datacrystals/InverterGen5/Boards/ControlBoard/ControlBoard.step

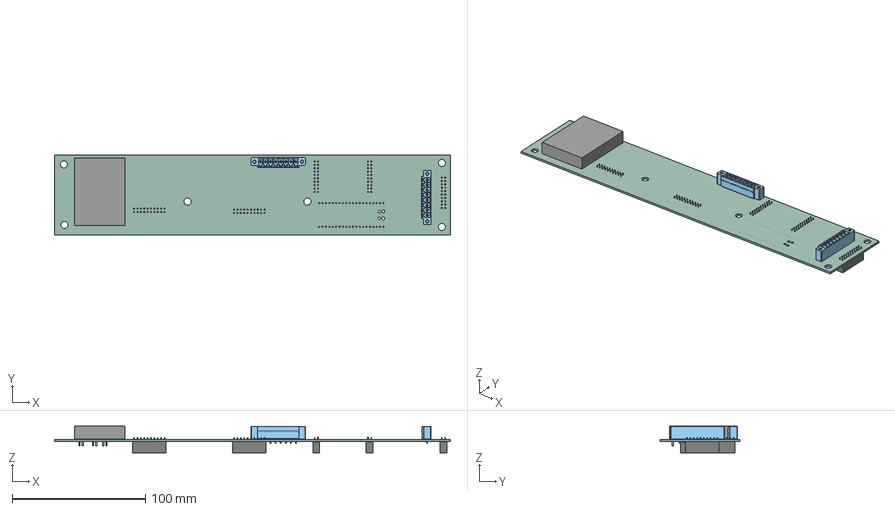
[picture p2: CAD file, 2026-01-23]
Boards/ControlBoard/ControlBoard.step
297.5 x 60.0 x 20.1 mm
TBP02R2W-381-08BE x 2
Pico
Leads
PinSocket_2x10_P2.54mm_Vertical x 5
ControlBoard_PCB
