datacrystals/InverterGen5/Boards/DCBusCapacitorBoard/DCBusCapacitorBoard.step

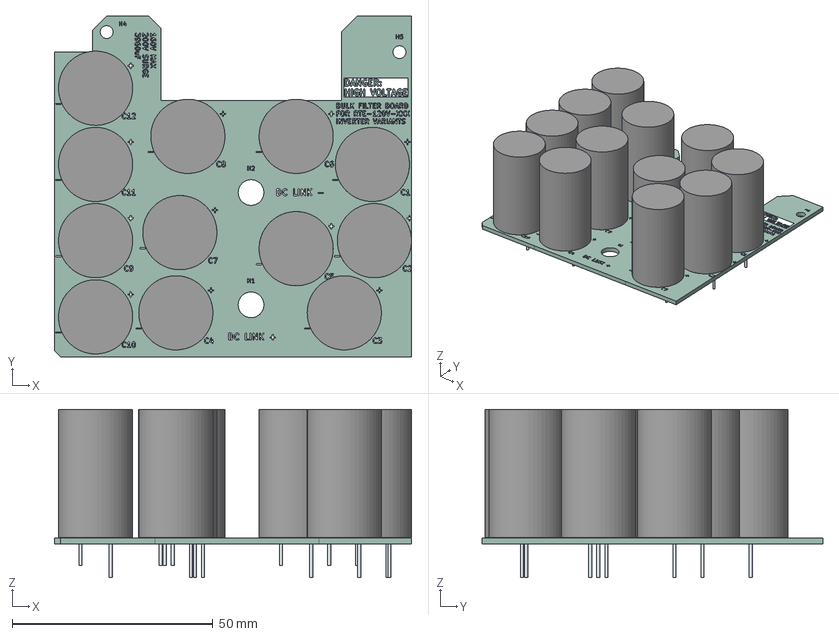
[picture p3: CAD file, 2026-02-06]
Boards/DCBusCapacitorBoard/DCBusCapacitorBoard.step
89.0 x 85.0 x 42.0 mm
SimpleBody x 12
Pin1 x 12
Pin2 x 12
DCBusCapacitorBoard_copper
DCBusCapacitorBoard_silkscreen
DCBusCapacitorBoard_PCB
