datacrystals/InverterGen5/Boards/DCBusFilter/DCBusFilter.step

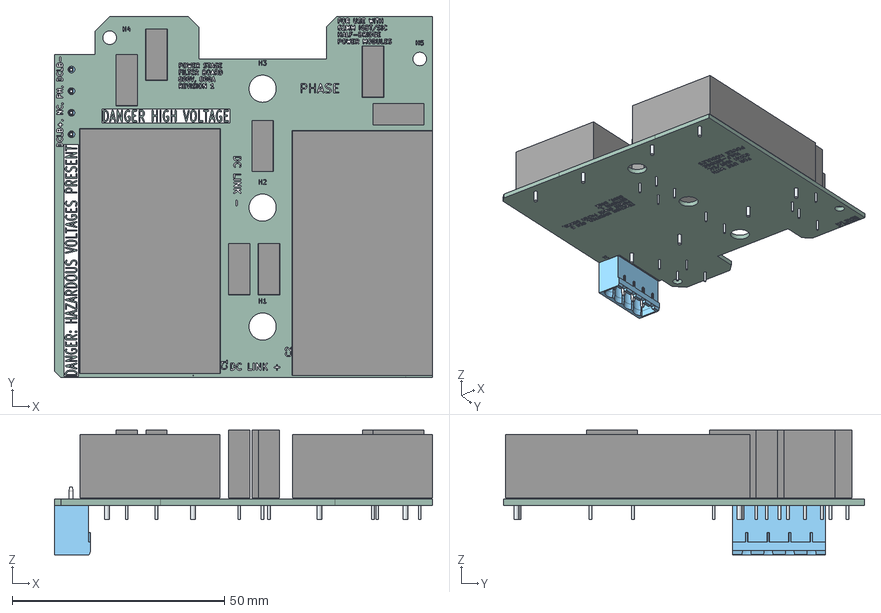
[picture p4: CAD file, 2026-02-06]
Boards/DCBusFilter/DCBusFilter.step
89.0 x 85.0 x 29.4 mm
Leads x 16
TBP01R2-508-04BE
DCBusFilter_copper
DCBusFilter_silkscreen
DCBusFilter_PCB
