datacrystals/InverterGen5/Mechanical/FF600R12KE4BOSA1/3D/FF600R12KE4BOSA1.stp

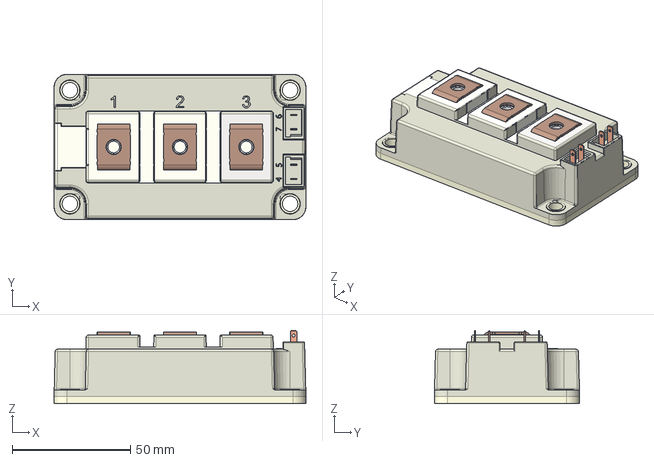
[picture p6: CAD file, 2026-01-23]
Mechanical/FF600R12KE4BOSA1/3D/FF600R12KE4BOSA1.stp
106.4 x 61.4 x 30.9 mm
