datacrystals/InverterGen5/Mechanical/L06P800S05/3D/L06P800S05.stp

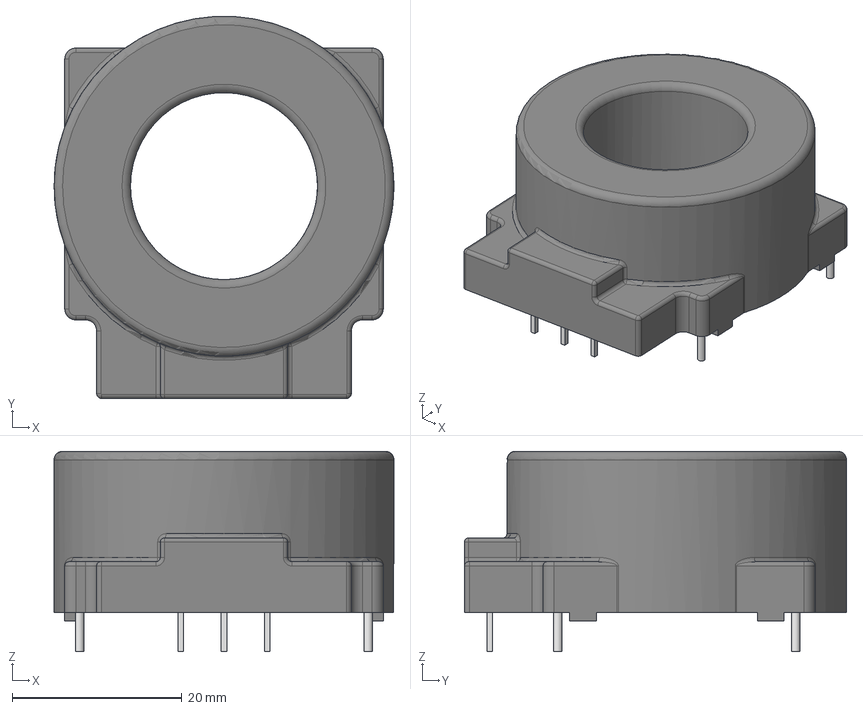
[picture p7: CAD file, 2026-01-23]
Mechanical/L06P800S05/3D/L06P800S05.stp
40.0 x 45.0 x 23.6 mm
