datacrystals/InverterGen5/Mechanical/LA37S600S05KM/3D/LA37S600S05KM.stp

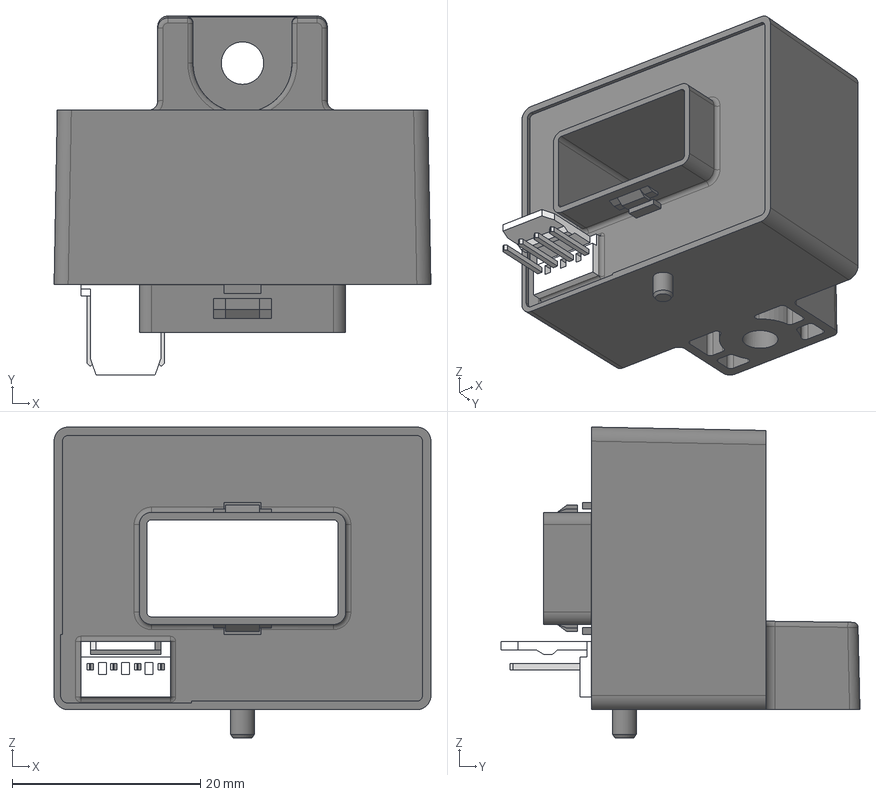
[picture p8: CAD file, 2026-01-23]
Mechanical/LA37S600S05KM/3D/LA37S600S05KM.stp
40.0 x 38.1 x 33.0 mm
