datacrystals/InverterGen5/Mechanical/TBP01P1-508-04BE/3D/TBP01P1-508-04BE.stp

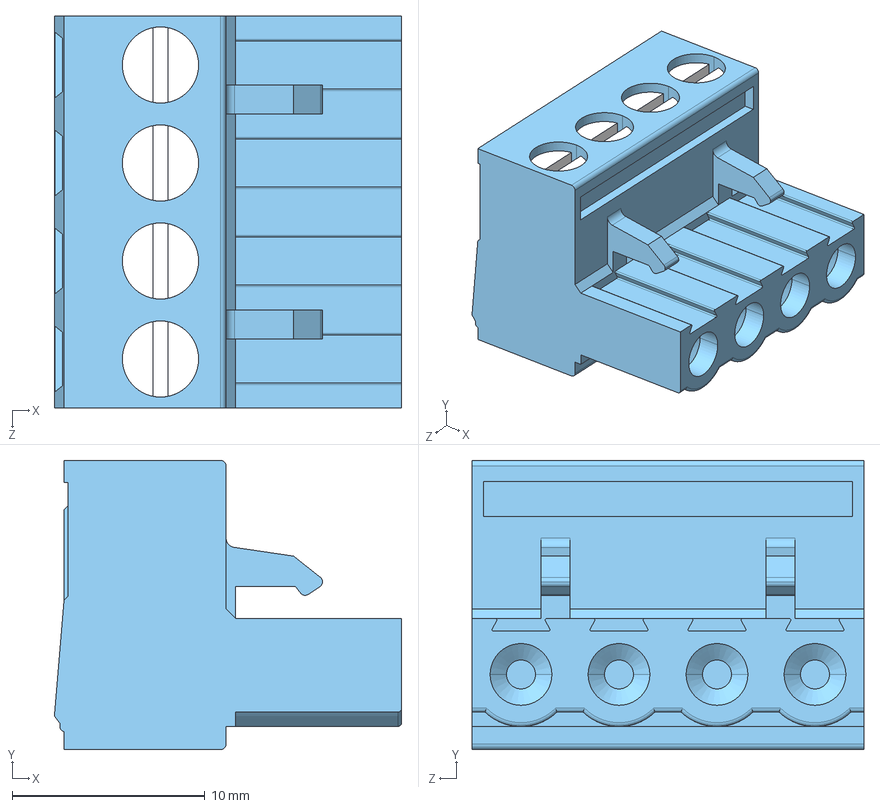
[picture p9: CAD file, 2026-01-24]
Mechanical/TBP01P1-508-04BE/3D/TBP01P1-508-04BE.stp
18.0 x 15.0 x 20.3 mm
