datacrystals/InverterGen5/Mechanical/TBP01P1-508-06BE/3D/TBP01P1-508-06BE.stp

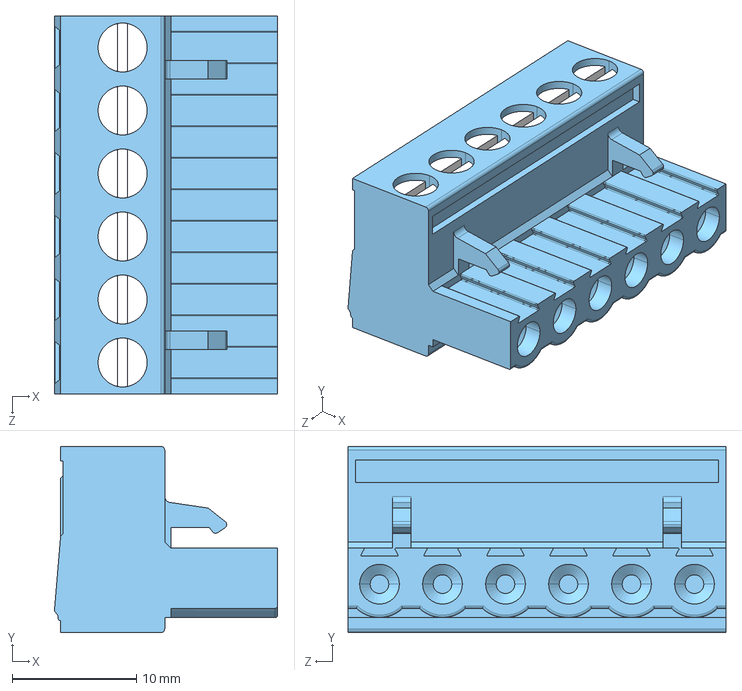
[picture p10: CAD file, 2026-01-23]
Mechanical/TBP01P1-508-06BE/3D/TBP01P1-508-06BE.stp
18.0 x 15.0 x 30.5 mm
