datacrystals/InverterGen5/PartsLib/3D/SCW20A-15.stp

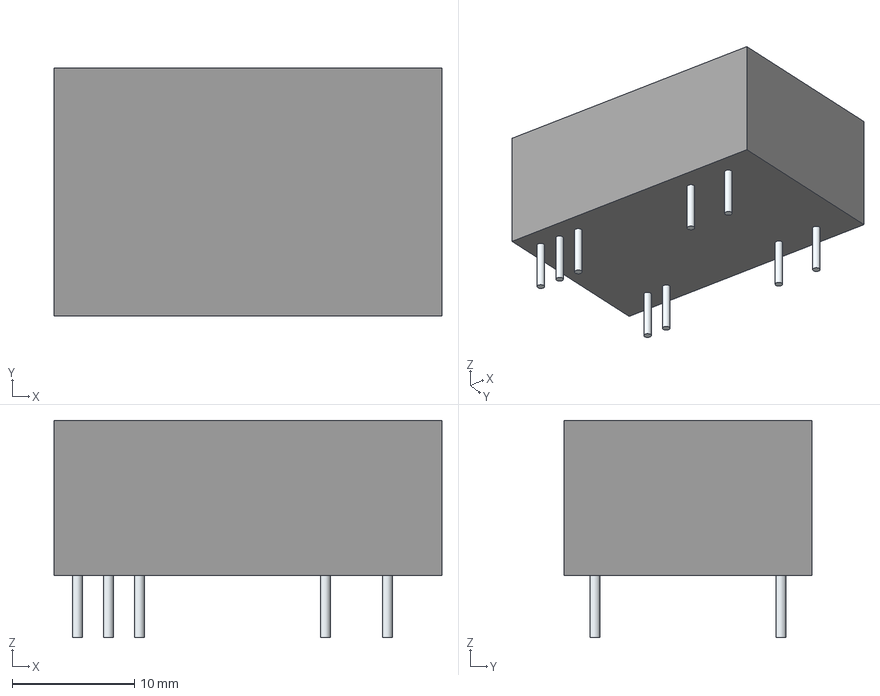
[picture p11: CAD file, 2026-02-06]
PartsLib/3D/SCW20A-15.stp
31.8 x 20.3 x 17.8 mm
Leads
