datacrystals/InverterGen5/PartsLib/3D/UCS2C331MHD.stp

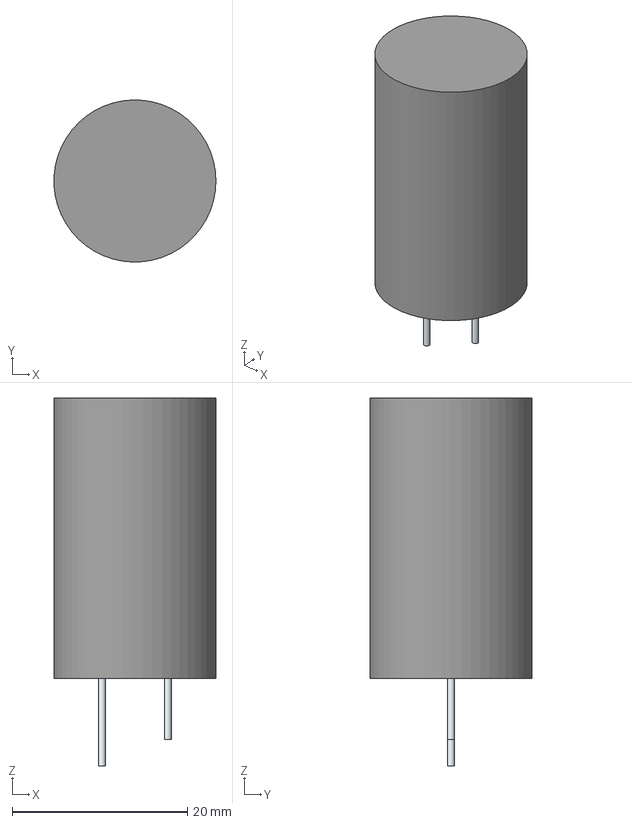
[picture p12: CAD file, 2026-02-06]
PartsLib/3D/UCS2C331MHD.stp
18.5 x 18.5 x 42.0 mm
SimpleBody
Pin1
Pin2
