datacrystals/InverterGen5/PartsLib/3D/MKP1848S61010JY5B.stp

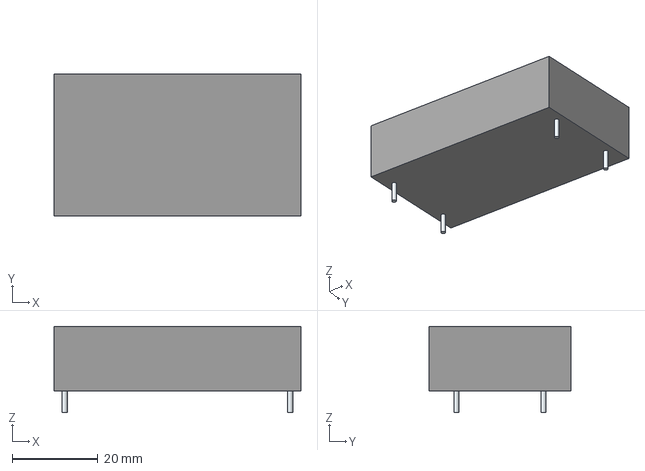
[picture p13: CAD file, 2026-02-06]
PartsLib/3D/MKP1848S61010JY5B.stp
57.5 x 33.0 x 20.1 mm
Leads
