datacrystals/InverterGen5/Mechanical/RaspberryPi_Pico_W_AddedHeaders.step

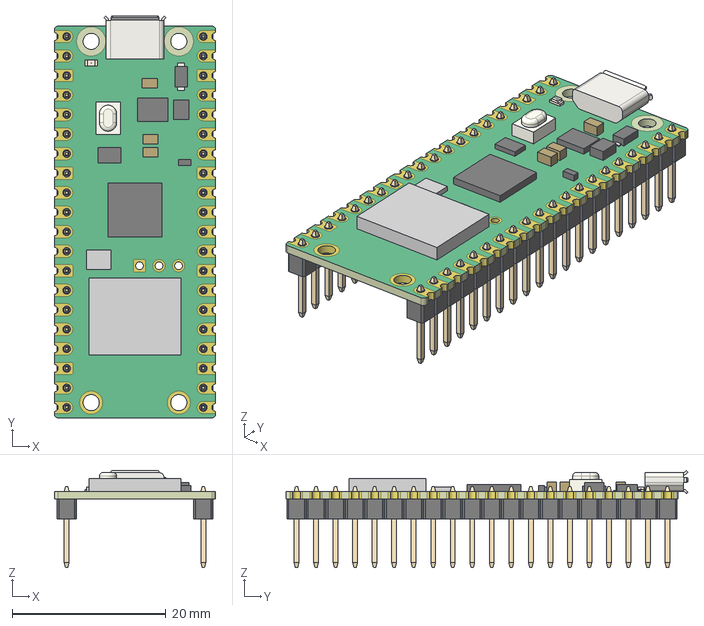
[picture p14: CAD file, 2026-01-25]
Mechanical/RaspberryPi_Pico_W_AddedHeaders.step
21.0 x 52.3 x 12.6 mm
