datacrystals/InverterGen5/PartsLib/3D/VY1222M47Y5UQ6TV0.stp

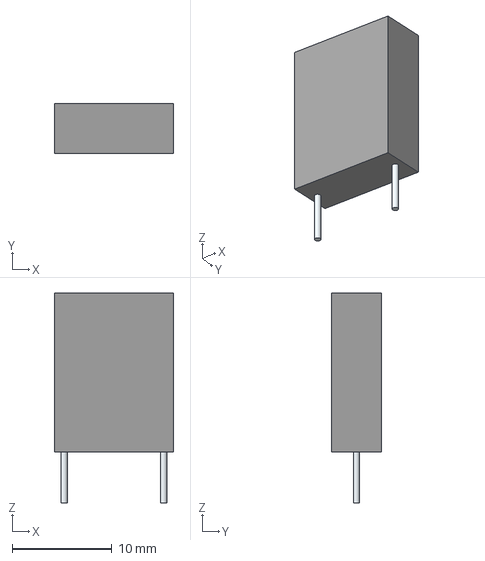
[picture p15: CAD file, 2026-01-25]
PartsLib/3D/VY1222M47Y5UQ6TV0.stp
12.0 x 5.00 x 21.1 mm
Leads x 2
