datacrystals/InverterGen5/PartsLib/3D/TBP01R2-508-06BE.stp

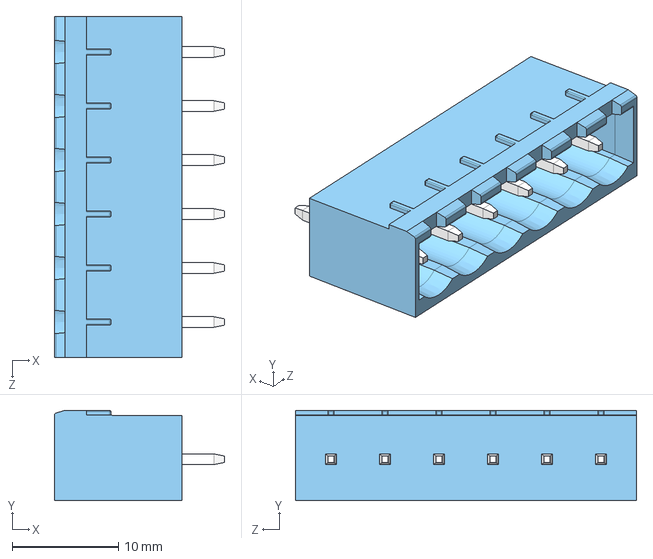
[picture p16: CAD file, 2026-01-24]
PartsLib/3D/TBP01R2-508-06BE.stp
16.0 x 8.50 x 32.1 mm
