datacrystals/InverterGen5/PartsLib/3D/MJE3055TG.stp

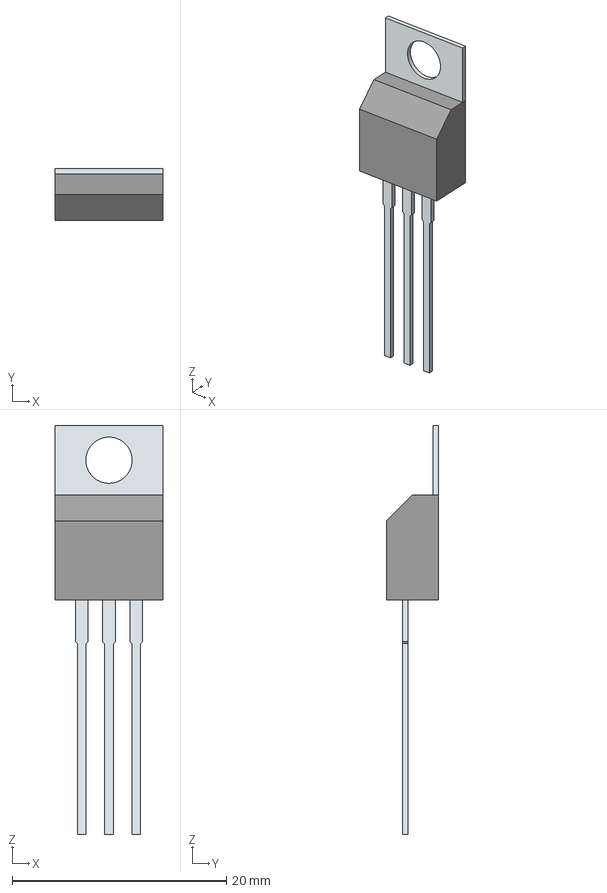
[picture p17: CAD file, 2026-01-23]
PartsLib/3D/MJE3055TG.stp
10.1 x 4.83 x 38.1 mm
Tab
PinsArray
