datacrystals/InverterGen5/PartsLib/3D/DRDNB21D-7.stp

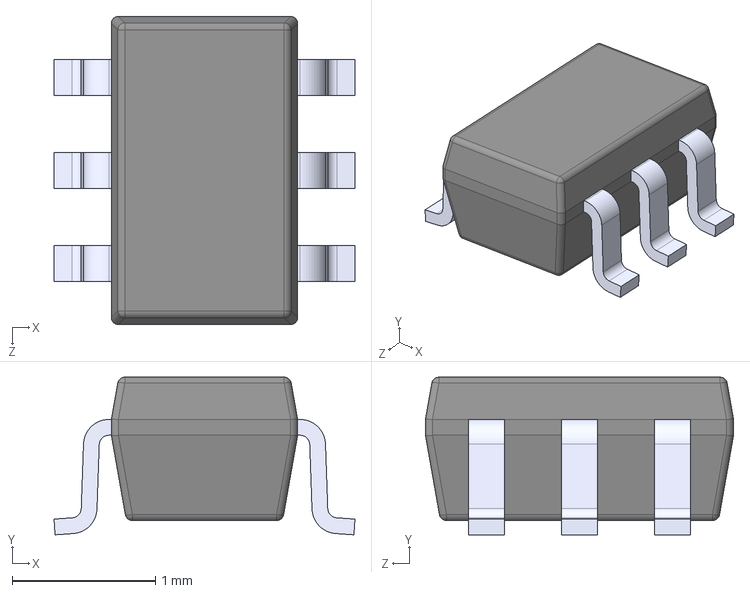
[picture p18: CAD file, 2026-01-23]
PartsLib/3D/DRDNB21D-7.stp
2.10 x 1.10 x 2.15 mm
