datacrystals/InverterGen5/PartsLib/3D/REC10K-2415SAW_H2.stp

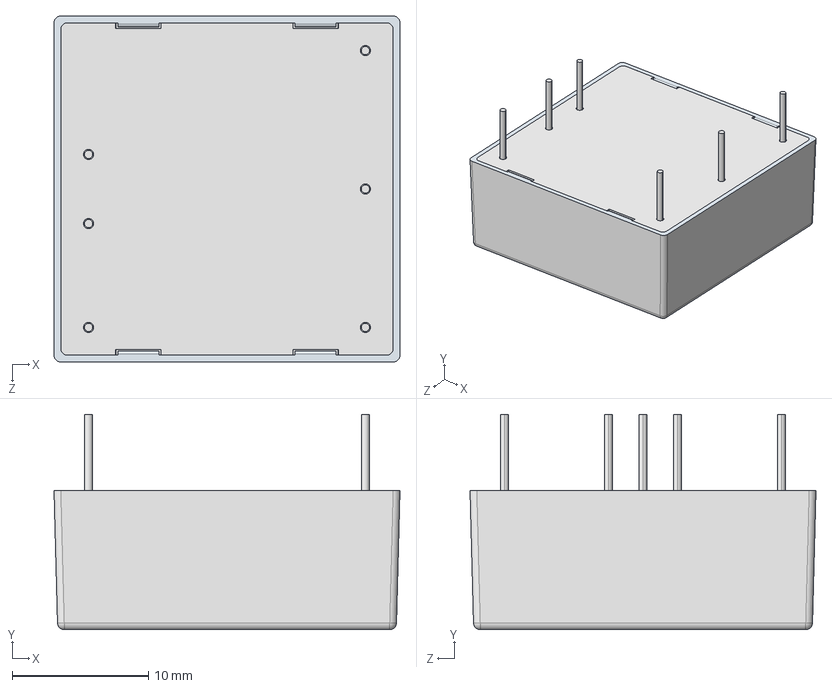
[picture p19: CAD file, 2026-01-23]
PartsLib/3D/REC10K-2415SAW_H2.stp
25.4 x 15.8 x 25.4 mm
