datacrystals/InverterGen5/PartsLib/3D/SN74LXCH8T245PWR.stp

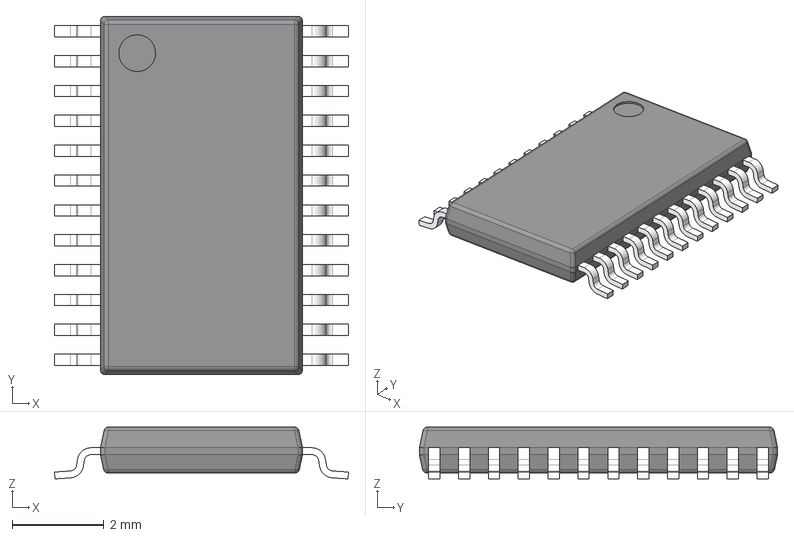
[picture p20: CAD file, 2026-01-23]
PartsLib/3D/SN74LXCH8T245PWR.stp
6.40 x 7.80 x 1.13 mm
BODY-TSSOP
LEAD-TSSOP x 24
PIN1
