datacrystals/InverterGen5/PartsLib/3D/TMP236A2DCKR.stp

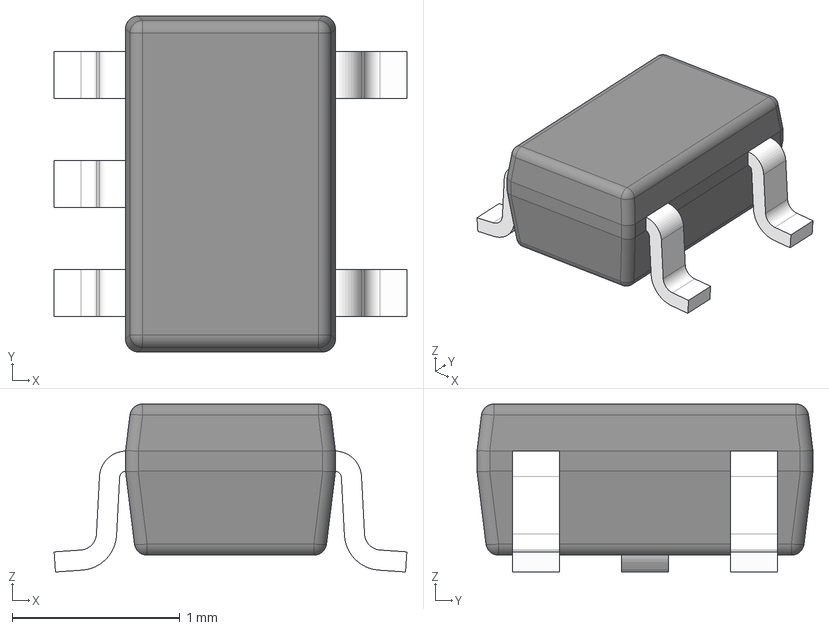
[picture p21: CAD file, 2026-01-23]
PartsLib/3D/TMP236A2DCKR.stp
2.10 x 2.00 x 1.00 mm
BODY-SOT
LEAD-SOT x 5
PIN1-ID
