datacrystals/InverterGen5/PartsLib/3D/FBMJ1608HS220NTR.stp

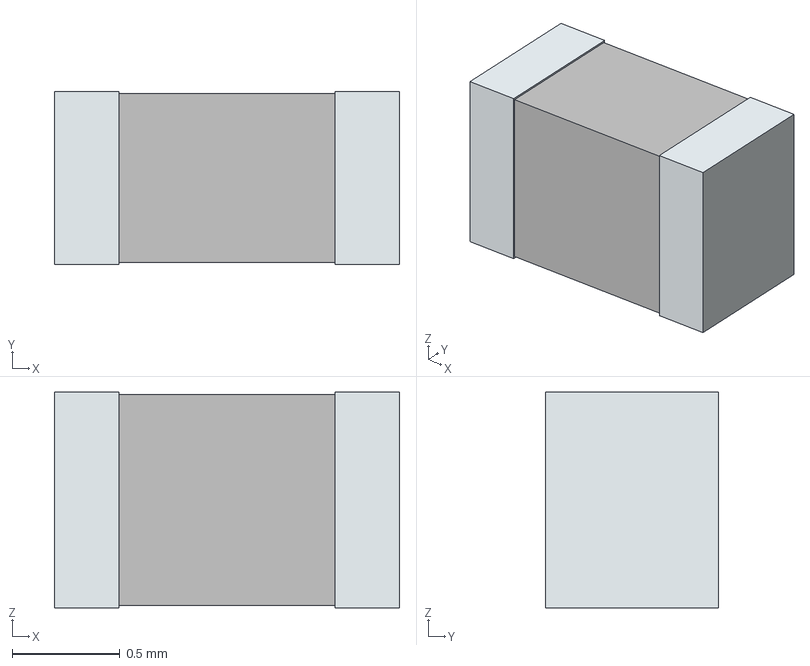
[picture p22: CAD file, 2026-01-23]
PartsLib/3D/FBMJ1608HS220NTR.stp
1.60 x 0.8 x 1.00 mm
term1
term2
