datacrystals/InverterGen5/PartsLib/3D/TBP02R1-381-02BE.stp

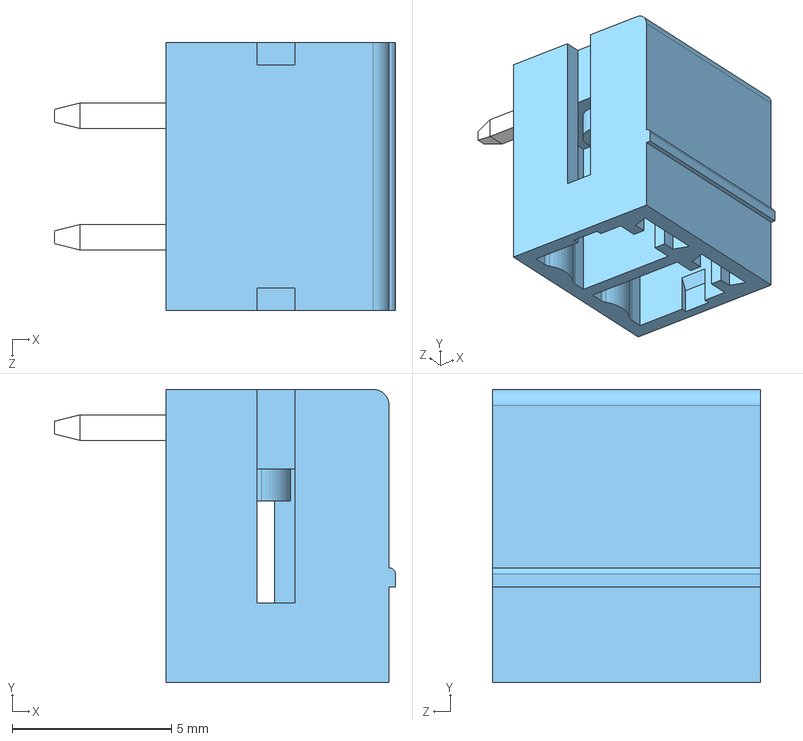
[picture p23: CAD file, 2026-01-23]
PartsLib/3D/TBP02R1-381-02BE.stp
10.7 x 9.20 x 8.41 mm
