datacrystals/InverterGen5/PartsLib/3D/677-15ABPE.stp

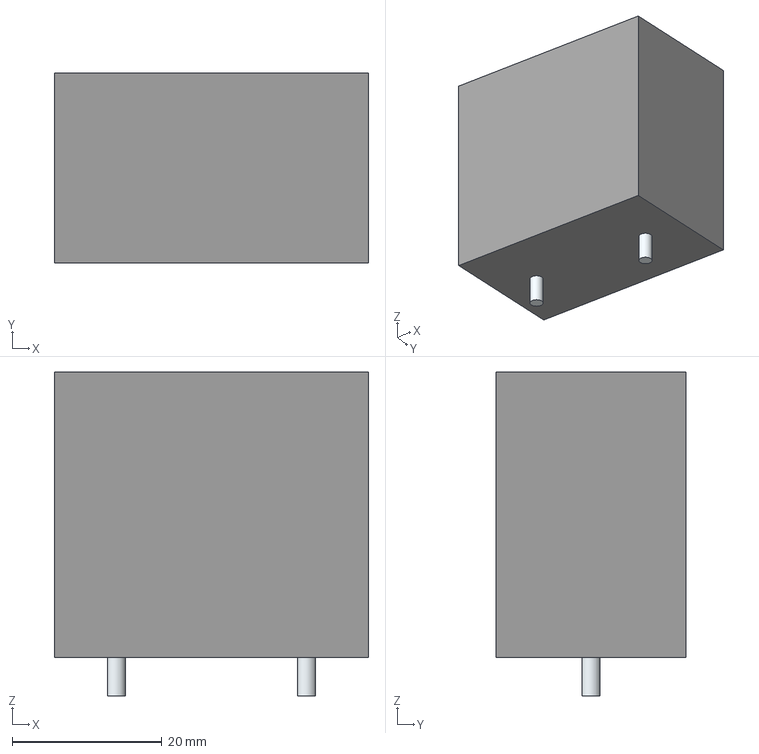
[picture p24: CAD file, 2026-01-23]
PartsLib/3D/677-15ABPE.stp
41.9 x 25.4 x 43.2 mm
Leads
