datacrystals/InverterGen5/PartsLib/3D/LTST-C230CKT.stp

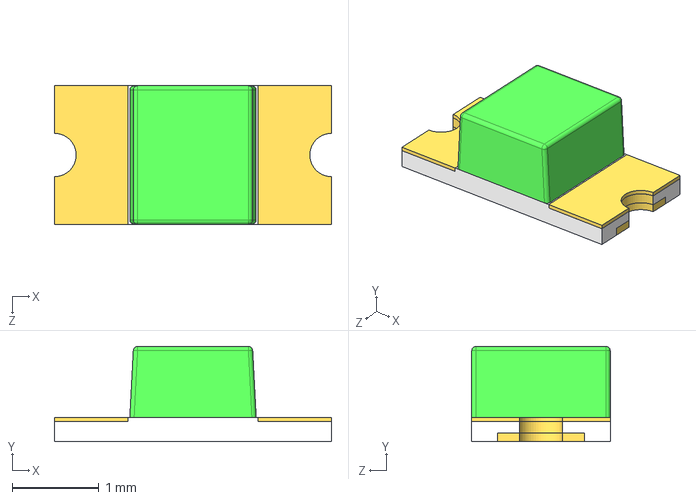
[picture p25: CAD file, 2026-01-23]
PartsLib/3D/LTST-C230CKT.stp
3.20 x 1.10 x 1.60 mm
