datacrystals/InverterGen5/PartsLib/3D/C4AQNBW5200M3LJ.stp

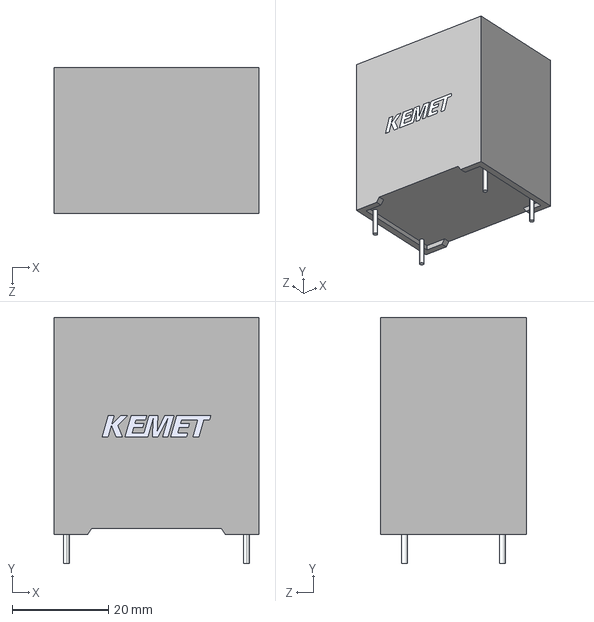
[picture p27: CAD file, 2026-01-23]
PartsLib/3D/C4AQNBW5200M3LJ.stp
42.6 x 51.2 x 30.4 mm
