datacrystals/InverterGen5/PartsLib/3D/MCP2515-e_ST.stp

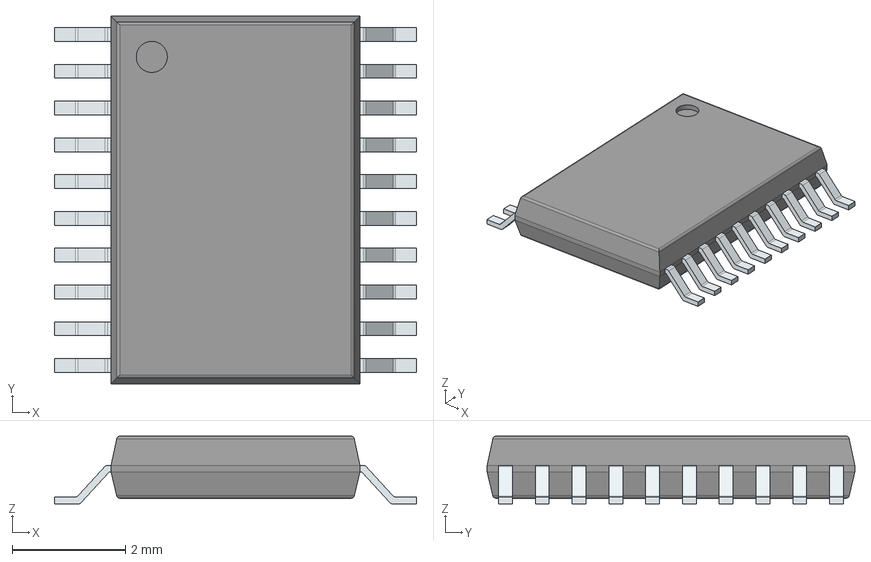
[picture p28: CAD file, 2026-01-23]
PartsLib/3D/MCP2515-e_ST.stp
6.40 x 6.50 x 1.20 mm
PinsArrayLR
