datacrystals/InverterGen5/PartsLib/3D/1SMB5956BT3G.stp

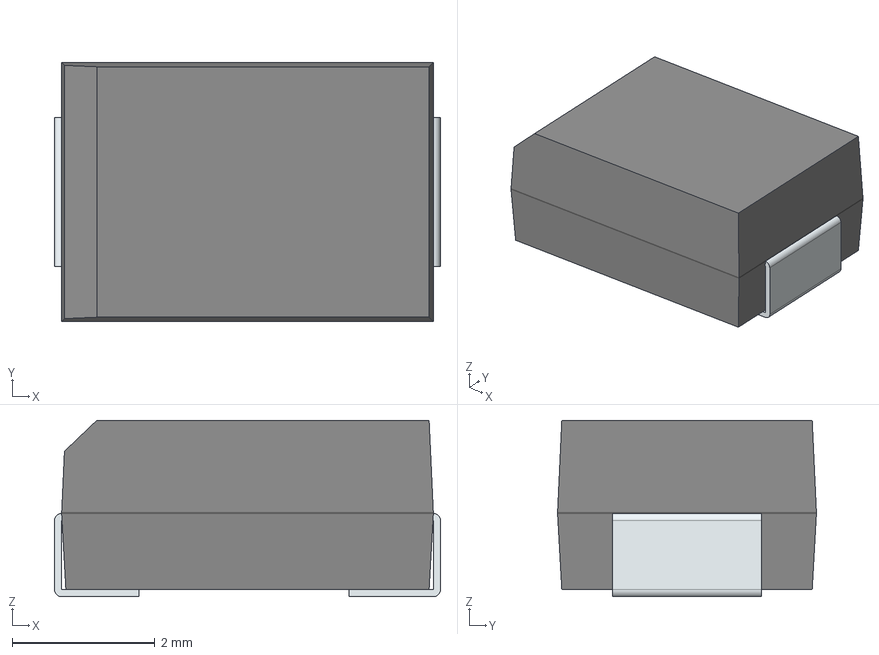
[picture p29: CAD file, 2026-01-23]
PartsLib/3D/1SMB5956BT3G.stp
5.41 x 3.62 x 2.47 mm
FilletPin1
FilletPin2
