datacrystals/InverterGen5/PartsLib/3D/R-78K3.3-1.0.stp

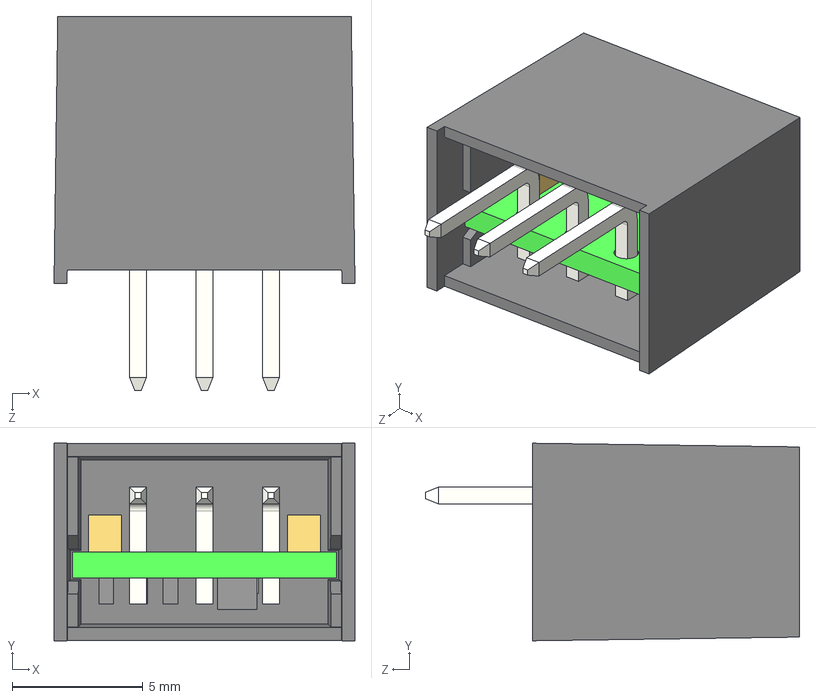
[picture p30: CAD file, 2026-01-23]
PartsLib/3D/R-78K3.3-1.0.stp
11.5 x 7.55 x 14.3 mm
