datacrystals/InverterGen5/PartsLib/3D/JCB0312S24.stp

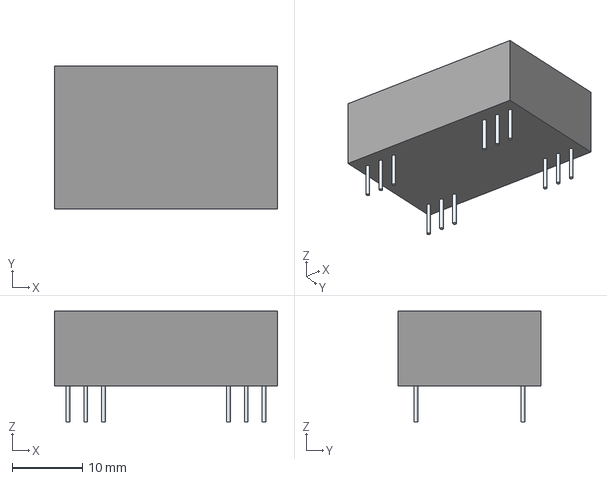
[picture p31: CAD file, 2026-01-23]
PartsLib/3D/JCB0312S24.stp
31.8 x 20.3 x 15.8 mm
Leads
