datacrystals/InverterGen5/PartsLib/3D/TBP01R1-508-08BE.stp

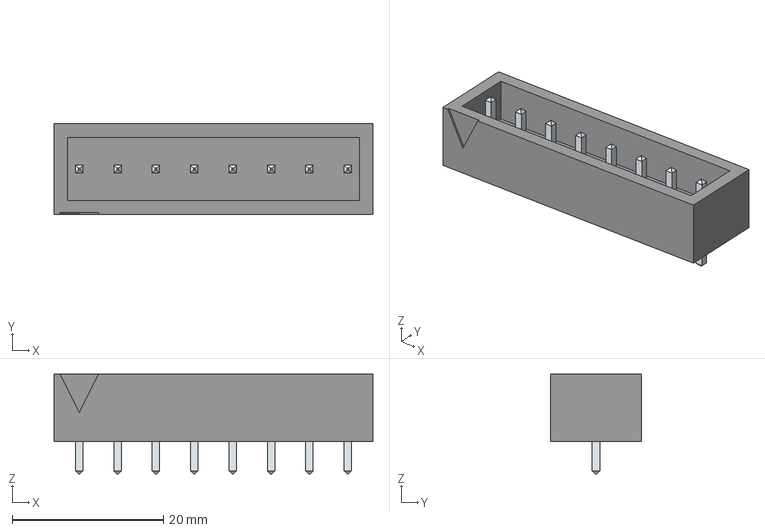
[picture p32: CAD file, 2026-01-23]
PartsLib/3D/TBP01R1-508-08BE.stp
42.2 x 12.0 x 13.2 mm
LeadsArray
