datacrystals/InverterGen5/PartsLib/3D/S3N.stp

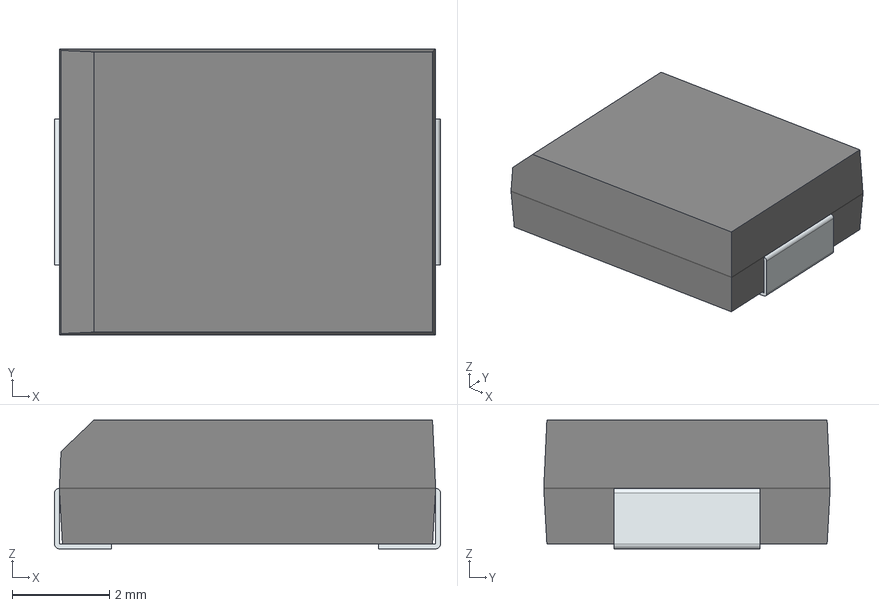
[picture p33: CAD file, 2026-01-23]
PartsLib/3D/S3N.stp
7.95 x 5.90 x 2.65 mm
FilletPin1
FilletPin2
