datacrystals/InverterGen5/PartsLib/3D/TPL7407LAQPWRQ1.stp

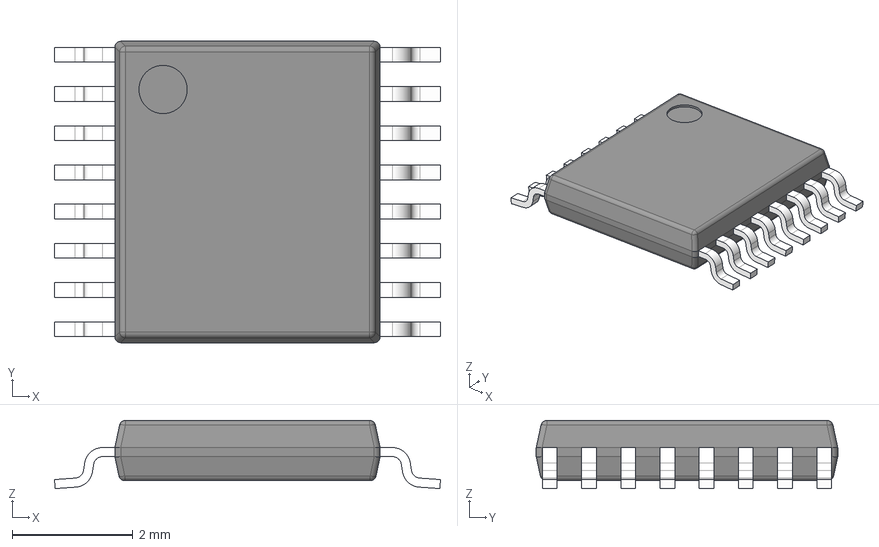
[picture p34: CAD file, 2026-01-23]
PartsLib/3D/TPL7407LAQPWRQ1.stp
6.40 x 5.00 x 1.13 mm
BODY-TSSOP
LEAD-TSSOP x 16
PIN1
