datacrystals/InverterGen5/PartsLib/3D/FZ400R12KE4.stp

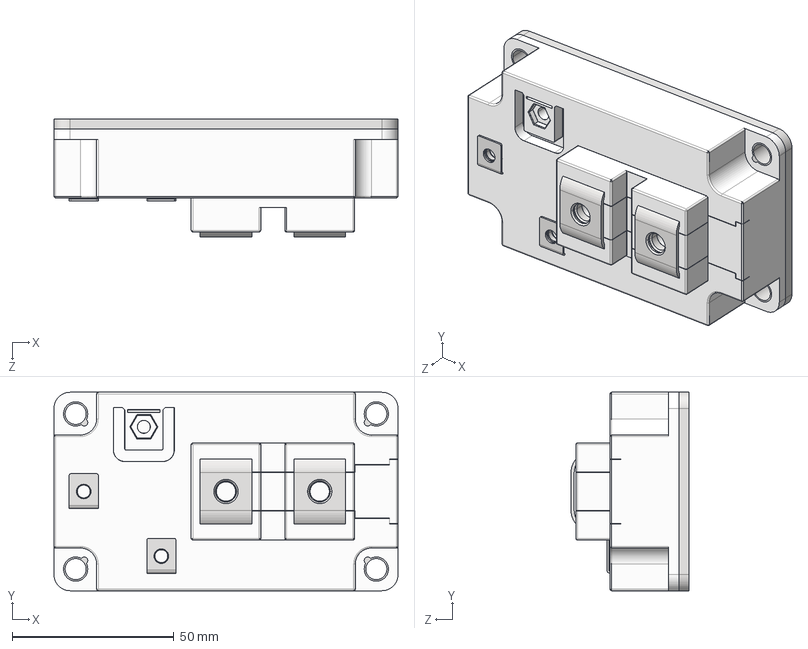
[picture p35: CAD file, 2026-01-23]
PartsLib/3D/FZ400R12KE4.stp
106.4 x 61.4 x 36.5 mm
heatsink
rings
top x 2
nut 2 terminal
terminal small
