datacrystals/InverterGen5/PartsLib/3D/VS-30CDU06HM3_I.stp

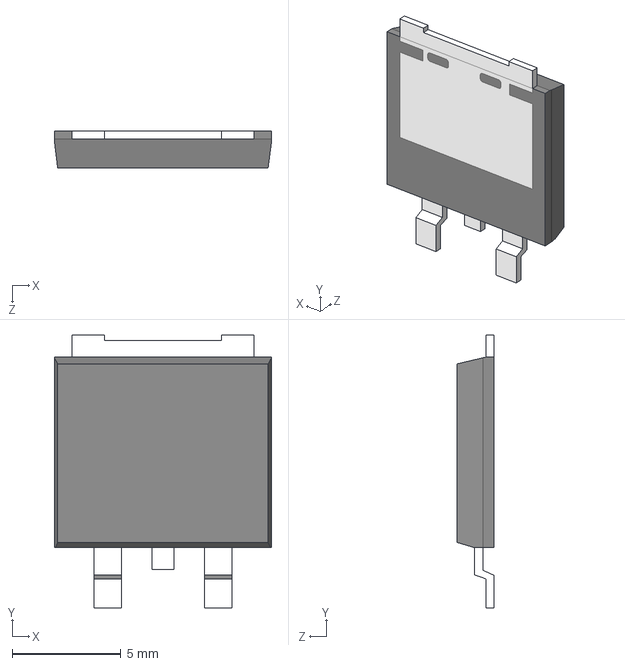
[picture p36: CAD file, 2026-01-23]
PartsLib/3D/VS-30CDU06HM3_I.stp
10.0 x 12.6 x 1.70 mm
