datacrystals/InverterGen5/PartsLib/3D/FM2000GP-TP.stp

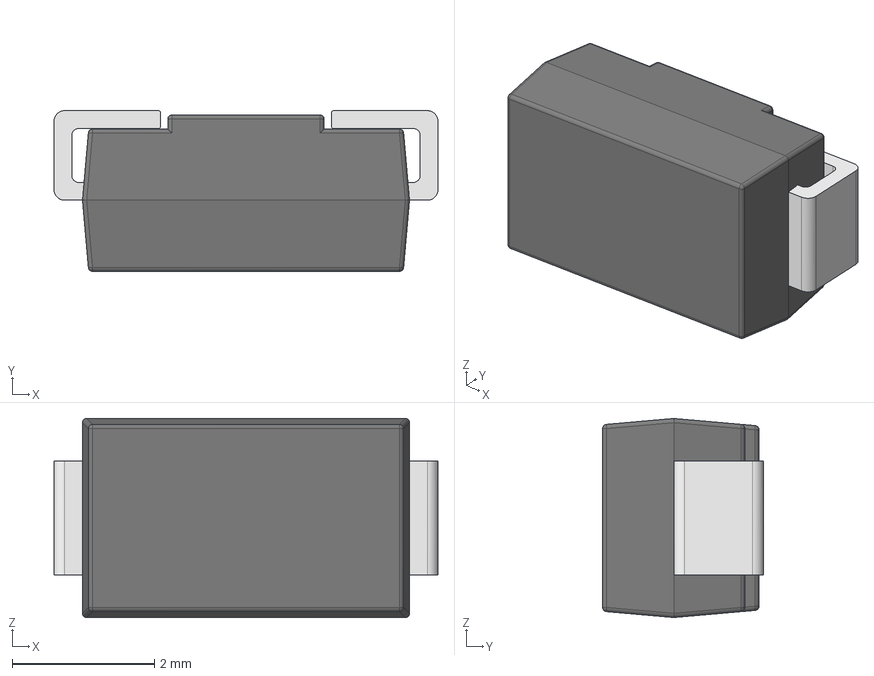
[picture p37: CAD file, 2026-01-23]
PartsLib/3D/FM2000GP-TP.stp
5.40 x 2.26 x 2.80 mm
��1
��2
