datacrystals/InverterGen5/PartsLib/3D/BAT54WS-7-F.stp

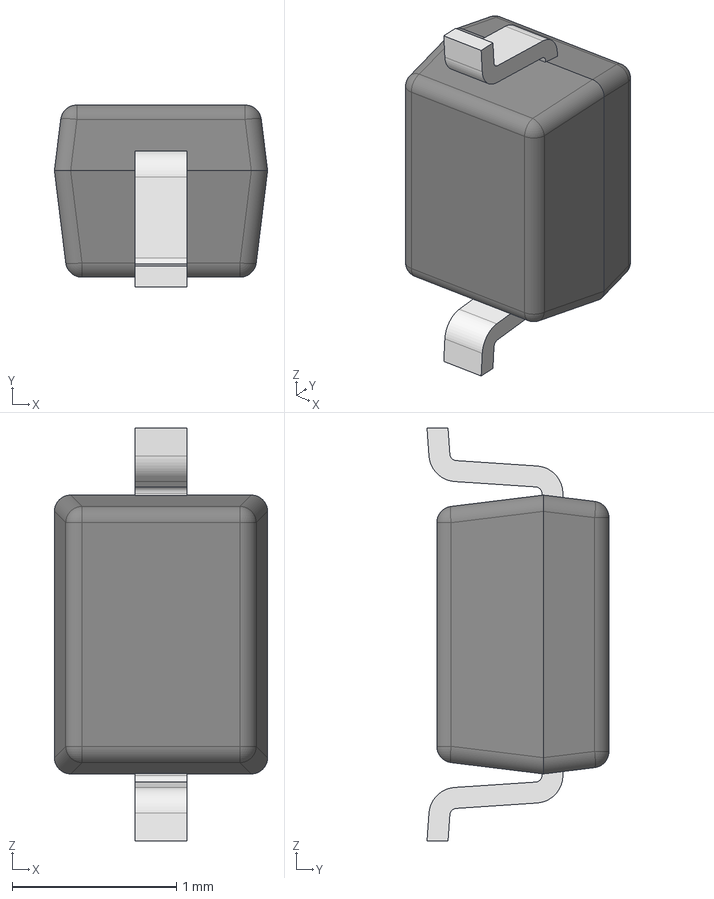
[picture p38: CAD file, 2026-01-23]
PartsLib/3D/BAT54WS-7-F.stp
1.30 x 1.11 x 2.52 mm
SOD323-PCB-001
SOD323-LP-001
