datacrystals/InverterGen5/PartsLib/3D/MUR1100ERLG.stp

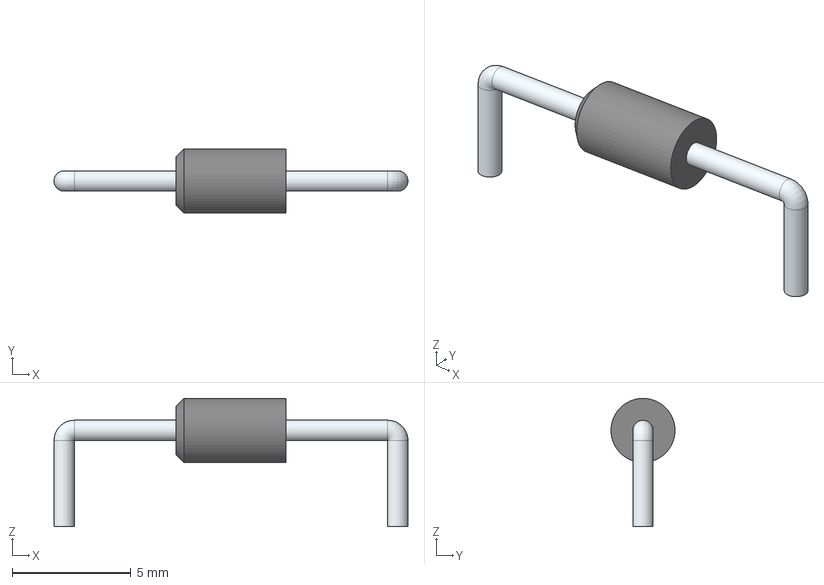
[picture p39: CAD file, 2026-01-23]
PartsLib/3D/MUR1100ERLG.stp
14.9 x 2.70 x 5.40 mm
