datacrystals/InverterGen5/PartsLib/3D/ACS772ECB-400B-PFF-T.stp

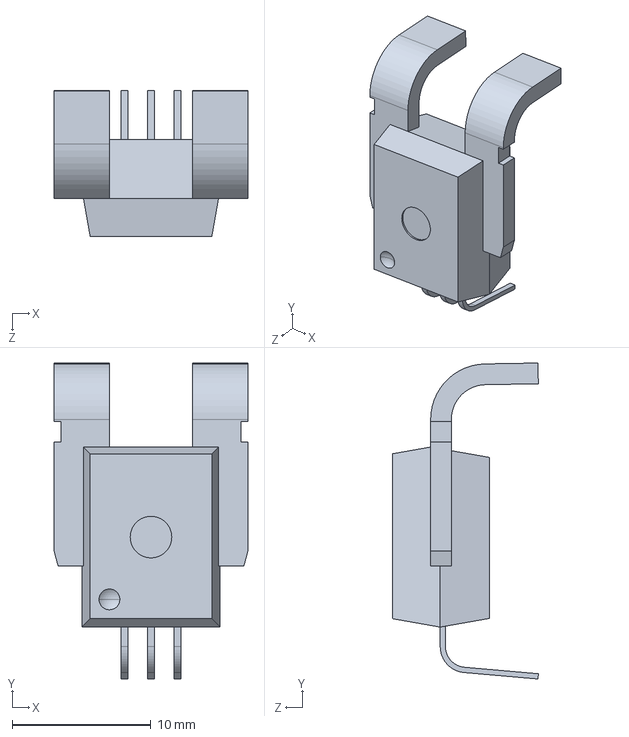
[picture p40: CAD file, 2026-01-23]
PartsLib/3D/ACS772ECB-400B-PFF-T.stp
14.0 x 22.8 x 10.5 mm
