datacrystals/InverterGen5/PartsLib/3D/ADS8688AIDBT.stp

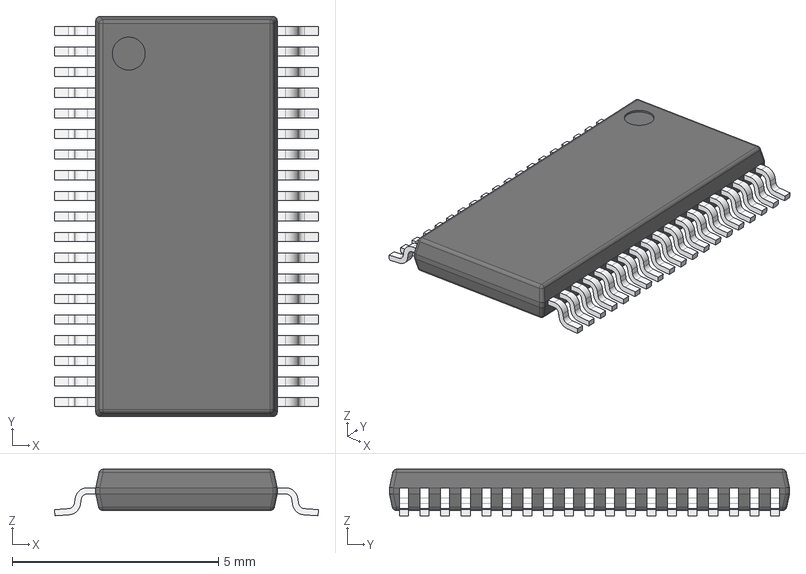
[picture p41: CAD file, 2026-01-23]
PartsLib/3D/ADS8688AIDBT.stp
6.40 x 9.70 x 1.13 mm
BODY-TSSOP
LEAD-TSSOP x 38
PIN1
