datacrystals/InverterGen5/PartsLib/3D/TBP01R2-508-04BE.stp

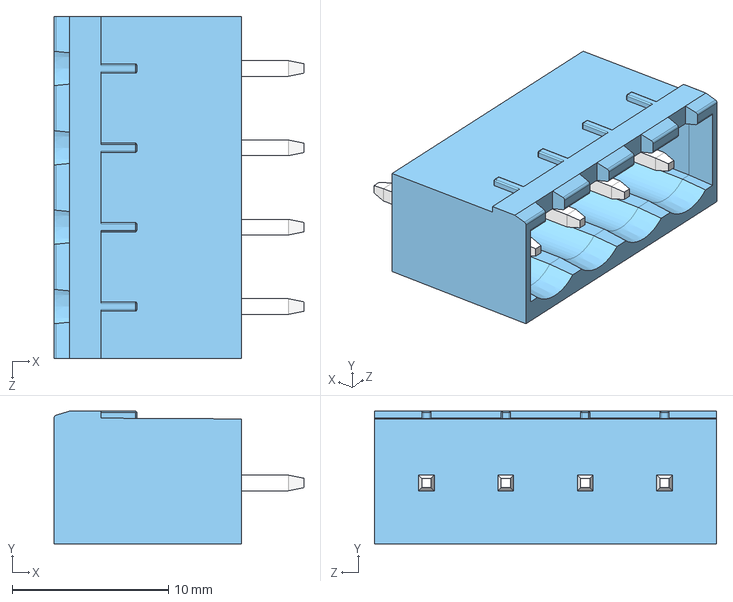
[picture p42: CAD file, 2026-01-23]
PartsLib/3D/TBP01R2-508-04BE.stp
16.0 x 8.50 x 21.9 mm
