datacrystals/InverterGen5/PartsLib/3D/IHDM1008BCEV2R2M20.stp

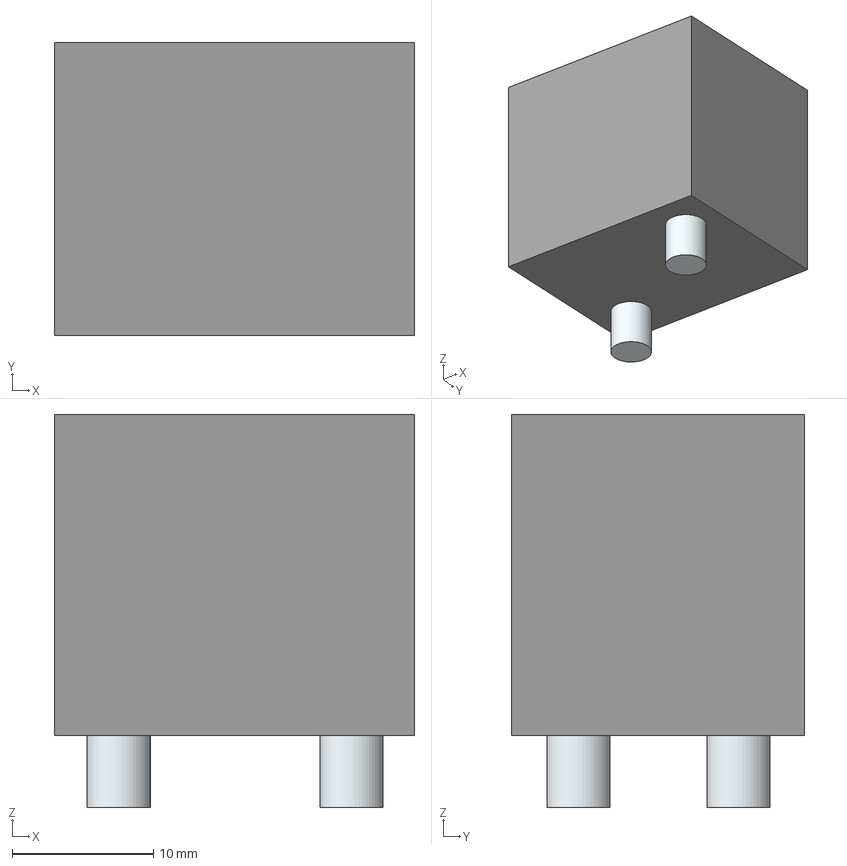
[picture p43: CAD file, 2026-01-23]
PartsLib/3D/IHDM1008BCEV2R2M20.stp
25.5 x 20.7 x 27.9 mm
Leads
