datacrystals/InverterGen5/PartsLib/3D/ACT45B-101-2P-TL003.stp

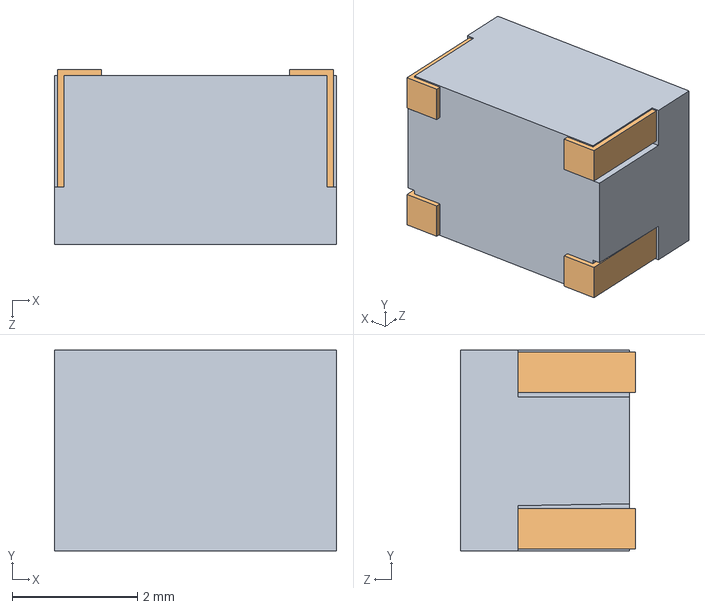
[picture p44: CAD file, 2026-01-23]
PartsLib/3D/ACT45B-101-2P-TL003.stp
4.50 x 3.20 x 2.80 mm
ACT45B DRコアブロック(typ size)
ACT45B 端子ブロック(typ size) x 4
