datacrystals/InverterGen5/PartsLib/3D/SLPX331M200A1P3.stp

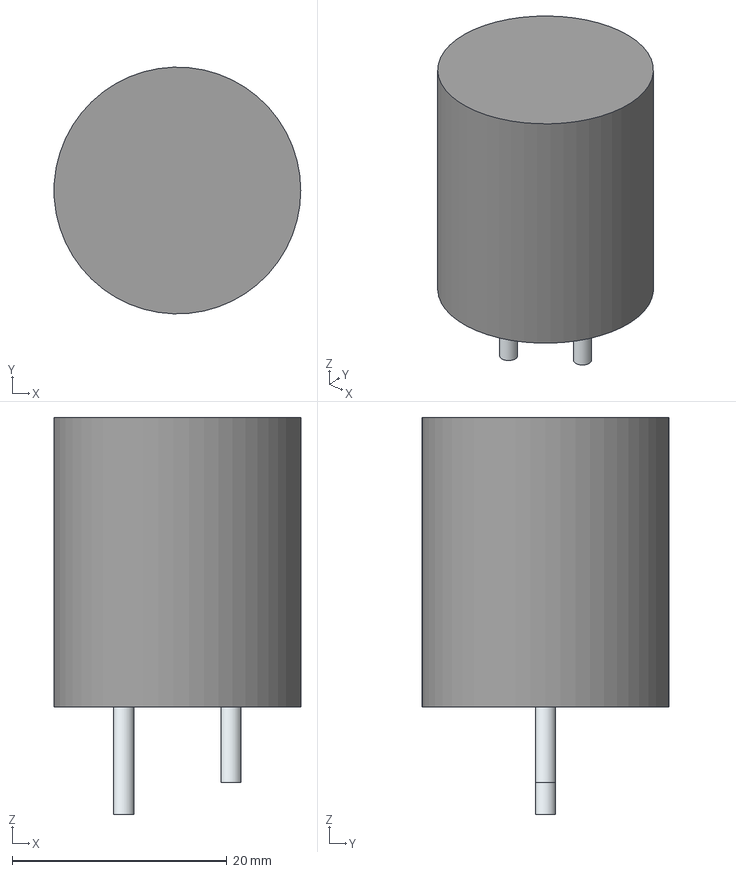
[picture p45: CAD file, 2026-01-23]
PartsLib/3D/SLPX331M200A1P3.stp
23.0 x 23.0 x 37.0 mm
SimpleBody
Pin1
Pin2
