datacrystals/InverterGen5/PartsLib/3D/MF-RHT200_32-2.stp

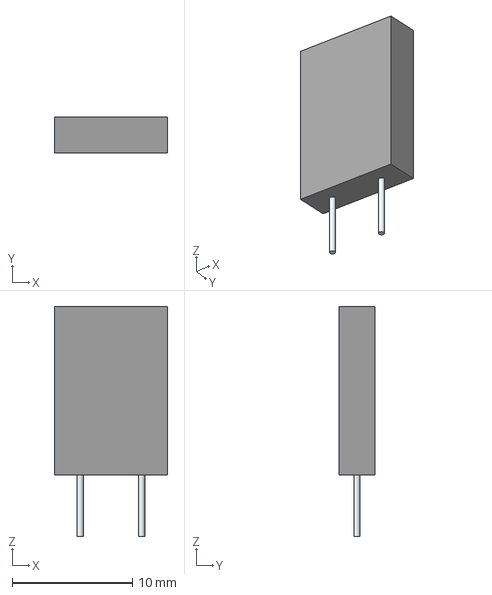
[picture p46: CAD file, 2026-01-23]
PartsLib/3D/MF-RHT200_32-2.stp
9.40 x 3.00 x 19.1 mm
Leads x 2
