datacrystals/InverterGen5/PartsLib/3D/MMSZ5231B-TP.stp

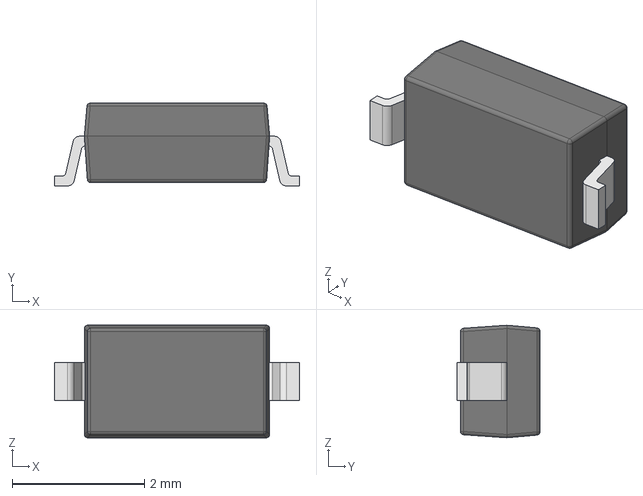
[picture p47: CAD file, 2026-01-23]
PartsLib/3D/MMSZ5231B-TP.stp
3.70 x 1.25 x 1.70 mm
��1
��2
