datacrystals/InverterGen5/PartsLib/3D/DE09-PA-M1.stp

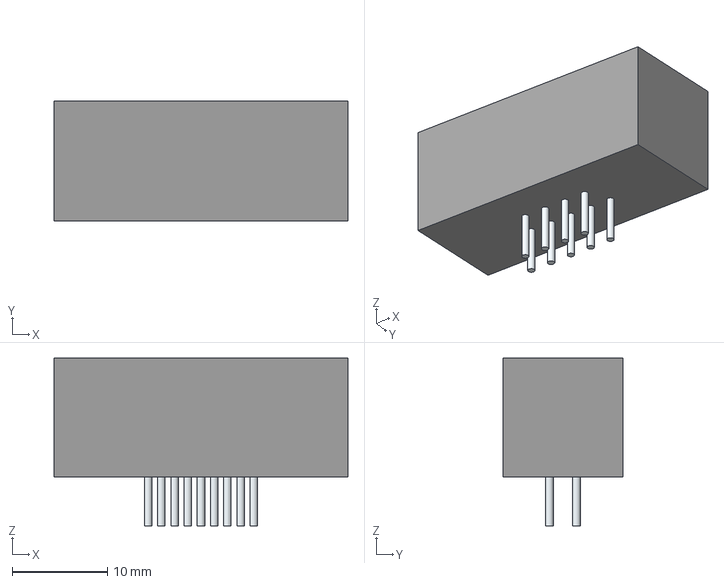
[picture p48: CAD file, 2026-01-23]
PartsLib/3D/DE09-PA-M1.stp
30.8 x 12.6 x 17.6 mm
Leads
