datacrystals/InverterGen5/PartsLib/3D/ALH82A750CB600.stp

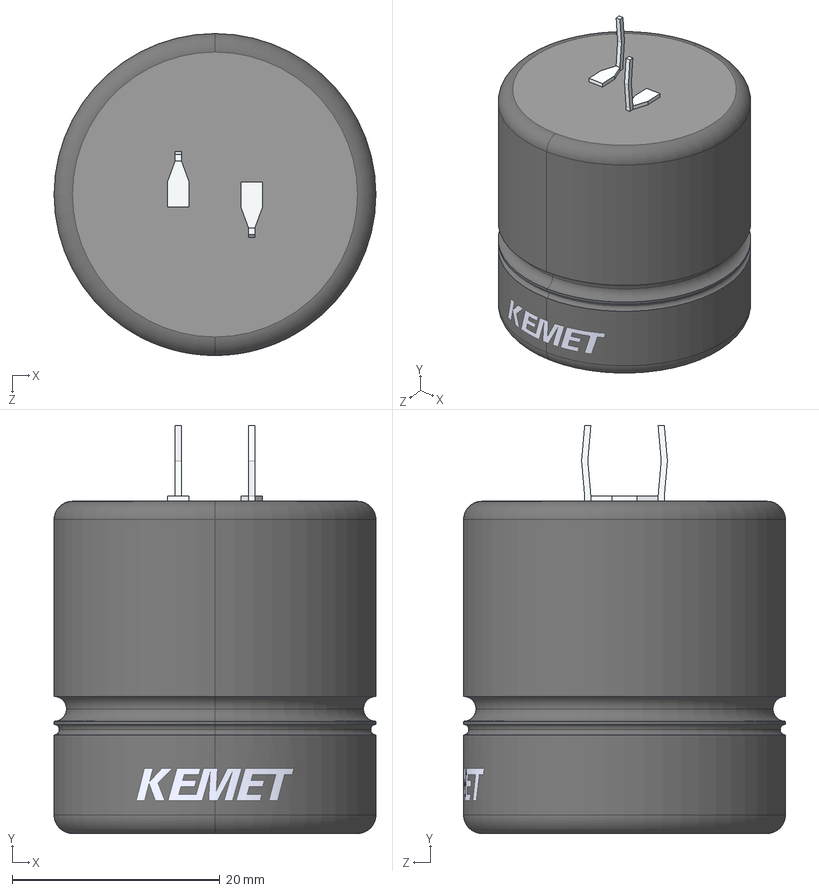
[picture p49: CAD file, 2026-01-23]
PartsLib/3D/ALH82A750CB600.stp
31.0 x 39.3 x 31.0 mm
