datacrystals/InverterGen5/PartsLib/3D/TBP01R1-508-06BE.stp

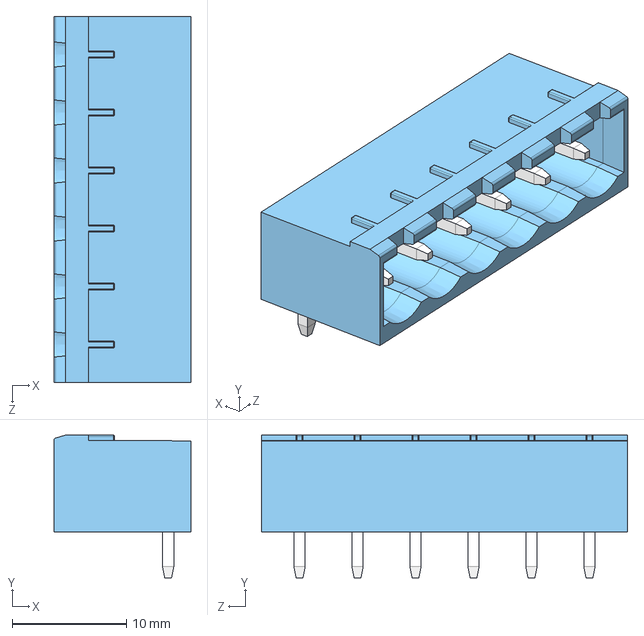
[picture p50: CAD file, 2026-01-23]
PartsLib/3D/TBP01R1-508-06BE.stp
12.0 x 12.5 x 32.1 mm
