datacrystals/InverterGen5/PartsLib/3D/TBP02R1-381-06BE.stp

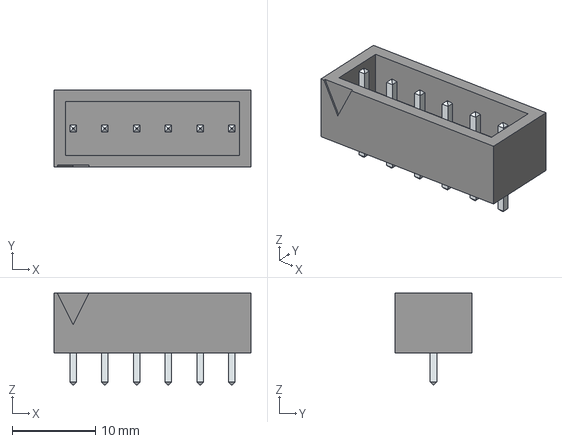
[picture p51: CAD file, 2026-01-23]
PartsLib/3D/TBP02R1-381-06BE.stp
23.7 x 9.20 x 11.0 mm
LeadsArray
