datacrystals/InverterGen5/PartsLib/3D/HCPL-316J-500E.stp

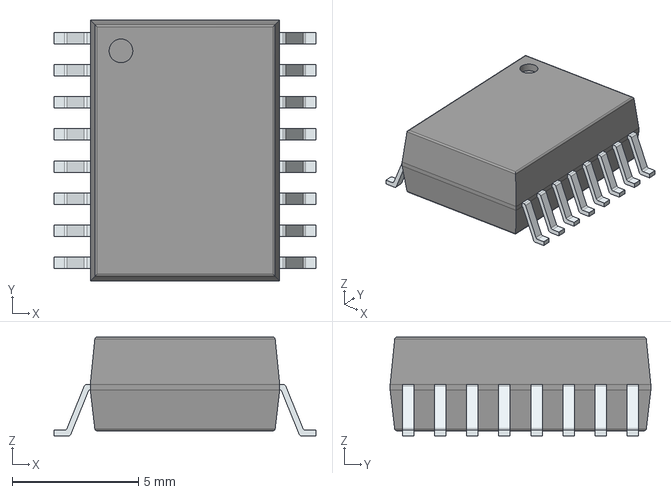
[picture p52: CAD file, 2026-01-23]
PartsLib/3D/HCPL-316J-500E.stp
10.4 x 10.3 x 3.91 mm
PinsArrayLR
