datacrystals/InverterGen5/PartsLib/3D/AWHSH105D00G.stp

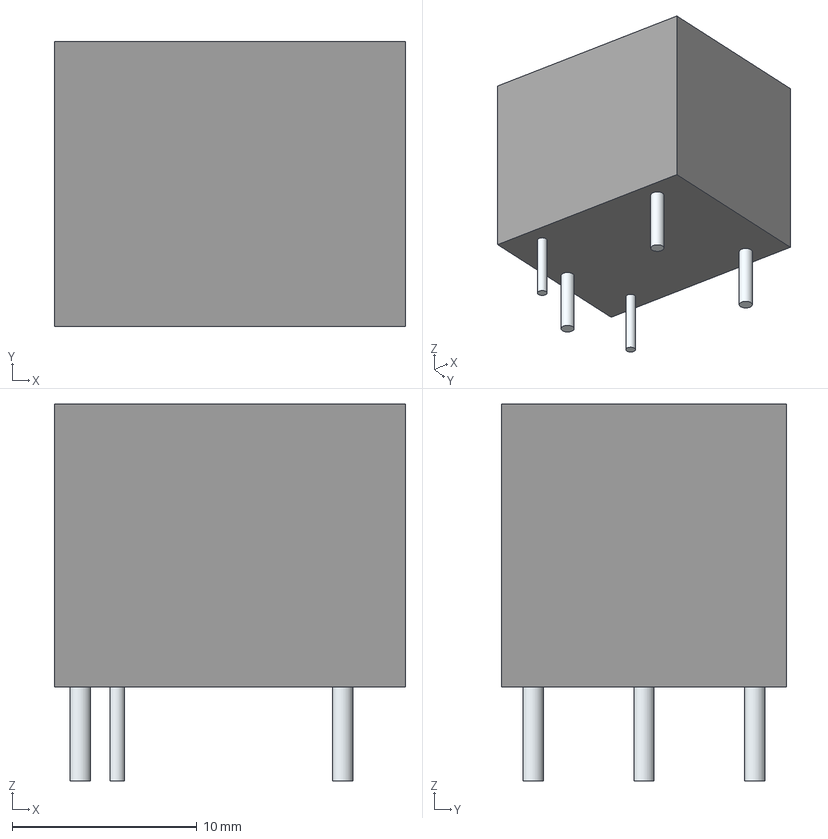
[picture p53: CAD file, 2026-01-23]
PartsLib/3D/AWHSH105D00G.stp
19.0 x 15.4 x 20.4 mm
Leads
