datacrystals/InverterGen5/PartsLib/3D/TXB0104DR.stp

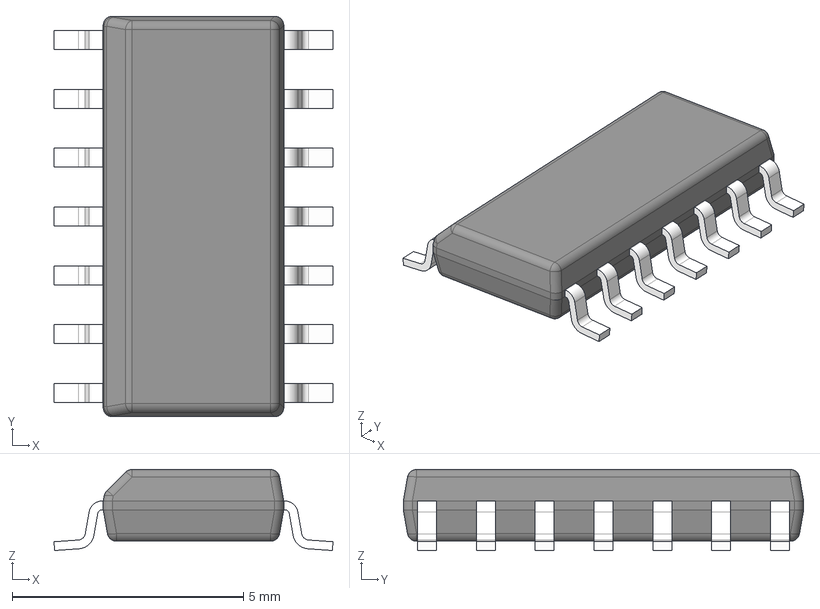
[picture p54: CAD file, 2026-01-23]
PartsLib/3D/TXB0104DR.stp
6.03 x 8.65 x 1.75 mm
BODY-SO
LEAD-SO x 14
PIN1-ID
