datacrystals/InverterGen5/PartsLib/3D/STWA75N60M6.stp

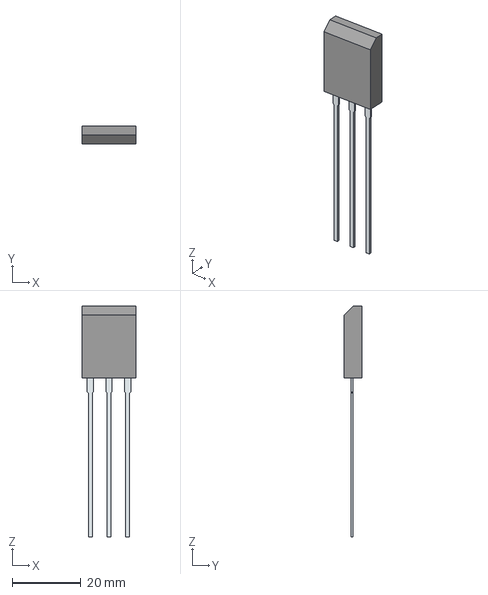
[picture p55: CAD file, 2026-01-23]
PartsLib/3D/STWA75N60M6.stp
15.8 x 5.10 x 67.3 mm
PinsArray
