datacrystals/InverterGen5/PartsLib/3D/MBRA340T3G.stp

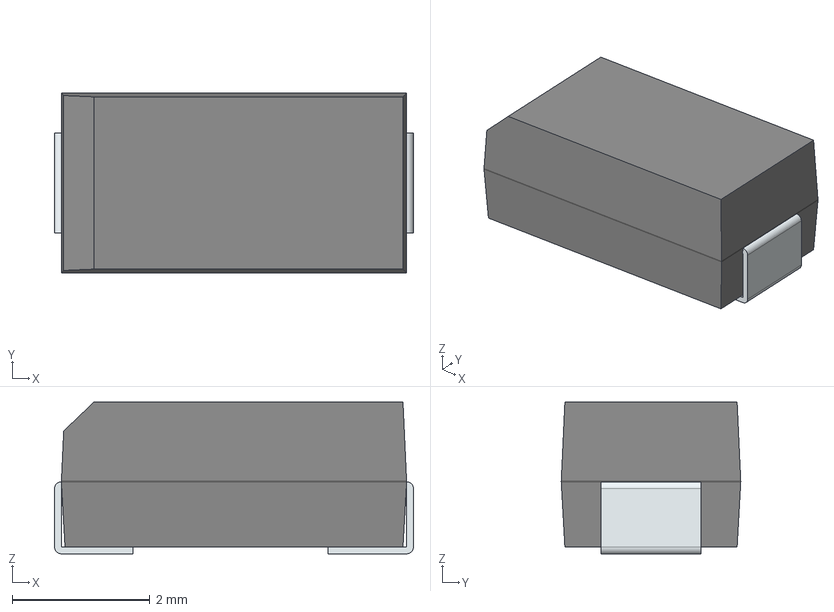
[picture p56: CAD file, 2026-01-23]
PartsLib/3D/MBRA340T3G.stp
5.21 x 2.60 x 2.20 mm
FilletPin1
FilletPin2
