datacrystals/InverterGen5/PartsLib/3D/RD7-12S033R.stp

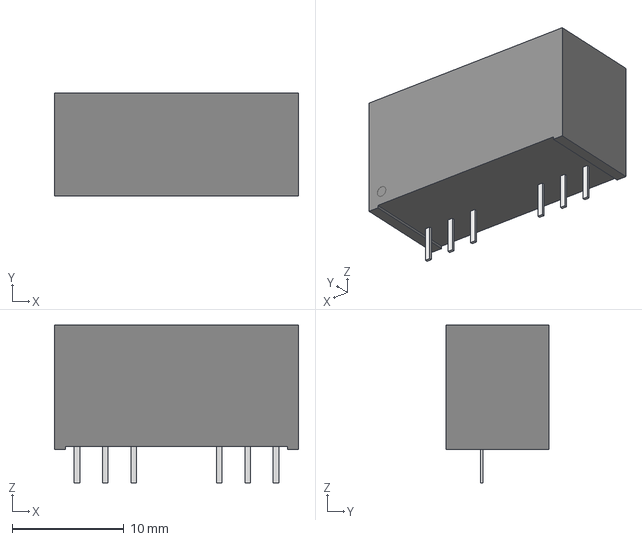
[picture p57: CAD file, 2026-01-23]
PartsLib/3D/RD7-12S033R.stp
21.8 x 9.20 x 14.1 mm
