datacrystals/InverterGen5/PartsLib/3D/ADUM4136BRWZ.stp

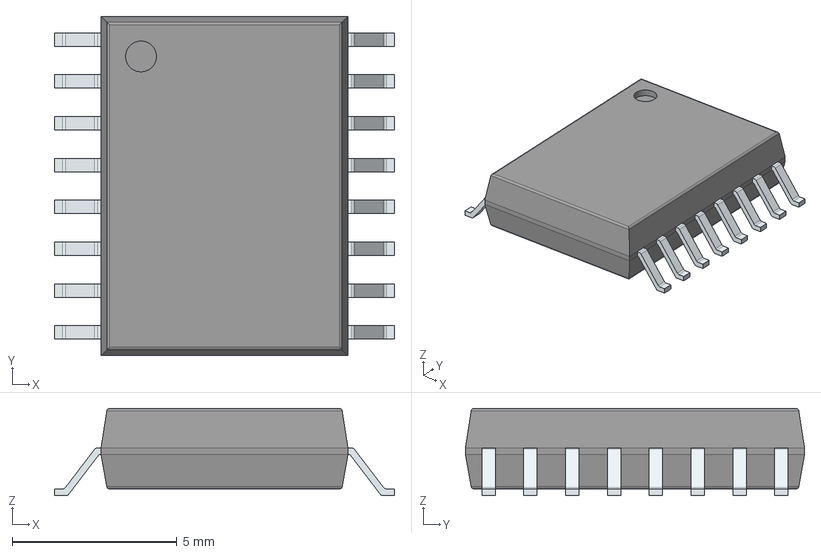
[picture p58: CAD file, 2026-01-23]
PartsLib/3D/ADUM4136BRWZ.stp
10.3 x 10.3 x 2.65 mm
PinsArrayLR
