datacrystals/InverterGen5/PartsLib/3D/TL431AIDBZR.stp

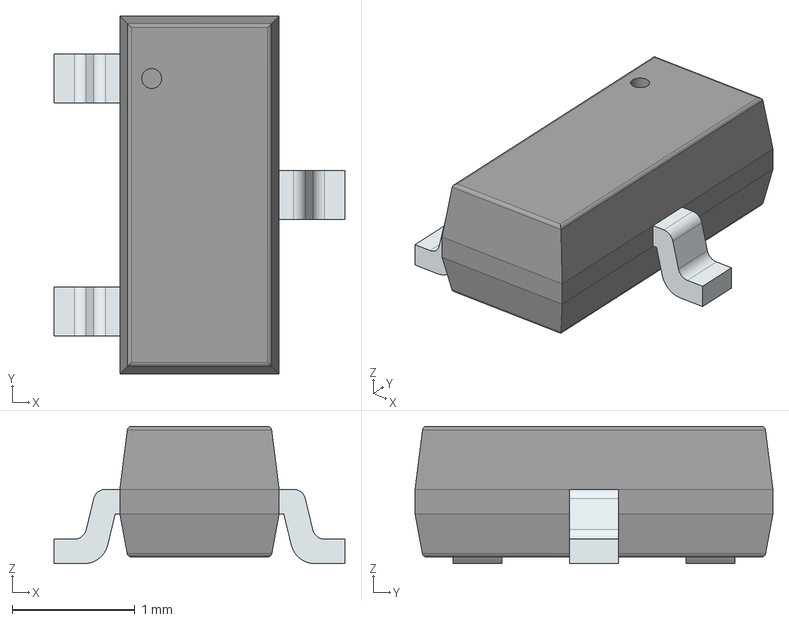
[picture p59: CAD file, 2026-01-23]
PartsLib/3D/TL431AIDBZR.stp
2.37 x 2.92 x 1.12 mm
PinsArrayL
FilletPinR
