datacrystals/InverterGen5/PartsLib/3D/SSM3K361R,LF.stp

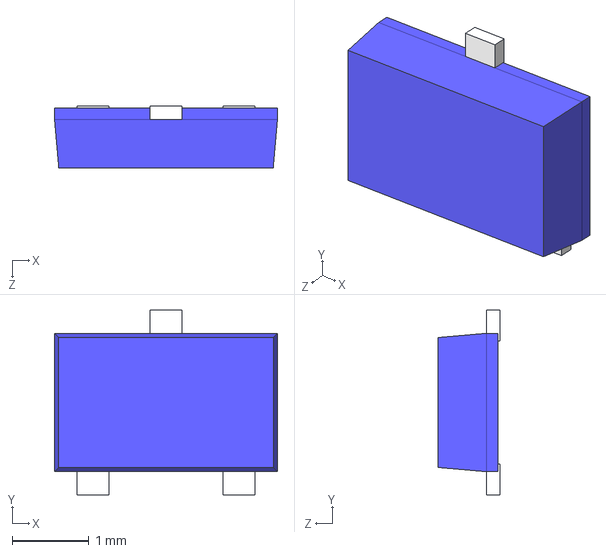
[picture p60: CAD file, 2026-01-23]
PartsLib/3D/SSM3K361R,LF.stp
2.90 x 2.40 x 0.8 mm
