datacrystals/InverterGen5/PartsLib/3D/TBP01R2W-508-02BE.stp

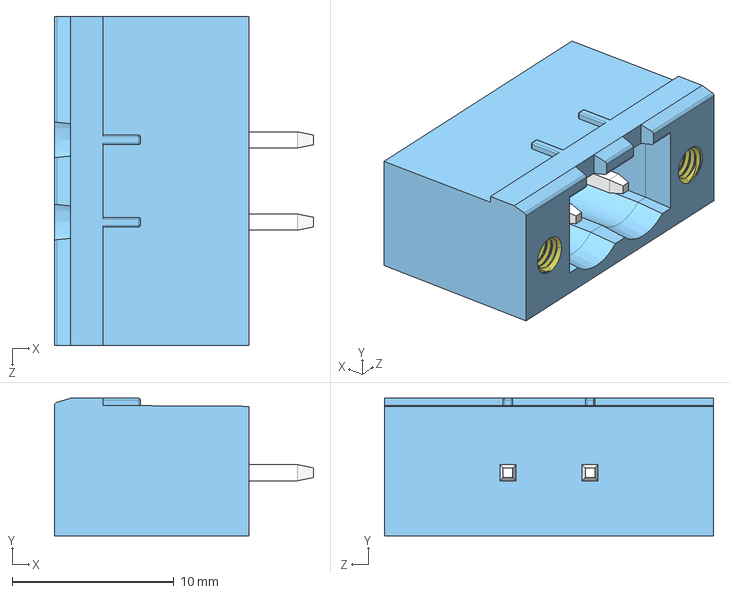
[picture p61: CAD file, 2026-01-23]
PartsLib/3D/TBP01R2W-508-02BE.stp
16.0 x 8.50 x 20.3 mm
