datacrystals/InverterGen5/PartsLib/3D/P6SMB18CA-Q.stp

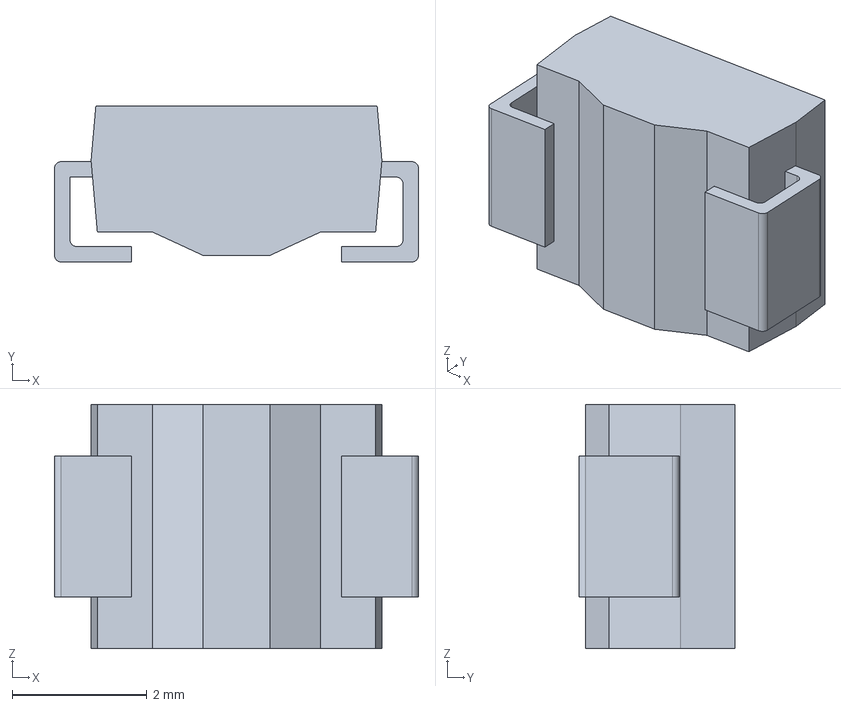
[picture p62: CAD file, 2026-01-23]
PartsLib/3D/P6SMB18CA-Q.stp
5.40 x 2.31 x 3.62 mm
