datacrystals/InverterGen5/PartsLib/3D/UCM1H101MCL1GS.stp

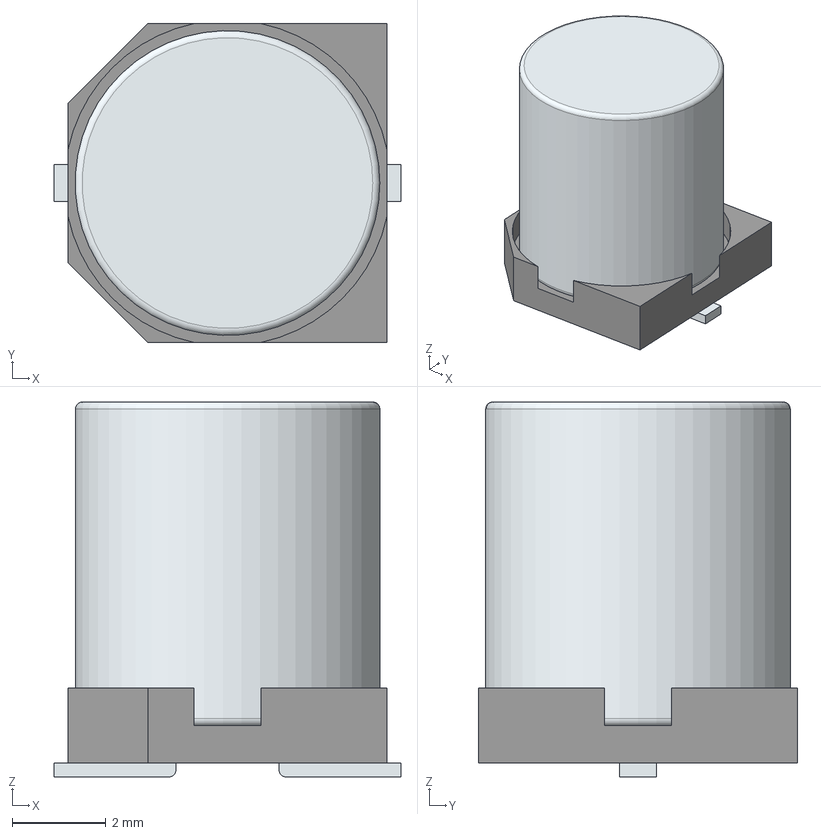
[picture p63: CAD file, 2026-01-23]
PartsLib/3D/UCM1H101MCL1GS.stp
7.40 x 6.80 x 8.00 mm
Base
Pin1Fillet
Pin2Fillet
