datacrystals/InverterGen5/PartsLib/3D/UVY1E102MPD1TD.stp

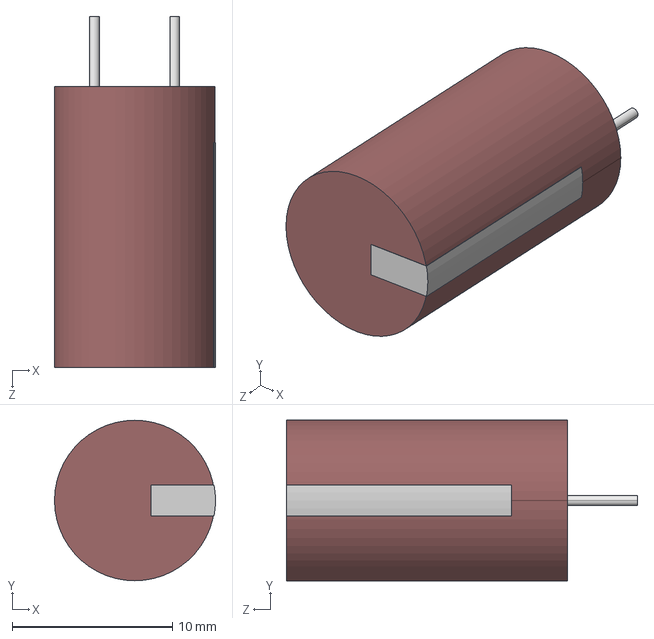
[picture p64: CAD file, 2026-01-23]
PartsLib/3D/UVY1E102MPD1TD.stp
10.0 x 10.0 x 21.9 mm
