datacrystals/InverterGen5/PartsLib/3D/RKE-1205S_H.stp

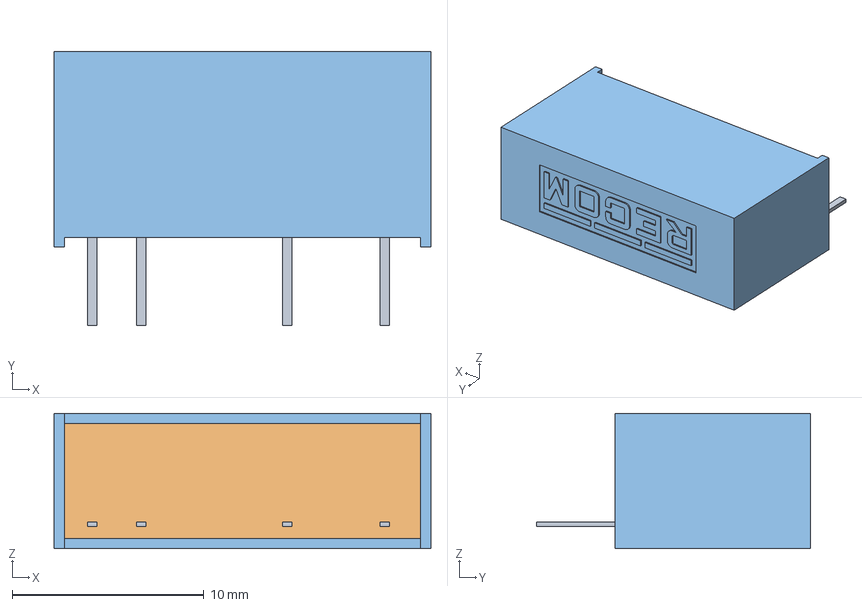
[picture p65: CAD file, 2026-01-23]
PartsLib/3D/RKE-1205S_H.stp
19.6 x 14.3 x 7.05 mm
