datacrystals/InverterGen5/PartsLib/3D/5-106505-2.stp

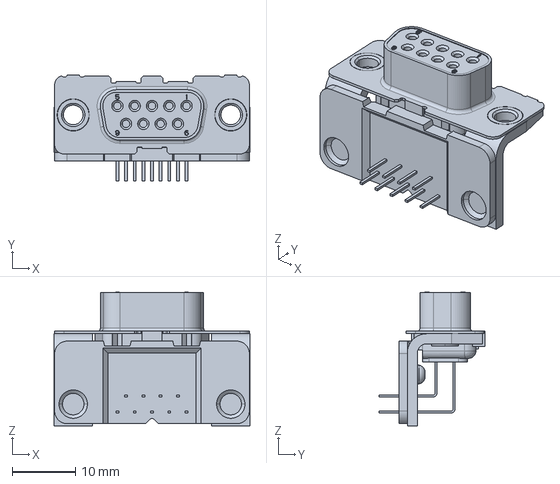
[picture p66: CAD file, 2026-01-23]
PartsLib/3D/5-106505-2.stp
31.1 x 16.9 x 21.2 mm
