datacrystals/InverterGen5/PartsLib/3D/TBP01R1-508-04BE.stp

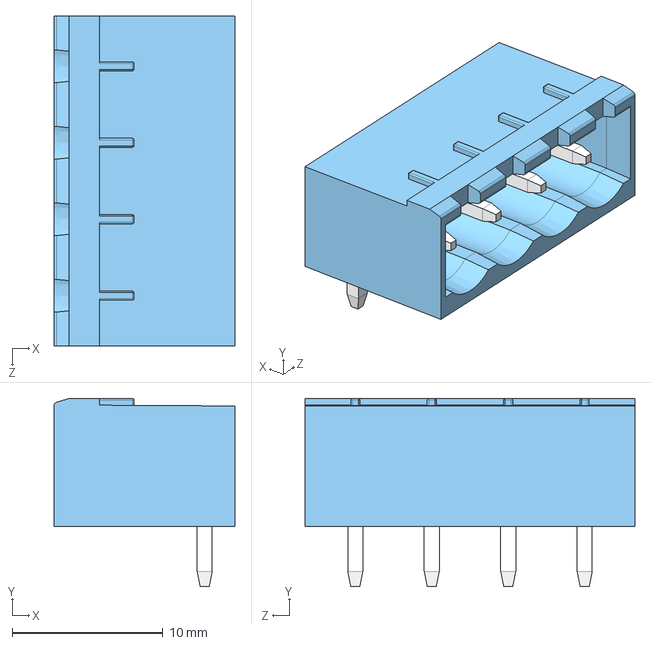
[picture p67: CAD file, 2026-01-23]
PartsLib/3D/TBP01R1-508-04BE.stp
12.0 x 12.5 x 21.9 mm
