datacrystals/InverterGen5/PartsLib/3D/RC2512JK-071ML.stp

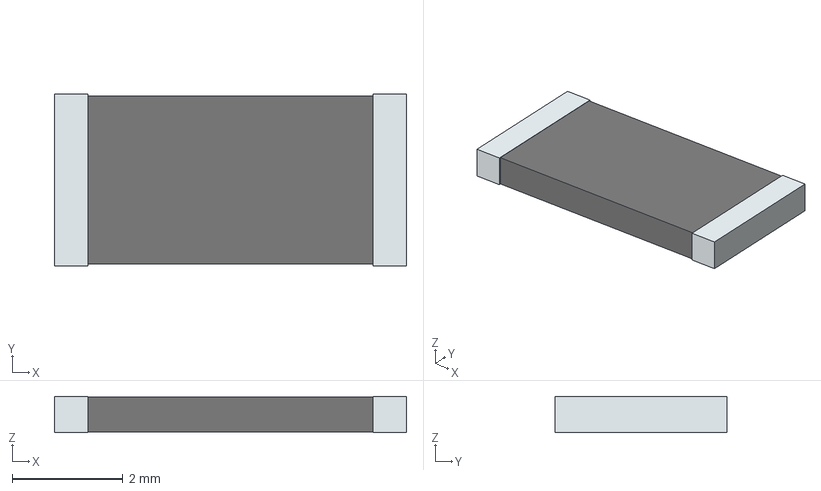
[picture p68: CAD file, 2026-01-23]
PartsLib/3D/RC2512JK-071ML.stp
6.35 x 3.10 x 0.65 mm
term1
term2
