datacrystals/InverterGen5/PartsLib/3D/TBP02R2W-381-06BE.stp

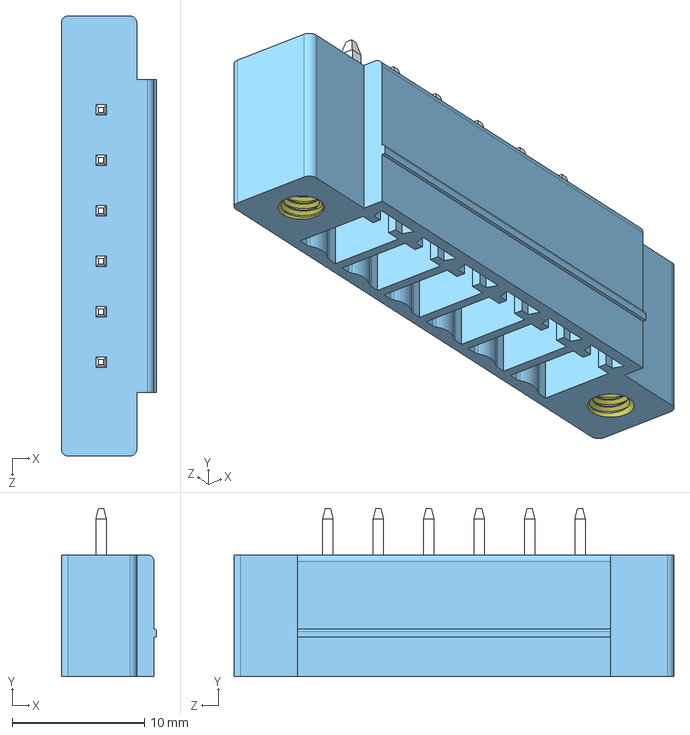
[picture p69: CAD file, 2026-01-23]
PartsLib/3D/TBP02R2W-381-06BE.stp
7.20 x 12.7 x 33.2 mm
