datacrystals/InverterGen5/PartsLib/3D/CM600HA-24H.stp

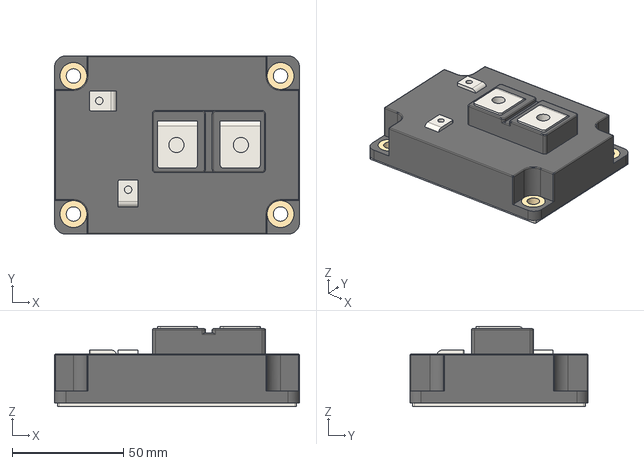
[picture p70: CAD file, 2026-01-23]
PartsLib/3D/CM600HA-24H.stp
110.0 x 80.0 x 36.1 mm
