datacrystals/InverterGen5/PartsLib/3D/SZMMSZ4678T1G.stp

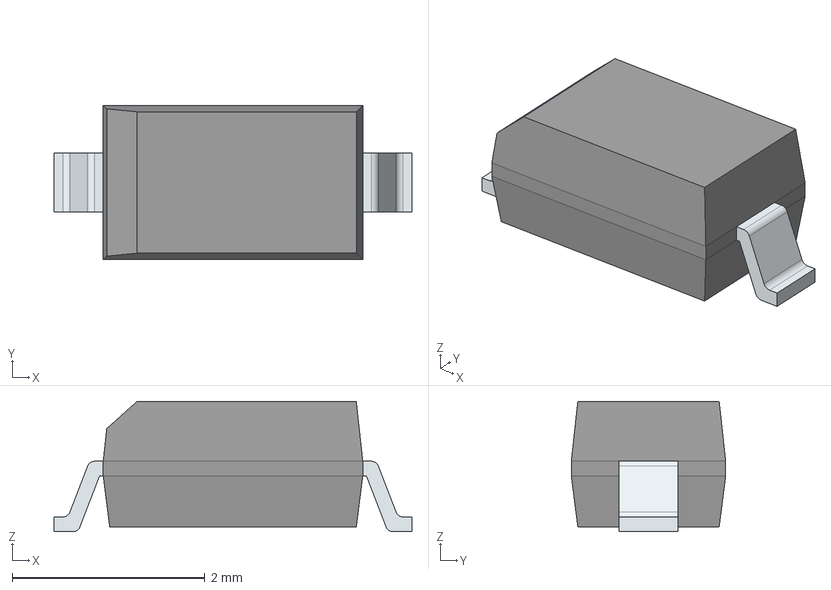
[picture p71: CAD file, 2026-01-23]
PartsLib/3D/SZMMSZ4678T1G.stp
3.71 x 1.60 x 1.35 mm
FilletPinL
FilletPinR
