datacrystals/InverterGen5/PartsLib/3D/1SMB2EZ15_R1_00001.stp

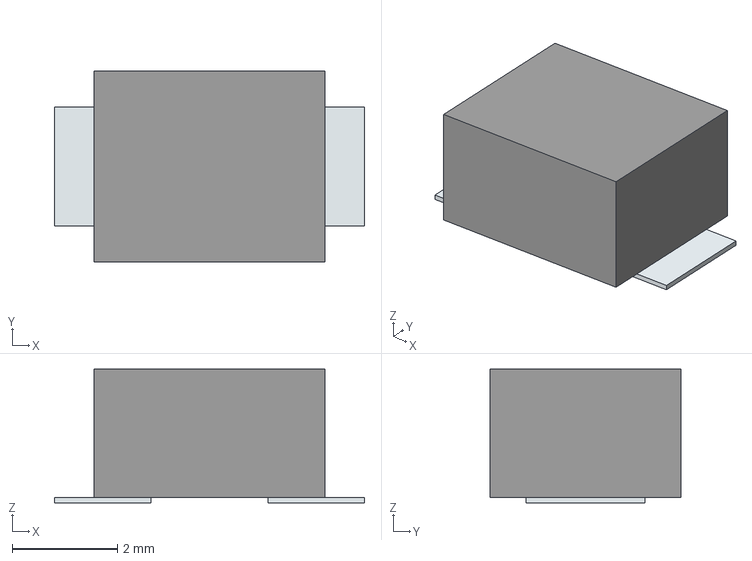
[picture p73: CAD file, 2026-01-23]
PartsLib/3D/1SMB2EZ15_R1_00001.stp
5.88 x 3.62 x 2.54 mm
Pins
