datacrystals/InverterGen5/PartsLib/3D/LM358DR.stp

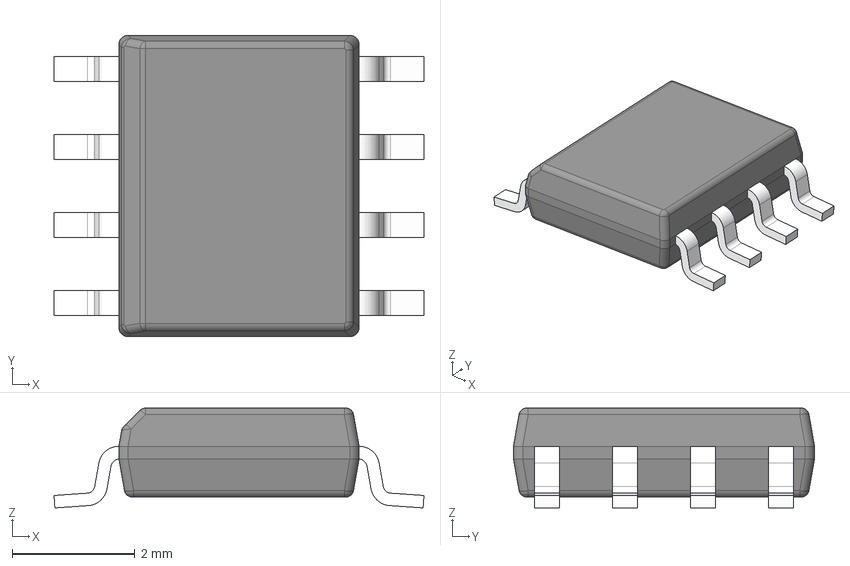
[picture p74: CAD file, 2026-01-23]
PartsLib/3D/LM358DR.stp
6.02 x 4.90 x 1.63 mm
BODY-SO
LEAD-D0008A x 8
