datacrystals/InverterGen5/PartsLib/3D/LM5185QPWPRQ1.stp

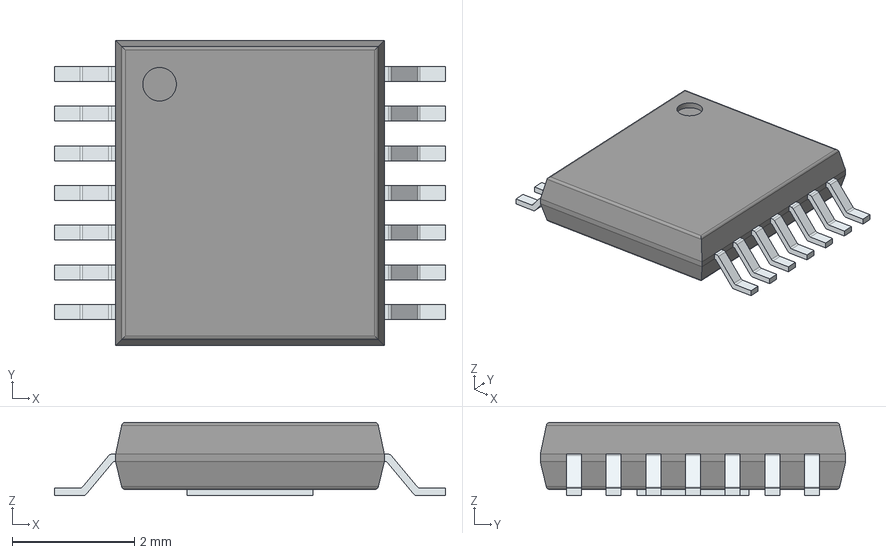
[picture p75: CAD file, 2026-01-23]
PartsLib/3D/LM5185QPWPRQ1.stp
6.40 x 5.00 x 1.20 mm
PinsArrayLR
ThermalPad
