datacrystals/InverterGen5/PartsLib/3D/BSS138AKM-QYL.stp

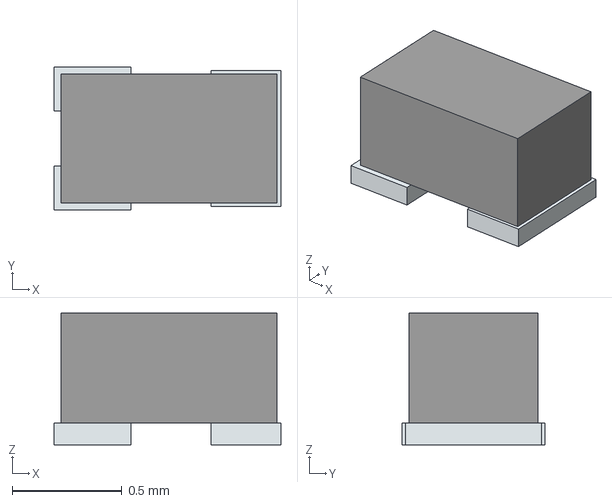
[picture p76: CAD file, 2026-01-23]
PartsLib/3D/BSS138AKM-QYL.stp
1.04 x 0.65 x 0.6 mm
Pins
