datacrystals/InverterGen5/PartsLib/3D/TBP02R2W-381-08BE.stp

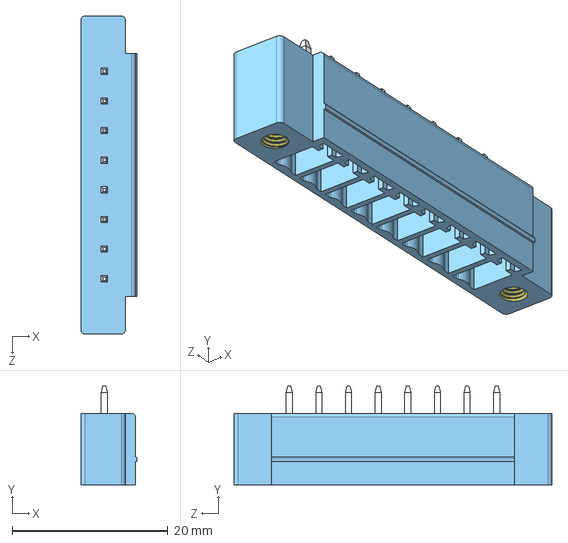
[picture p77: CAD file, 2026-01-23]
PartsLib/3D/TBP02R2W-381-08BE.stp
7.20 x 12.7 x 40.9 mm
