datacrystals/InverterGen5/PartsLib/3D/SIHFR120-GE3.stp

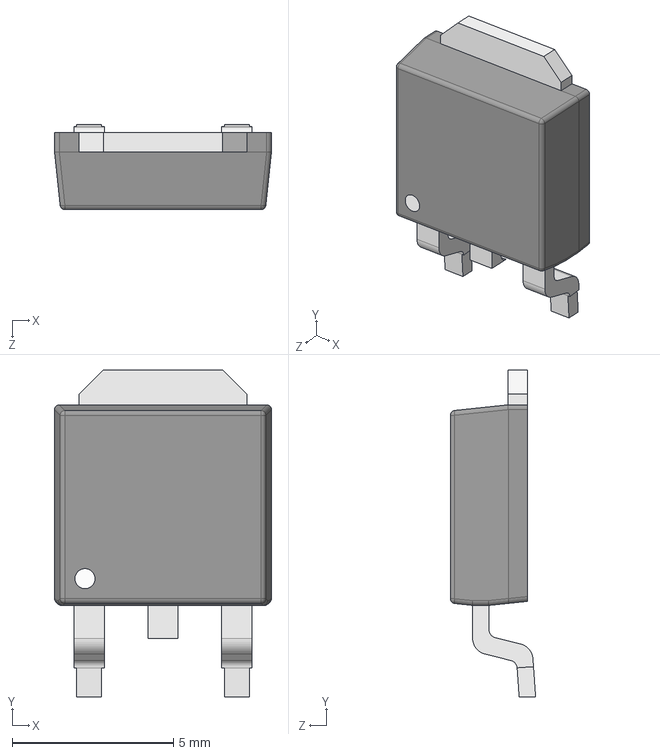
[picture p78: CAD file, 2026-01-23]
PartsLib/3D/SIHFR120-GE3.stp
6.73 x 10.1 x 2.64 mm
