datacrystals/InverterGen5/PartsLib/3D/NSD15-12S12.stp

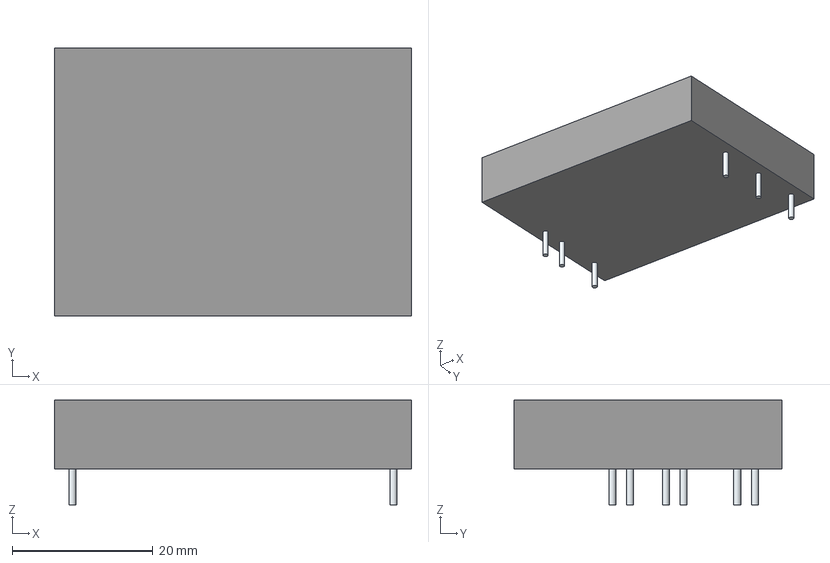
[picture p79: CAD file, 2026-01-23]
PartsLib/3D/NSD15-12S12.stp
50.8 x 38.1 x 14.9 mm
Leads
