datacrystals/InverterGen5/PartsLib/3D/D25S33E4PA00LF.stp

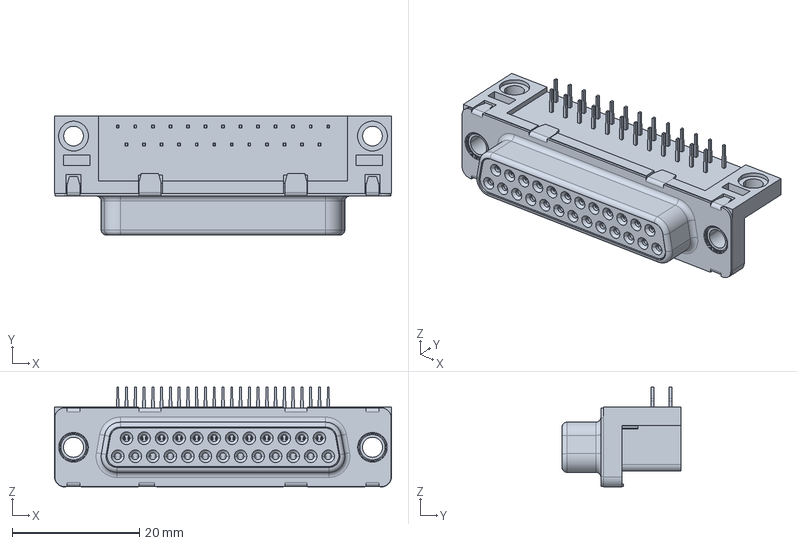
[picture p80: CAD file, 2026-01-23]
PartsLib/3D/D25S33E4PA00LF.stp
53.0 x 18.7 x 15.7 mm
