datacrystals/InverterGen5/PartsLib/3D/TJA1050T_CM,118.stp

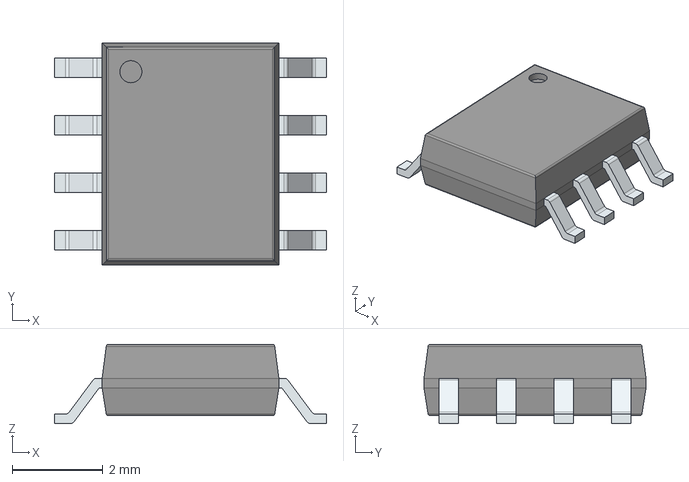
[picture p81: CAD file, 2026-01-23]
PartsLib/3D/TJA1050T_CM,118.stp
6.00 x 4.90 x 1.75 mm
PinsArrayLR
