datacrystals/InverterGen5/(list of files, cad)

Other CAD files:
PartsLib/3D/MJE2955TG.stp
PartsLib/3D/RFMM-0505S.stp
PartsLib/3D/AMC3330QDWERQ1.stp
PartsLib/3D/1N5956BRLG.stp
Mechanical/91290A165_Black-Oxide Alloy Steel Socket Head Screw.STEP
Mechanical/91292A112_18-8 Stainless Steel Socket Head Screw.STEP
Mechanical/91292A134_18-8 Stainless Steel Socket Head Screw.STEP
Mechanical/971120321/3D/971120321.stp
Mechanical/971200321/3D/971200321.stp
Mechanical/971200474/3D/971200474.stp
Mechanical/971200481/3D/971200481.stp
Mechanical/971200611/3D/971200611.stp
Mechanical/971260321/3D/971260321.stp
Mechanical/971350321/3D/971350321.stp
Mechanical/971400471/3D/971400471.stp
Mechanical/B57703M0103A019/3D/B57703M0103A019.stp
PartsLib/3D/1548129.stp
PartsLib/3D/1987724.stp
PartsLib/3D/38969-0002.stp
PartsLib/3D/5442251.stp
PartsLib/3D/776231-1.stp
PartsLib/3D/776275-1.stp
PartsLib/3D/B32652A0104K000.stp
PartsLib/3D/B32774X0205K000.stp
PartsLib/3D/B32774X1155K000.stp
PartsLib/3D/ISO1042BDWVR.stp
PartsLib/3D/ISO6740FQDWRQ1.stp
PartsLib/3D/MAX22530AWE+.stp
PartsLib/3D/NCD57084DR2G.stp
PartsLib/3D/UCC27424QDRQ1.stp
PartsLib/3D/UCC28220D.stp
PartsLib/3D/UCC28221D.stp
