datacrystals/InverterGen5/TODO.txt

- add defalt off resistors to all spi chip selects
- convert m4 gate drive board support holes to m3
- widen gate drive traces to lower ESL
