datacrystals/InverterGen5/Boards/MainBoard/MainBoard.kicad_pcb

## KiCad design Boards/MainBoard/MainBoard.kicad_pcb (2026-02-06)

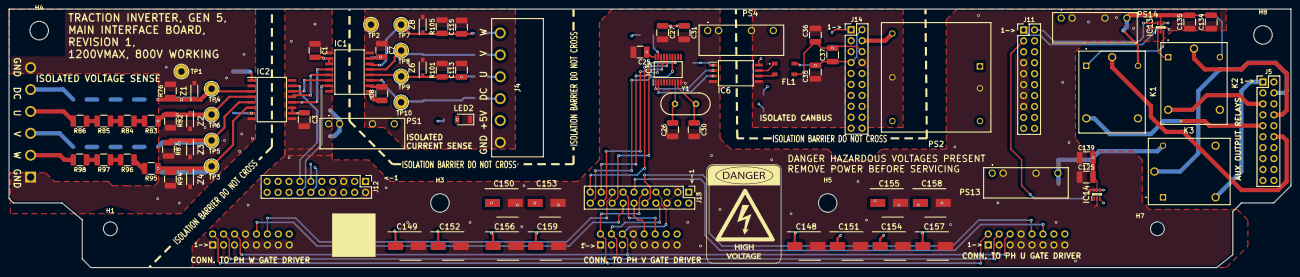
[picture p82: board MainBoard.kicad_pcb from above]

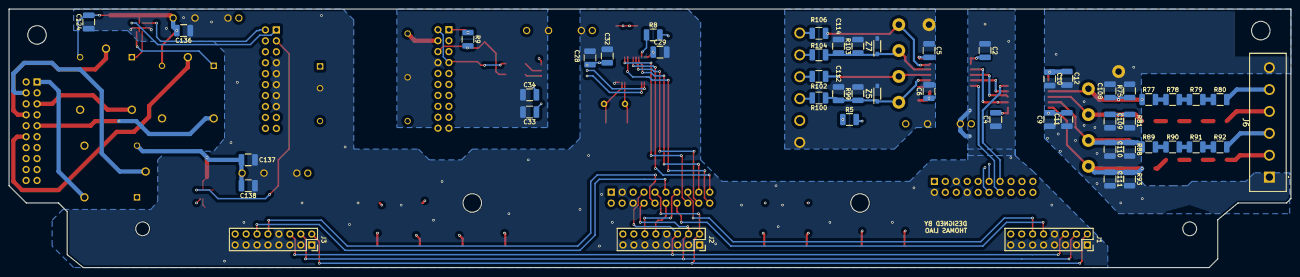
[picture p83: board MainBoard.kicad_pcb from below]

Board: 6 copper layers, 297.5 x 60.0 mm, 139 parts (50 on the bottom side), 85 nets.

Parts:
C1, C3, C5, C6, C9, C10, C25, C31, C32, C34: 100nF; C_1210_3225Metric_Pad1.33x2.70mm_HandSolder
C2, C4, C7, C8, C11, C12: 1uF; C_1210_3225Metric_Pad1.33x2.70mm_HandSolder
C26, C30, C35, C36, C37: 22pF; C_1210_3225Metric_Pad1.33x2.70mm_HandSolder
C27, C28, C29, C33, C124, C125, C134, C135, C136, C137, C138, C139: 10uF; C_1210_3225Metric_Pad1.33x2.70mm_HandSolder
C108, C109, C110, C111, C112, C113, C114, C115: 10nF; C_1210_3225Metric_Pad1.33x2.70mm_HandSolder
C148, C149, C150, C151, C152, C153, C154, C155, C156, C157, C158, C159: UCM1H101MCL1GS; CAPAE660X800N
FL1: ACT45B-101-2P-TL003; ACT45B1012PTL003
H1, H7: MountingHole; MountingHole_3.2mm_M3
H3, H4, H5, H8: MountingHole; MountingHole_4.3mm_M4
IC1, IC2: MAX22530AWE+; SOIC127P1032X265-16N
IC5: MCP2515-e_ST; SOP65P640X120-20N
IC6: ISO1042BDWVR; SOIC127P1150X280-8N
IC13, IC14: DRDNB21D-7; SOT65P210X110-6N
J1, J2, J3: Conn_02x08_Counter_Clockwise; PinSocket_2x08_P2.54mm_Vertical
J4: TBP01R1-508-06BE; TBP01R150806BE
J5, J11, J12, J13, J14: Conn_02x10_Counter_Clockwise; PinHeader_2x10_P2.54mm_Vertical
J6: TBP01R2-508-06BE; TBP01R250806BE
K1, K2, K3: AWHSH105D00G
LED2: LTST-C230CKT; LEDC3216X120N
PS1, PS4, PS13, PS14: RKE-1205S_H; RKE1205SH
PS2: REC10K-2424DAW_H2; REC10K-AW
R5, R76, R82, R88, R94, R99, R101, R103, R105: 1k; R_1210_3225Metric_Pad1.30x2.65mm_HandSolder
R8: 4.7k; R_1210_3225Metric_Pad1.30x2.65mm_HandSolder
R9: 120; R_1210_3225Metric_Pad1.30x2.65mm_HandSolder
R75, R81, R87, R93: 2k; R_1210_3225Metric_Pad1.30x2.65mm_HandSolder
R77, R78, R79, R80, R83, R84, R85, R86, R89, R90, R91, R92, R95, R96, R97, R98: 250k; R_1210_3225Metric_Pad1.30x2.65mm_HandSolder
R100, R102, R104, R106: 5k; R_1210_3225Metric_Pad1.30x2.65mm_HandSolder
TP1, TP2, TP3, TP4, TP5, TP6, TP7, TP8, TP9, TP10: TestPoint; TestPoint_Loop_D2.54mm_Drill1.5mm_Beaded
Y1: 8MHz; Crystal_HC49-4H_Vertical
Z1, Z2, Z3, Z4, Z5, Z6, Z7, Z8: SZMMSZ4678T1G; SOD3716X135N

Connections:
/+3.3V_A: C1.2, C2.2, C3.2, C4.2, C25.1, C28.2, C29.1, C32.1, C148.1 (+), C149.1 (+), C150.1 (+), C151.1 (+), IC1.10 (VDDPL), IC1.11 (VDDL), IC2.10 (VDDPL), IC2.11 (VDDL), IC5.20 (VDD), IC6.1 (VCC1), J1.14, J2.14, J3.14, J12.1, J12.4, J12.7, J13.1, J13.4, R8.2
/+5V_Y: J4.5, PS1.7 (+VOUT), R5.2
/+12V_A: C27.1, C31.1, C152.1 (+), C153.1 (+), C154.1 (+), C155.1 (+), C156.1 (+), C157.1 (+), C158.1 (+), C159.1 (+), J1.16, J2.16, J3.16, J11.6, J11.8, J11.10, J11.12, J11.14, J12.3, J12.6, J12.9, J13.2, J13.5, PS1.1 (+VIN), PS2.1 (+VIN), PS4.1 (+VIN), PS13.1 (+VIN), PS14.1 (+VIN)
/ADC_1/ADC2_5VFILTER_1/OUT: C112.1, IC1.3 (AIN1), R99.1, R100.1, TP10.1, Z5.1 (K)
/ADC_1/ADC2_5VFILTER_2/OUT: C113.1, IC1.4 (AIN2), R101.1, R102.1, TP9.1, Z6.1 (K)
/ADC_1/ADC2_5VFILTER_3/OUT: C114.1, IC1.5 (AIN3), R103.1, R104.1, TP8.1, Z7.1 (K)
/ADC_1/ADC2_5VFILTER_4/OUT: C115.1, IC1.6 (AIN4), R105.1, R106.1, TP7.1, Z8.1 (K)
/ADC_1/VoltageSenseInputStage1/LV_OUT: C109.1, IC2.4 (AIN2), R81.1, R82.1, R83.1, TP6.1, Z2.1 (K)
/ADC_1/VoltageSenseInputStage2/LV_OUT: C110.1, IC2.5 (AIN3), R87.1, R88.1, R89.1, TP5.1, Z3.1 (K)
/ADC_1/VoltageSenseInputStage3/LV_OUT: C111.1, IC2.6 (AIN4), R93.1, R94.1, R95.1, TP3.1, Z4.1 (K)
/ADC_1/VoltageSenseInputStage/LV_OUT: C108.1, IC2.3 (AIN1), R75.1, R76.1, R77.1, TP4.1, Z1.1 (K)
/CAN_5V_OUT: C33.1, C34.2, IC6.8 (VCC2), PS4.7 (+VOUT)
/CAN_24V_OUT: J14.4, PS2.6 (+VOUT)
/CAN_GND: C33.2, C34.1, C35.1, C36.2, IC6.5 (GND2), J14.8, PS2.5 (COM), PS4.5 (-VOUT)
/CAN_HIGH: C35.2, C37.1, FL1.4, J14.2, J14.7
/CAN_JUMPER_B: J14.1, R9.1
/CAN_LOW: C36.1, C37.2, FL1.3, J14.6, R9.2
/DC_LINK_VSENSE_U: J6.5, R80.2
/FAULT: J1.2, J2.2, J3.2, J13.9
/GND_A: C1.1, C2.1, C3.1, C4.1, C25.2, C26.2, C27.2, C28.1, C29.2, C30.2, C31.2, C32.2, C124.1, C125.1, C134.1, C135.1, C136.1, C137.1, C138.1, C139.1, C148.2 (-), C149.2 (-), C150.2 (-), C151.2 (-), C152.2 (-), C153.2 (-), C154.2 (-), C155.2 (-), C156.2 (-), C157.2 (-), C158.2 (-), C159.2 (-), IC1.9 (GNDL), IC2.9 (GNDL), IC5.10 (VSS), IC6.4 (GND1), IC13.2 (E1/E2), IC14.2 (E1/E2), IC14.6 (B1), J1.1, J1.3, J1.5, J1.7, J1.8, J1.9, J1.11, J1.13, J1.15, J2.1, J2.3, J2.5, J2.7, J2.8, J2.9, J2.11, J2.13, J2.15, J3.1, J3.3, J3.5, J3.7, J3.8, J3.9, J3.11, J3.13, J3.15, J11.7, J11.9, J11.11, J11.13, J11.15, J12.2, J12.5, J12.8, J13.3, J13.6, PS1.2 (-VIN), PS2.2 (-VIN), PS4.2 (-VIN), PS13.2 (-VIN), PS13.5 (-VOUT), PS14.2 (-VIN), PS14.5 (-VOUT)
/GND_U: C9.1, C10.2, C11.1, C12.2, C108.2, C109.2, C110.2, C111.2, IC2.2 (AGND), IC2.8 (GNDF), J6.1, J6.6, R75.2, R76.2, R81.2, R82.2, R87.2, R88.2, R93.2, R94.2, TP1.1, Z1.2 (A), Z2.2 (A), Z3.2 (A), Z4.2 (A)
/ISENSE_DC_LINK_Y: J4.4, R100.2
/ISENSE_GND_Y: C5.1, C6.2, C7.1, C8.2, C112.2, C113.2, C114.2, C115.2, IC1.2 (AGND), IC1.8 (GNDF), J4.6, LED2.1 (K), PS1.5 (-VOUT), R99.2, R101.2, R103.2, R105.2, TP2.1, Z5.2 (A), Z6.2 (A), Z7.2 (A), Z8.2 (A)
/ISENSE_PH_U_Y: J4.3, R102.2
/ISENSE_PH_V_Y: J4.2, R104.2
/ISENSE_PH_W_Y: J4.1, R106.2
/OutputRelays/+5V_A_INT: C125.2, C137.2, C138.2, C139.2, IC14.5 (K1/K2), K3.4 (COIL_2), PS13.7 (+VOUT)
/OutputRelays/+5V_A_INT_2: C124.2, C134.2, C135.2, C136.2, IC13.5 (K1/K2), K1.4 (COIL_2), K2.4 (COIL_2), PS14.7 (+VOUT)
/PH_U_H: J1.12, J13.15
/PH_U_L: J1.10, J13.14
/PH_U_VSENSE_U: J6.4, R86.2
/PH_V_H: J2.12, J13.13
/PH_V_L: J2.10, J13.12
/PH_V_VSENSE_U: J6.3, R92.2
/PH_W_H: J3.12, J13.11
/PH_W_L: J3.10, J13.10
/PH_W_VSENSE_U: J6.2, R98.2
/READY: J1.4, J2.4, J3.4, J13.8
/RELAY1_COM: J5.12, K1.5 (COM)
/RELAY1_NO: J5.9, K1.2 (NO)
/RELAY2_COM: J5.8, K2.5 (COM)
/RELAY2_NO: J5.5, K2.2 (NO)
/RELAY3_COM: J5.4, K3.5 (COM)
/RELAY3_NO: J5.1, K3.2 (NO)
/RELAY_1_A: IC13.4 (B2), J11.1
/RELAY_2_A: IC13.6 (B1), J11.2
/RELAY_3_A: IC14.4 (B2), J11.3
/RESET: J1.6, J2.6, J3.6, J13.7
/SPI1_CAN_CS_A: IC5.18 (~CS), J13.17
/SPI1_CAN_INT_A: IC5.13 (~INT), J13.16
/SPI1_RX_A: IC5.17 (SO), J13.18
/SPI1_SCK_A: IC5.14 (SCK), J13.20
/SPI1_TX_A: IC5.16 (SI), J13.19
/SPI2_ADC1_CS_A: IC2.15 (~CS), J12.13
/SPI2_ADC2_CS_A: IC1.15 (~CS), J12.14
/SPI2_RX_A: IC1.12 (SDO), IC2.12 (SDO), J12.10
/SPI2_SCK_A: IC1.14 (SCLK), IC2.14 (SCLK), J12.12
/SPI2_TX_A: IC1.13 (SDI), IC2.13 (SDI), J12.11
unnamed: C6.1, C8.1, IC1.1 (REF)
unnamed: C5.2, C7.2, IC1.7 (VDDF)
unnamed: C10.1, C12.1, IC2.1 (REF)
unnamed: C9.2, C11.2, IC2.7 (VDDF)
unnamed: C30.1, IC5.9 (OSC1), Y1.2
unnamed: C26.1, IC5.8 (OSC2), Y1.1
unnamed: IC5.2 (RXCAN), IC6.3 (RXD)
unnamed: IC5.1 (TXCAN), IC6.2 (TXD)
unnamed: IC5.19 (~RESET), R8.1
unnamed: FL1.1, IC6.7 (CANH)
unnamed: FL1.2, IC6.6 (CANL)
unnamed: IC13.1 (C1/A1), K2.1 (COIL_1)
unnamed: IC13.3 (C2/A2), K1.1 (COIL_1)
unnamed: IC14.3 (C2/A2), K3.1 (COIL_1)
unnamed: LED2.2 (A), R5.1
unnamed: R77.2, R78.1
unnamed: R78.2, R79.1
unnamed: R79.2, R80.1
unnamed: R83.2, R84.1
unnamed: R84.2, R85.1
unnamed: R85.2, R86.1
unnamed: R89.2, R90.1
unnamed: R90.2, R91.1
unnamed: R91.2, R92.1
unnamed: R95.2, R96.1
unnamed: R96.2, R97.1
unnamed: R97.2, R98.1
