datacrystals/InverterGen5/Boards/ControlBoard/ControlBoard.kicad_pcb

## KiCad design Boards/ControlBoard/ControlBoard.kicad_pcb (2026-02-06)

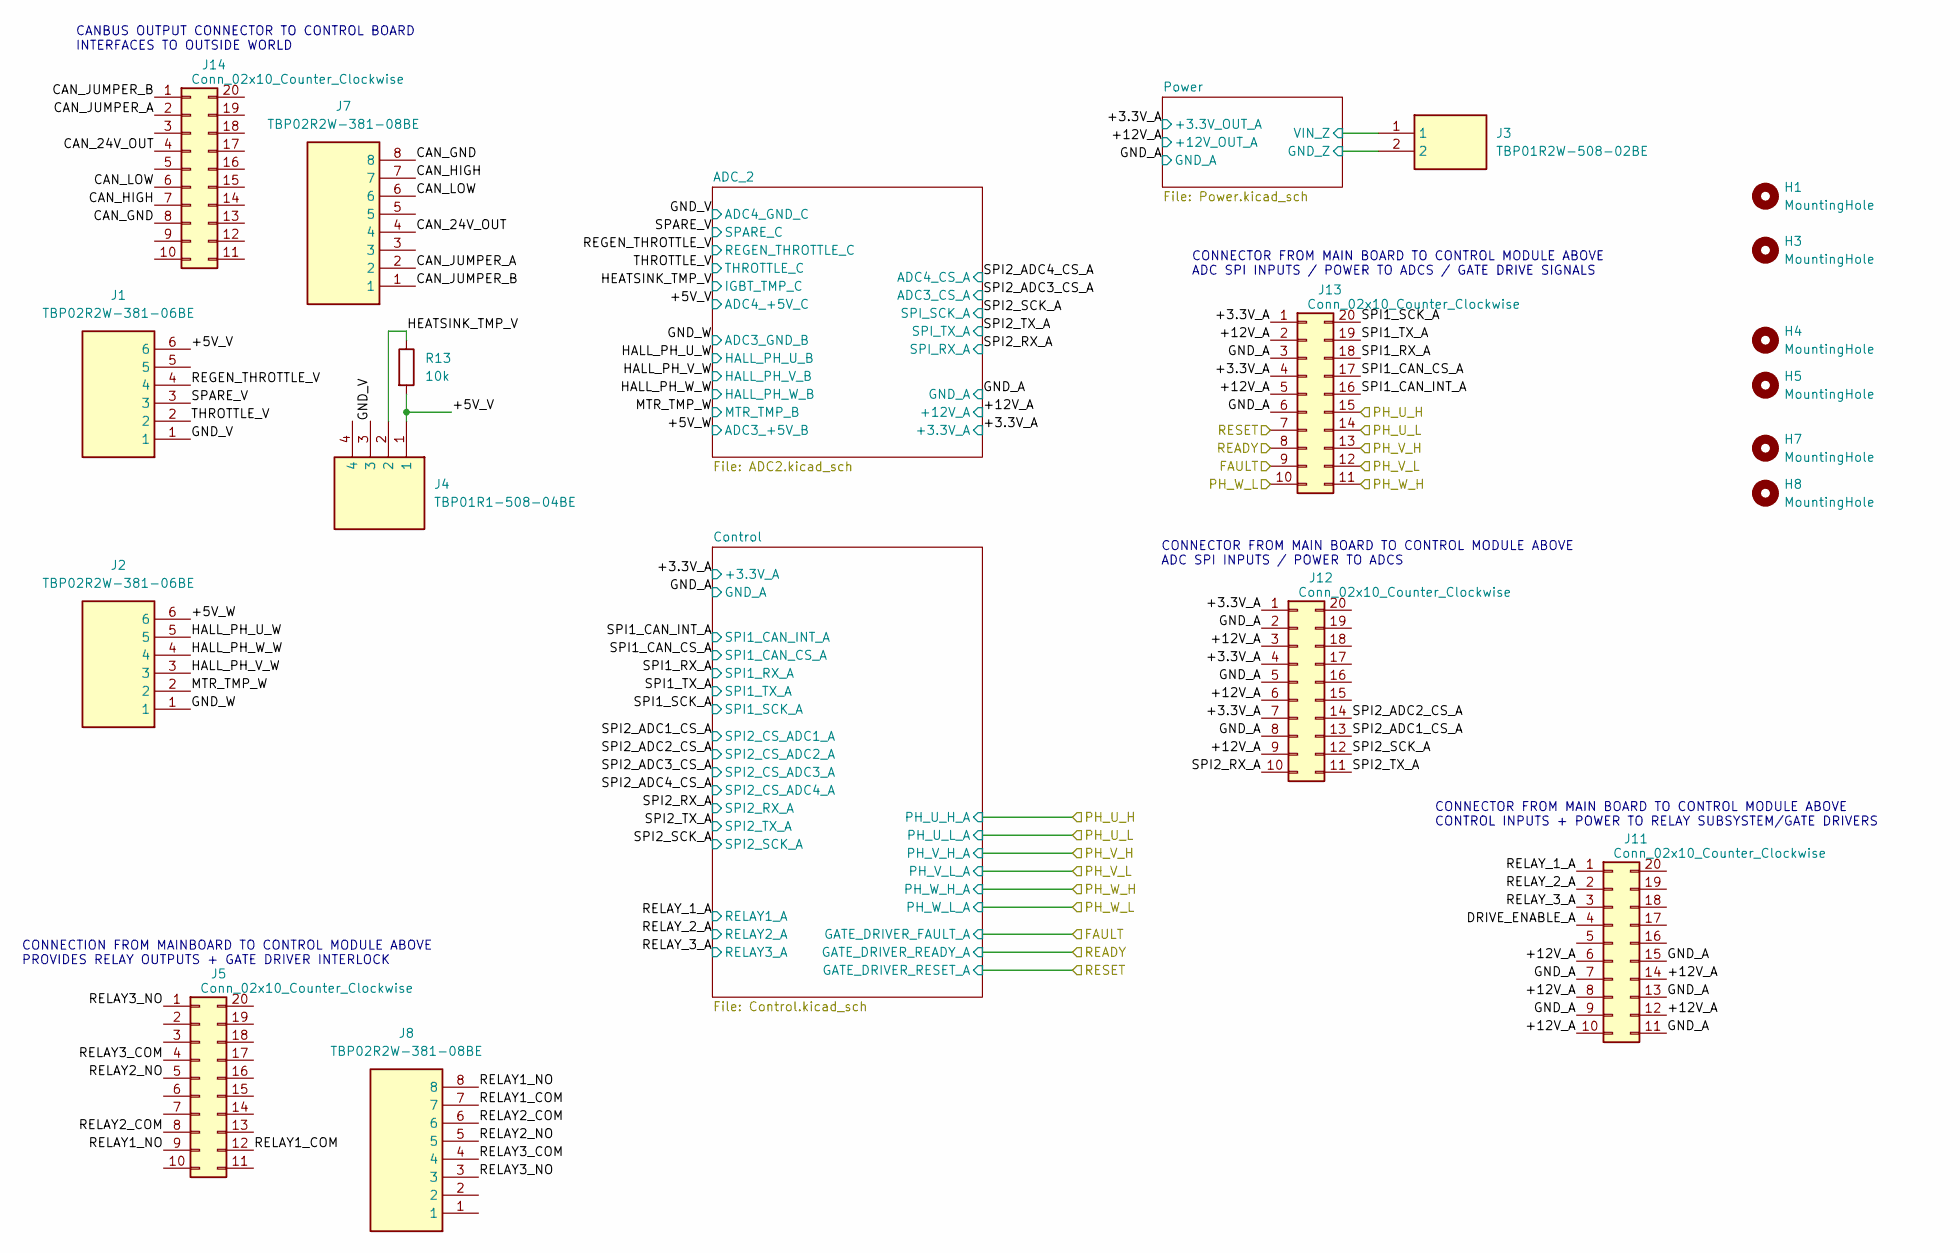
[picture p84: schematic ControlBoard.kicad_sch]

Parts:
H1, H7: MountingHole; MountingHole_3.2mm_M3
H3, H4, H5, H8: MountingHole; MountingHole_4.3mm_M4
J1, J2: TBP02R2W-381-06BE; TBP02R2W38106BE; Mouser Part Number 490-TBP02R2W-38106BE
J3: TBP01R2W-508-02BE; TBP01R2W50802BE; Mouser Part Number 490-TBP01R2W-50802BE
J4: TBP01R1-508-04BE; TBP01R150804BE; Mouser Part Number 490-TBP01R1-508-04BE
J5, J11, J12, J13, J14: Conn_02x10_Counter_Clockwise; PinSocket_2x10_P2.54mm_Vertical
J7, J8: TBP02R2W-381-08BE; TBP02R2W38108BE; Mouser Part Number 490-TBP02R2W-38108BE
R13: 10k; R_1210_3225Metric_Pad1.30x2.65mm_HandSolder

Connections:
/+3.3V_A: J12.1, J12.4, J12.7, J13.1, J13.4; also elsewhere on the board
/+5V_V: J1.6, J4.1, R13.2; also elsewhere on the board
/+5V_W: J2.6; also elsewhere on the board
/+12V_A: J11.6, J11.8, J11.10, J11.12, J11.14, J12.3, J12.6, J12.9, J13.2, J13.5; also elsewhere on the board
/CAN_24V_OUT: J7.4, J14.4
/CAN_GND: J7.8, J14.8
/CAN_HIGH: J7.7, J14.7
/CAN_JUMPER_A: J7.2, J14.2
/CAN_JUMPER_B: J7.1, J14.1
/CAN_LOW: J7.6, J14.6
/DRIVE_ENABLE_A: J11.4
/FAULT: J13.9; also elsewhere on the board
/GND_A: J11.7, J11.9, J11.11, J11.13, J11.15, J12.2, J12.5, J12.8, J13.3, J13.6; also elsewhere on the board
/GND_V: J1.1, J4.3; also elsewhere on the board
/GND_W: J2.1; also elsewhere on the board
/HALL_PH_U_W: J2.5; also elsewhere on the board
/HALL_PH_V_W: J2.3; also elsewhere on the board
/HALL_PH_W_W: J2.4; also elsewhere on the board
/HEATSINK_TMP_V: J4.2, R13.1; also elsewhere on the board
/MTR_TMP_W: J2.2; also elsewhere on the board
/PH_U_H: J13.15; also elsewhere on the board
/PH_U_L: J13.14; also elsewhere on the board
/PH_V_H: J13.13; also elsewhere on the board
/PH_V_L: J13.12; also elsewhere on the board
/PH_W_H: J13.11; also elsewhere on the board
/PH_W_L: J13.10; also elsewhere on the board
/Power/GND_Z: J3.2; also elsewhere on the board
/Power/VIN_Z: J3.1; also elsewhere on the board
/READY: J13.8; also elsewhere on the board
/REGEN_THROTTLE_V: J1.4; also elsewhere on the board
/RELAY1_COM: J5.12, J8.7
/RELAY1_NO: J5.9, J8.8
/RELAY2_COM: J5.8, J8.6
/RELAY2_NO: J5.5, J8.5
/RELAY3_COM: J5.4, J8.4
/RELAY3_NO: J5.1, J8.3
/RELAY_1_A: J11.1; also elsewhere on the board
/RELAY_2_A: J11.2; also elsewhere on the board
/RELAY_3_A: J11.3; also elsewhere on the board
/RESET: J13.7; also elsewhere on the board
/SPARE_V: J1.3; also elsewhere on the board
/SPI1_CAN_CS_A: J13.17; also elsewhere on the board
/SPI1_CAN_INT_A: J13.16; also elsewhere on the board
/SPI1_RX_A: J13.18; also elsewhere on the board
/SPI1_SCK_A: J13.20; also elsewhere on the board
/SPI1_TX_A: J13.19; also elsewhere on the board
/SPI2_ADC1_CS_A: J12.13; also elsewhere on the board
/SPI2_ADC2_CS_A: J12.14; also elsewhere on the board
/SPI2_RX_A: J12.10; also elsewhere on the board
/SPI2_SCK_A: J12.12; also elsewhere on the board
/SPI2_TX_A: J12.11; also elsewhere on the board
/THROTTLE_V: J1.2; also elsewhere on the board

Notes on the sheet:
CONNECTOR FROM MAIN BOARD TO CONTROL MODULE ABOVE ADC SPI INPUTS / POWER TO ADCS / GATE DRIVE SIGNALS
CONNECTOR FROM MAIN BOARD TO CONTROL MODULE ABOVE CONTROL INPUTS + POWER TO RELAY SUBSYSTEM/GATE DRIVERS
CANBUS OUTPUT CONNECTOR TO CONTROL BOARD INTERFACES TO OUTSIDE WORLD
CONNECTION FROM MAINBOARD TO CONTROL MODULE ABOVE PROVIDES RELAY OUTPUTS + GATE DRIVER INTERLOCK
CONNECTOR FROM MAIN BOARD TO CONTROL MODULE ABOVE ADC SPI INPUTS / POWER TO ADCS

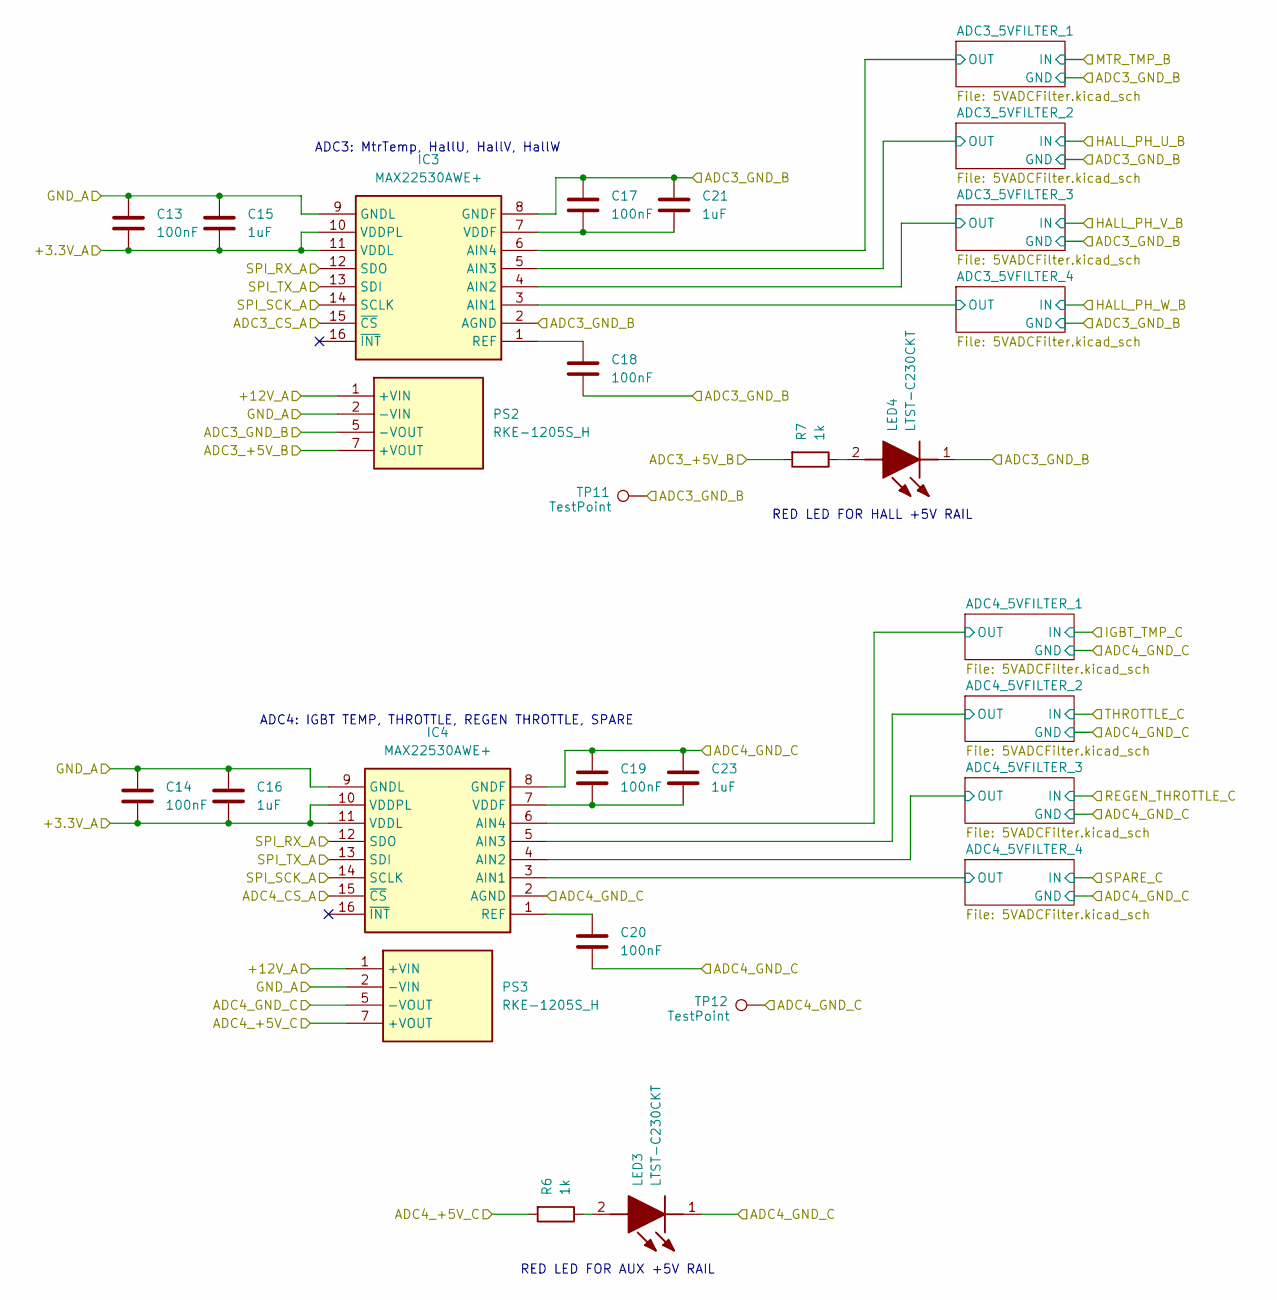
[picture p85: schematic ADC2.kicad_sch]

Parts:
C13, C14, C17, C18, C19, C20: 100nF; C_1210_3225Metric_Pad1.33x2.70mm_HandSolder
C15, C16, C21, C23: 1uF; C_1210_3225Metric_Pad1.33x2.70mm_HandSolder
IC3, IC4: MAX22530AWE+; SOIC127P1032X265-16N; Mouser Part Number 700-MAX22530AWE+
LED3, LED4: LTST-C230CKT; LEDC3216X120N; Mouser Part Number 859-LTST-C230CKT
PS2, PS3: RKE-1205S_H; RKE1205SH; Mouser Part Number 919-RKE-1205S/H
R6, R7: 1k; R_1210_3225Metric_Pad1.30x2.65mm_HandSolder
TP11, TP12: TestPoint; TestPoint_Loop_D2.54mm_Drill1.5mm_Beaded

Connections:
/+3.3V_A: C13.2, C14.2, C15.2, C16.2, IC3.10 (VDDPL), IC3.11 (VDDL), IC4.10 (VDDPL), IC4.11 (VDDL); also elsewhere on the board
/+5V_V: PS3.7 (+VOUT), R6.2; also elsewhere on the board
/+5V_W: PS2.7 (+VOUT), R7.2; also elsewhere on the board
/+12V_A: PS2.1 (+VIN), PS3.1 (+VIN); also elsewhere on the board
/ADC_2/ADC3_5VFILTER_1/OUT: IC3.6 (AIN4); also elsewhere on the board
/ADC_2/ADC3_5VFILTER_2/OUT: IC3.5 (AIN3); also elsewhere on the board
/ADC_2/ADC3_5VFILTER_3/OUT: IC3.4 (AIN2); also elsewhere on the board
/ADC_2/ADC3_5VFILTER_4/OUT: IC3.3 (AIN1); also elsewhere on the board
/ADC_2/ADC4_5VFILTER_1/OUT: IC4.6 (AIN4); also elsewhere on the board
/ADC_2/ADC4_5VFILTER_2/OUT: IC4.5 (AIN3); also elsewhere on the board
/ADC_2/ADC4_5VFILTER_3/OUT: IC4.4 (AIN2); also elsewhere on the board
/ADC_2/ADC4_5VFILTER_4/OUT: IC4.3 (AIN1); also elsewhere on the board
/GND_A: C13.1, C14.1, C15.1, C16.1, IC3.9 (GNDL), IC4.9 (GNDL), PS2.2 (-VIN), PS3.2 (-VIN); also elsewhere on the board
/GND_V: C19.1, C20.2, C23.1, IC4.2 (AGND), IC4.8 (GNDF), LED3.1 (K), PS3.5 (-VOUT), TP12.1; also elsewhere on the board
/GND_W: C17.1, C18.2, C21.1, IC3.2 (AGND), IC3.8 (GNDF), LED4.1 (K), PS2.5 (-VOUT), TP11.1; also elsewhere on the board
/SPI2_ADC3_CS_A: IC3.15 (~CS); also elsewhere on the board
/SPI2_ADC4_CS_A: IC4.15 (~CS); also elsewhere on the board
/SPI2_RX_A: IC3.12 (SDO), IC4.12 (SDO); also elsewhere on the board
/SPI2_SCK_A: IC3.14 (SCLK), IC4.14 (SCLK); also elsewhere on the board
/SPI2_TX_A: IC3.13 (SDI), IC4.13 (SDI); also elsewhere on the board
unnamed: C18.1, IC3.1 (REF)
unnamed: C17.2, C21.2, IC3.7 (VDDF)
unnamed: C20.1, IC4.1 (REF)
unnamed: C19.2, C23.2, IC4.7 (VDDF)
unnamed: LED3.2 (A), R6.1
unnamed: LED4.2 (A), R7.1

Notes on the sheet:
RED LED FOR AUX +5V RAIL
RED LED FOR HALL +5V RAIL
ADC3: MtrTemp, HallU, HallV, HallW
ADC4: IGBT TEMP, THROTTLE, REGEN THROTTLE, SPARE

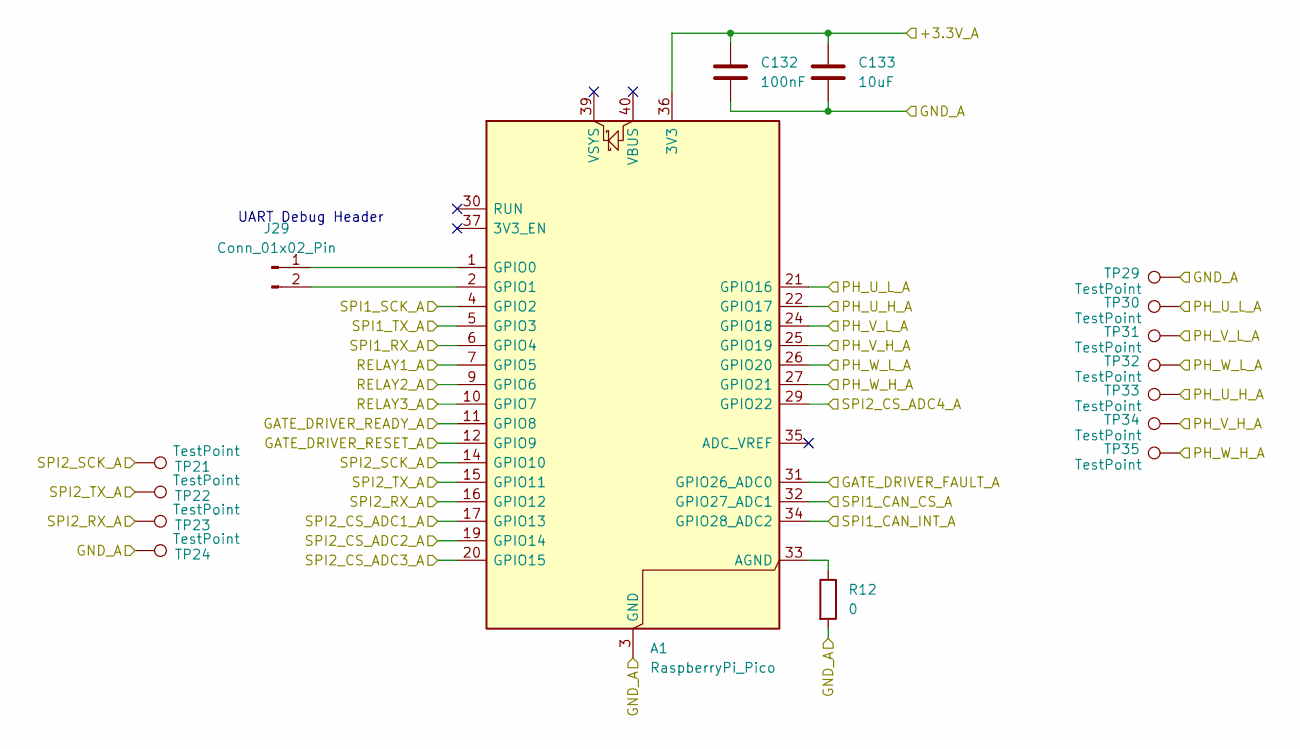
[picture p86: schematic Control.kicad_sch]

Parts:
A1: RaspberryPi_Pico; RaspberryPi_Pico_Common_THT
C132: 100nF; C_1210_3225Metric_Pad1.33x2.70mm_HandSolder
C133: 10uF; C_1210_3225Metric_Pad1.33x2.70mm_HandSolder
J29: Conn_01x02_Pin; PinHeader_1x02_P2.54mm_Vertical
R12: 0; R_1210_3225Metric_Pad1.30x2.65mm_HandSolder
TP21, TP22, TP23, TP24, TP29, TP30, TP31, TP32, TP33, TP34, TP35: TestPoint; TestPoint_Loop_D2.54mm_Drill1.5mm_Beaded

Connections:
/+3.3V_A: A1.36 (3V3), C132.1, C133.1; also elsewhere on the board
/FAULT: A1.31 (GPIO26_ADC0); also elsewhere on the board
/GND_A: A1.3 (GND), A1.8 (GND), A1.13 (GND), A1.18 (GND), A1.23 (GND), A1.28 (GND), A1.38 (GND), C132.2, C133.2, R12.2, TP24.1, TP29.1; also elsewhere on the board
/PH_U_H: A1.22 (GPIO17), TP33.1; also elsewhere on the board
/PH_U_L: A1.21 (GPIO16), TP30.1; also elsewhere on the board
/PH_V_H: A1.25 (GPIO19), TP34.1; also elsewhere on the board
/PH_V_L: A1.24 (GPIO18), TP31.1; also elsewhere on the board
/PH_W_H: A1.27 (GPIO21), TP35.1; also elsewhere on the board
/PH_W_L: A1.26 (GPIO20), TP32.1; also elsewhere on the board
/READY: A1.11 (GPIO8); also elsewhere on the board
/RELAY_1_A: A1.7 (GPIO5); also elsewhere on the board
/RELAY_2_A: A1.9 (GPIO6); also elsewhere on the board
/RELAY_3_A: A1.10 (GPIO7); also elsewhere on the board
/RESET: A1.12 (GPIO9); also elsewhere on the board
/SPI1_CAN_CS_A: A1.32 (GPIO27_ADC1); also elsewhere on the board
/SPI1_CAN_INT_A: A1.34 (GPIO28_ADC2); also elsewhere on the board
/SPI1_RX_A: A1.6 (GPIO4); also elsewhere on the board
/SPI1_SCK_A: A1.4 (GPIO2); also elsewhere on the board
/SPI1_TX_A: A1.5 (GPIO3); also elsewhere on the board
/SPI2_ADC1_CS_A: A1.17 (GPIO13); also elsewhere on the board
/SPI2_ADC2_CS_A: A1.19 (GPIO14); also elsewhere on the board
/SPI2_ADC3_CS_A: A1.20 (GPIO15); also elsewhere on the board
/SPI2_ADC4_CS_A: A1.29 (GPIO22); also elsewhere on the board
/SPI2_RX_A: A1.16 (GPIO12), TP23.1; also elsewhere on the board
/SPI2_SCK_A: A1.14 (GPIO10), TP21.1; also elsewhere on the board
/SPI2_TX_A: A1.15 (GPIO11), TP22.1; also elsewhere on the board
unnamed: A1.33 (AGND), R12.1
unnamed: A1.1 (GPIO0), J29.1
unnamed: A1.2 (GPIO1), J29.2

Notes on the sheet:
UART Debug Header

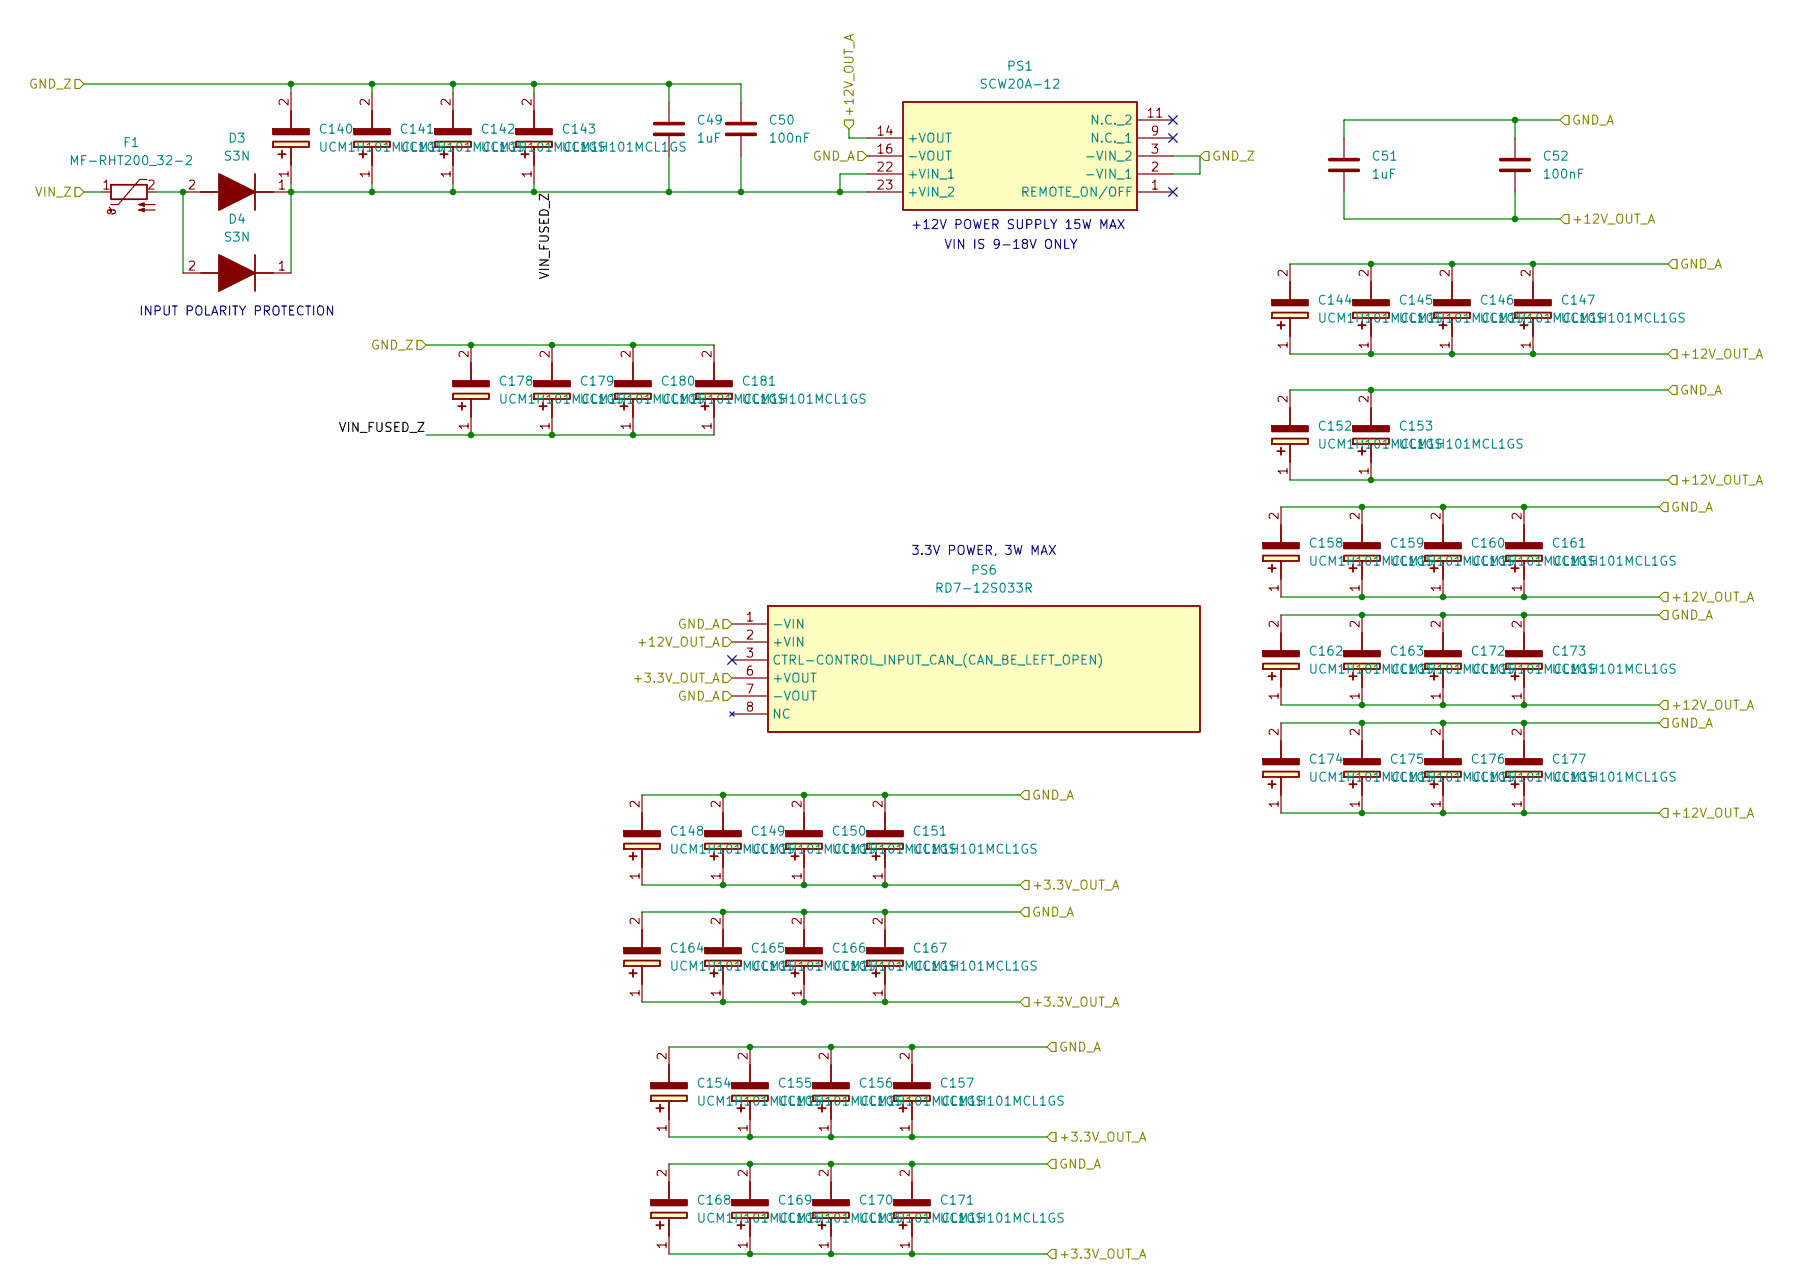
[picture p87: schematic Power.kicad_sch]

Parts:
C49, C51: 1uF; C_1210_3225Metric_Pad1.33x2.70mm_HandSolder
C50, C52: 100nF; C_1210_3225Metric_Pad1.33x2.70mm_HandSolder
C140, C141, C142, C143, C144, C145, C146, C147, C148, C149, C150, C151, C152, C153, C154, C155, C156, C157, C158, C159, C160, C161, C162, C163, C164, C165, C166, C167, C168, C169, C170, C171, C172, C173, C174, C175, C176, C177, C178, C179, C180, C181: UCM1H101MCL1GS; CAPAE660X800N; Mouser Part Number 647-UCM1H101MCL1GS
D3, D4: S3N; DIOM8059X265N; Mouser Part Number 512-S3N
F1: MF-RHT200_32-2; MFRHT200322; Mouser Part Number 652-MF-RHT200/32-2
PS1: SCW20A-12; SCW20A12; Mouser Part Number 709-SCW20A-15
PS6: RD7-12S033R; RD712S033R; Manufacturer_Part_Number RD7-12S033R

Connections:
/+3.3V_A: C148.1 (+), C149.1 (+), C150.1 (+), C151.1 (+), C154.1 (+), C155.1 (+), C156.1 (+), C157.1 (+), C164.1 (+), C165.1 (+), C166.1 (+), C167.1 (+), C168.1 (+), C169.1 (+), C170.1 (+), C171.1 (+), PS6.6 (+VOUT); also elsewhere on the board
/+12V_A: C51.2, C52.2, C144.1 (+), C145.1 (+), C146.1 (+), C147.1 (+), C152.1 (+), C153.1 (+), C158.1 (+), C159.1 (+), C160.1 (+), C161.1 (+), C162.1 (+), C163.1 (+), C172.1 (+), C173.1 (+), C174.1 (+), C175.1 (+), C176.1 (+), C177.1 (+), PS1.14 (+VOUT), PS6.2 (+VIN); also elsewhere on the board
/GND_A: C51.1, C52.1, C144.2 (-), C145.2 (-), C146.2 (-), C147.2 (-), C148.2 (-), C149.2 (-), C150.2 (-), C151.2 (-), C152.2 (-), C153.2 (-), C154.2 (-), C155.2 (-), C156.2 (-), C157.2 (-), C158.2 (-), C159.2 (-), C160.2 (-), C161.2 (-), C162.2 (-), C163.2 (-), C164.2 (-), C165.2 (-), C166.2 (-), C167.2 (-), C168.2 (-), C169.2 (-), C170.2 (-), C171.2 (-), C172.2 (-), C173.2 (-), C174.2 (-), C175.2 (-), C176.2 (-), C177.2 (-), PS1.16 (-VOUT), PS6.1 (-VIN), PS6.7 (-VOUT); also elsewhere on the board
/Power/GND_Z: C49.1, C50.1, C140.2 (-), C141.2 (-), C142.2 (-), C143.2 (-), C178.2 (-), C179.2 (-), C180.2 (-), C181.2 (-), PS1.2 (-VIN_1), PS1.3 (-VIN_2); also elsewhere on the board
/Power/VIN_FUSED_Z: C49.2, C50.2, C140.1 (+), C141.1 (+), C142.1 (+), C143.1 (+), C178.1 (+), C179.1 (+), C180.1 (+), C181.1 (+), D3.1 (K), D4.1 (K), PS1.22 (+VIN_1), PS1.23 (+VIN_2)
/Power/VIN_Z: F1.1; also elsewhere on the board
unnamed: D3.2 (A), D4.2 (A), F1.2

Notes on the sheet:
VIN IS 9-18V ONLY
INPUT POLARITY PROTECTION
3.3V POWER, 3W MAX
+12V POWER SUPPLY 15W MAX

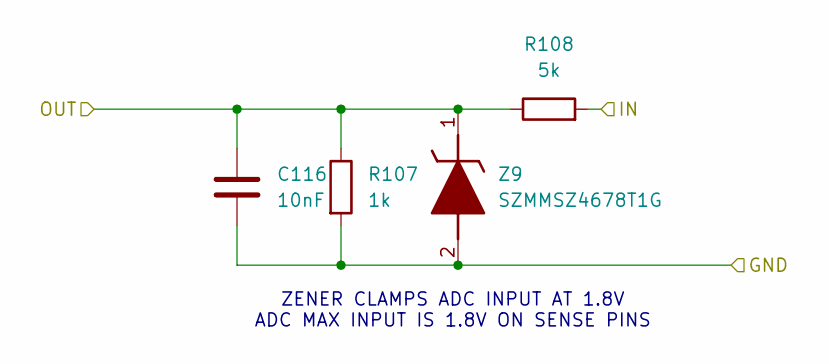
[picture p88: schematic 5VADCFilter.kicad_sch]

Parts:
C116: 10nF; C_1210_3225Metric_Pad1.33x2.70mm_HandSolder
R107: 1k; R_1210_3225Metric_Pad1.30x2.65mm_HandSolder
R108: 5k; R_1210_3225Metric_Pad1.30x2.65mm_HandSolder
Z9: SZMMSZ4678T1G; SOD3716X135N; Mouser Part Number 863-SZMMSZ4678T1G

Connections:
/ADC_2/ADC4_5VFILTER_1/OUT: C116.1, R107.1, R108.1, Z9.1 (K); also elsewhere on the board
/GND_V: C116.2, R107.2, Z9.2 (A); also elsewhere on the board
/HEATSINK_TMP_V: R108.2; also elsewhere on the board

Parts of its further copies:
C117, C118, C119, C120, C121, C122, C123: 10nF; C_1210_3225Metric_Pad1.33x2.70mm_HandSolder
R109, R111, R113, R115, R117, R119, R121: 1k; R_1210_3225Metric_Pad1.30x2.65mm_HandSolder
R110, R112, R114, R116, R118, R120, R122: 5k; R_1210_3225Metric_Pad1.30x2.65mm_HandSolder
Z10, Z11, Z12, Z13, Z14, Z15, Z16: SZMMSZ4678T1G; SOD3716X135N; Mouser Part Number 863-SZMMSZ4678T1G

Connections of its further copies:
/ADC_2/ADC3_5VFILTER_1/OUT: C120.1, R115.1, R116.1, Z13.1 (K); also elsewhere on the board
/ADC_2/ADC3_5VFILTER_2/OUT: C121.1, R117.1, R118.1, Z14.1 (K); also elsewhere on the board
/ADC_2/ADC3_5VFILTER_3/OUT: C122.1, R119.1, R120.1, Z15.1 (K); also elsewhere on the board
/ADC_2/ADC3_5VFILTER_4/OUT: C123.1, R121.1, R122.1, Z16.1 (K); also elsewhere on the board
/ADC_2/ADC4_5VFILTER_2/OUT: C117.1, R109.1, R110.1, Z10.1 (K); also elsewhere on the board
/ADC_2/ADC4_5VFILTER_3/OUT: C118.1, R111.1, R112.1, Z11.1 (K); also elsewhere on the board
/ADC_2/ADC4_5VFILTER_4/OUT: C119.1, R113.1, R114.1, Z12.1 (K); also elsewhere on the board
/GND_V: C117.2, C118.2, C119.2, R109.2, R111.2, R113.2, Z10.2 (A), Z11.2 (A), Z12.2 (A); also elsewhere on the board
/GND_W: C120.2, C121.2, C122.2, C123.2, R115.2, R117.2, R119.2, R121.2, Z13.2 (A), Z14.2 (A), Z15.2 (A), Z16.2 (A); also elsewhere on the board
/HALL_PH_U_W: R118.2; also elsewhere on the board
/HALL_PH_V_W: R120.2; also elsewhere on the board
/HALL_PH_W_W: R122.2; also elsewhere on the board
/MTR_TMP_W: R116.2; also elsewhere on the board
/REGEN_THROTTLE_V: R112.2; also elsewhere on the board
/SPARE_V: R114.2; also elsewhere on the board
/THROTTLE_V: R110.2; also elsewhere on the board

Notes on the sheet:
ZENER CLAMPS ADC INPUT AT 1.8V ADC MAX INPUT IS 1.8V ON SENSE PINS

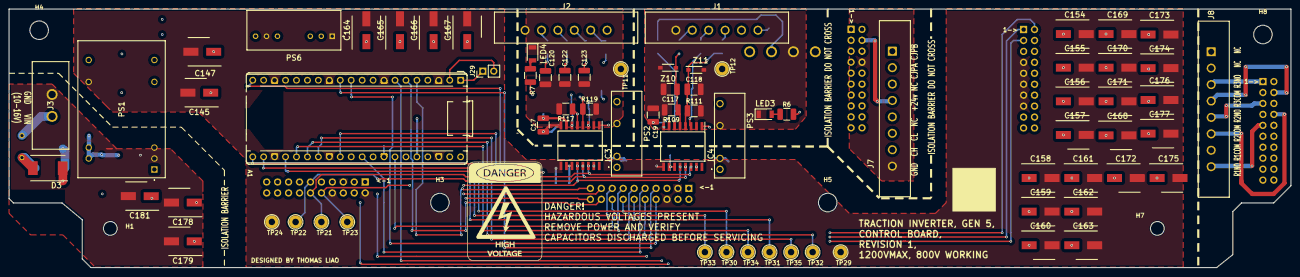
[picture p89: board ControlBoard.kicad_pcb from above]

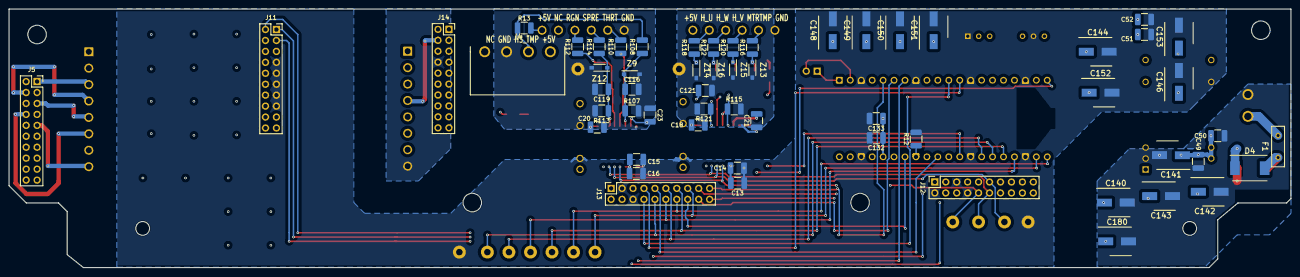
[picture p90: board ControlBoard.kicad_pcb from below]

Board: 6 copper layers, 297.5 x 60.0 mm, 137 parts (58 on the bottom side), 72 nets.
