datacrystals/InverterGen5/Boards/DCBusFilter/DCBusFilter.kicad_pcb

## KiCad design Boards/DCBusFilter/DCBusFilter.kicad_pcb (2026-02-06)

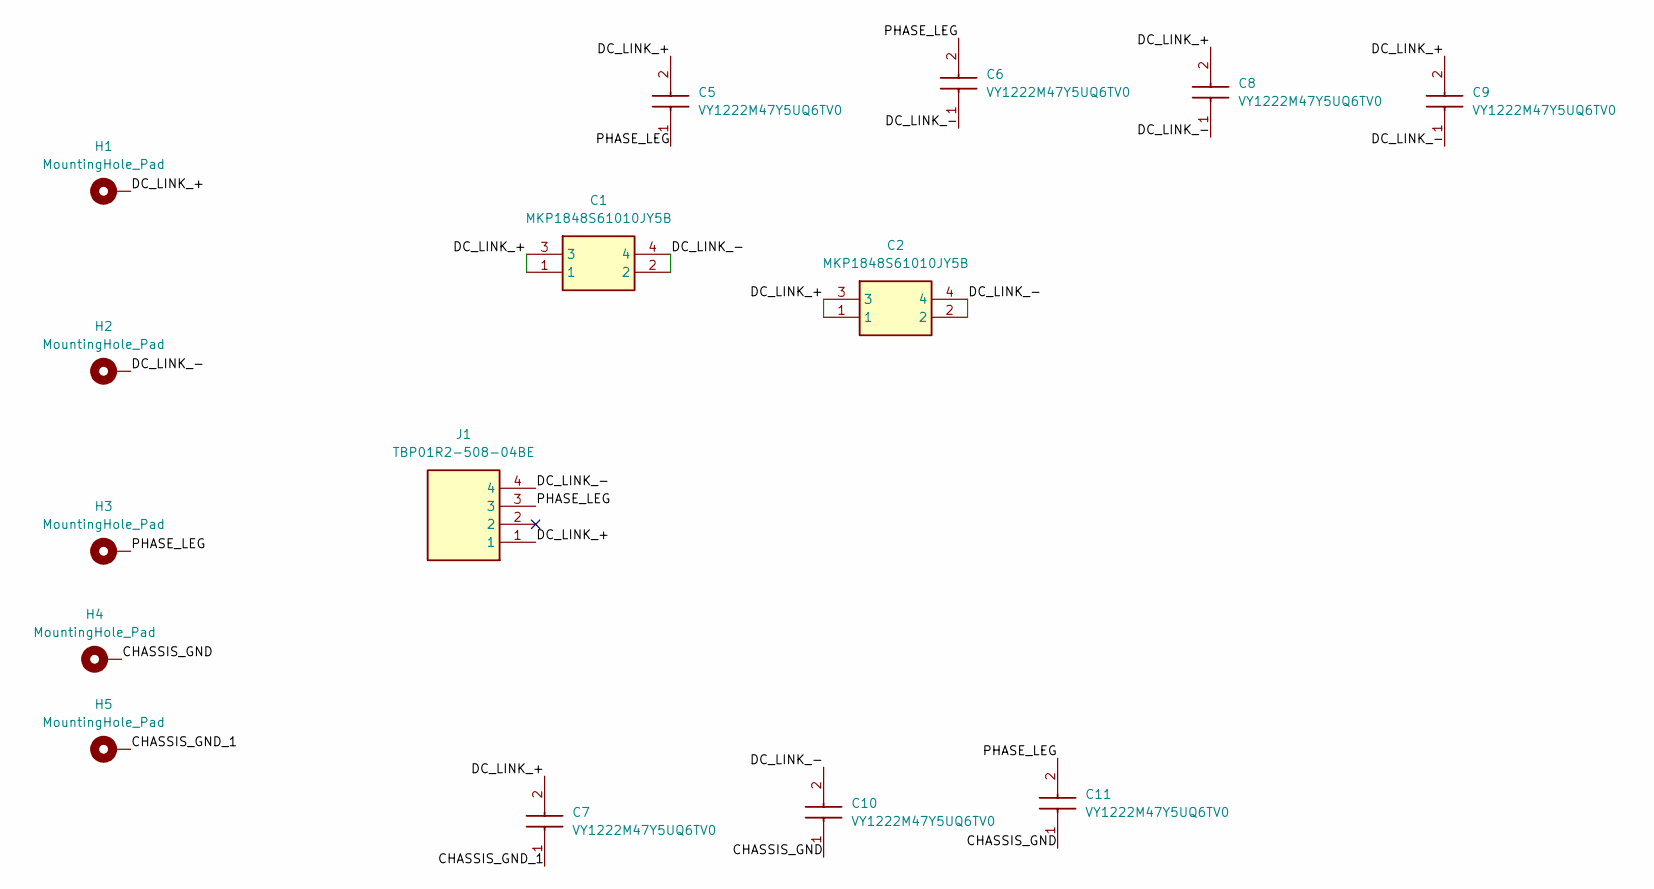
[picture p91: schematic DCBusFilter.kicad_sch]

Parts:
C1, C2: MKP1848S61010JY5B; Mouser Part Number 75-MKP1848S61010JY5B
C5, C6, C7, C8, C9, C10, C11: VY1222M47Y5UQ6TV0; Mouser Part Number 72-VY1222M47Y5UQ6TV0
H1, H2, H3: MountingHole_Pad; MountingHole_6.4mm_M6_ISO14580_Pad
H4, H5: MountingHole_Pad; MountingHole_3.2mm_M3_ISO14580_Pad
J1: TBP01R2-508-04BE; SHDR4W100P0X508_1X4_2192X850X1200P; Mouser Part Number 490-TBP01R2-508-04BE

Connections:
/CHASSIS_GND: C10.1, C11.1, H4.1
/CHASSIS_GND_1: C7.1, H5.1
/DC_LINK_+: C1.1, C1.3, C2.1, C2.3, C5.2, C7.2, C8.2, C9.2, H1.1, J1.1
/DC_LINK_-: C1.2, C1.4, C2.2, C2.4, C6.1, C8.1, C9.1, C10.2, H2.1, J1.4
/PHASE_LEG: C5.1, C6.2, C11.2, H3.1, J1.3
