datacrystals/InverterGen5/Boards/DCBusFilter/DCBusFilter.kicad_pcb

## KiCad design Boards/DCBusFilter/DCBusFilter.kicad_pcb (continued)

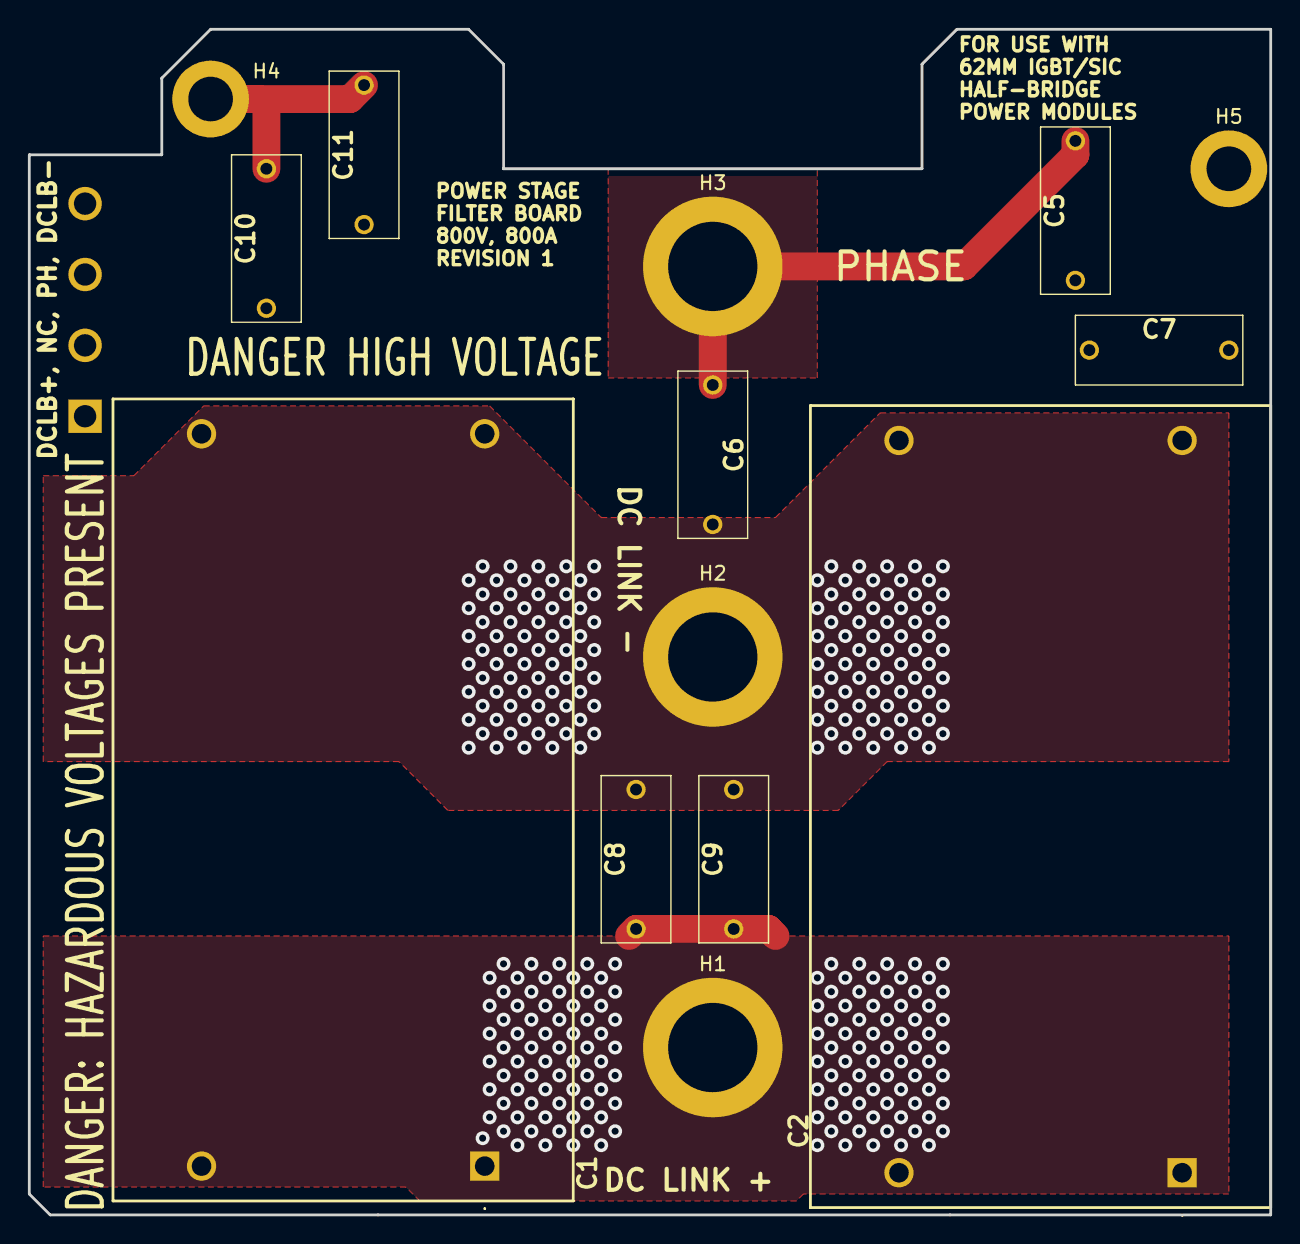
[picture p92: board DCBusFilter.kicad_pcb from above]

Board: 4 copper layers, 89.0 x 85.0 mm, 15 parts (1 on the bottom side), 5 nets.
