datacrystals/InverterGen5/Boards/DCBusCapacitorBoard/DCBusCapacitorBoard.kicad_pcb

## KiCad design Boards/DCBusCapacitorBoard/DCBusCapacitorBoard.kicad_pcb (2026-02-06)

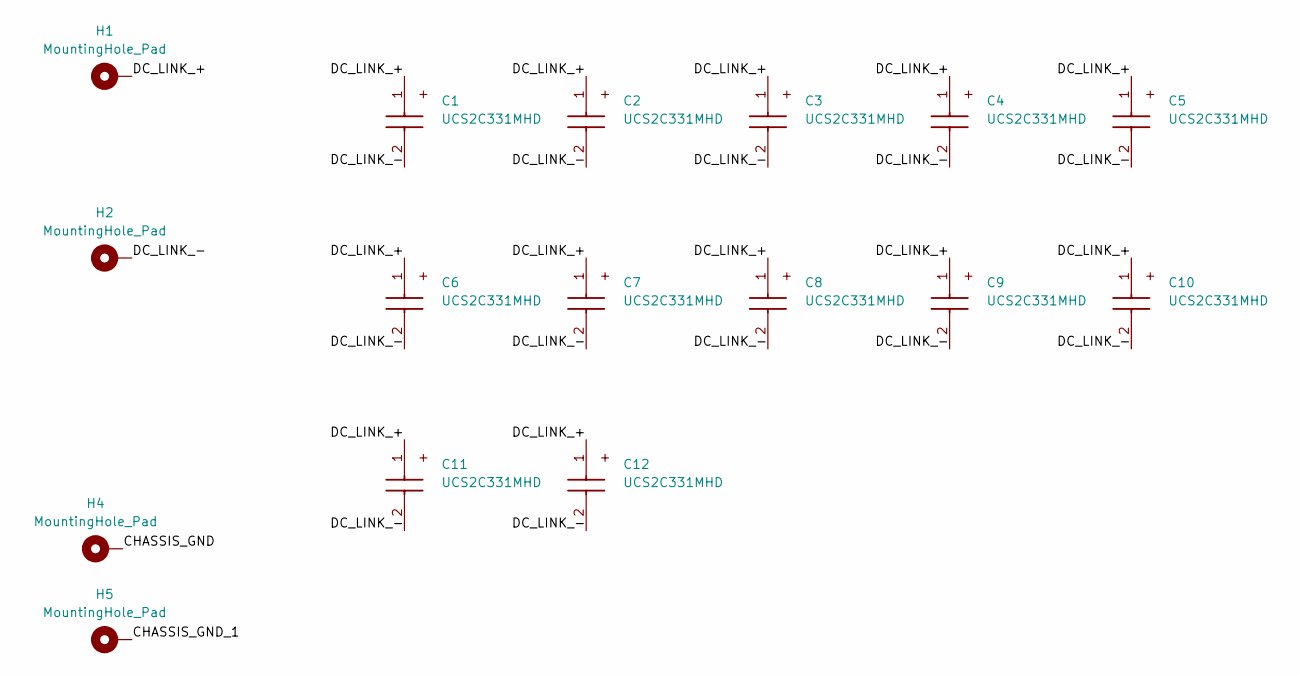
[picture p93: schematic DCBusCapacitorBoard.kicad_sch]

Parts:
C1, C2, C3, C4, C5, C6, C7, C8, C9, C10, C11, C12: UCS2C331MHD; CAPPRD750W80D1825H3200; Mouser Part Number 647-UCS2C331MHD
H1, H2: MountingHole_Pad; MountingHole_6.4mm_M6_ISO14580_Pad
H4, H5: MountingHole_Pad; MountingHole_3.2mm_M3_ISO14580_Pad

Connections:
/CHASSIS_GND: H4.1
/CHASSIS_GND_1: H5.1
/DC_LINK_+: C1.1 (+), C2.1 (+), C3.1 (+), C4.1 (+), C5.1 (+), C6.1 (+), C7.1 (+), C8.1 (+), C9.1 (+), C10.1 (+), C11.1 (+), C12.1 (+), H1.1
/DC_LINK_-: C1.2 (-), C2.2 (-), C3.2 (-), C4.2 (-), C5.2 (-), C6.2 (-), C7.2 (-), C8.2 (-), C9.2 (-), C10.2 (-), C11.2 (-), C12.2 (-), H2.1

Board: 4 copper layers, 16 parts (0 on the bottom side), 2 nets, no tracks yet.
