datacrystals/InverterGen5/Boards/GateDriver/GateDriver.kicad_pcb

## KiCad design Boards/GateDriver/GateDriver.kicad_pcb (2026-01-31)

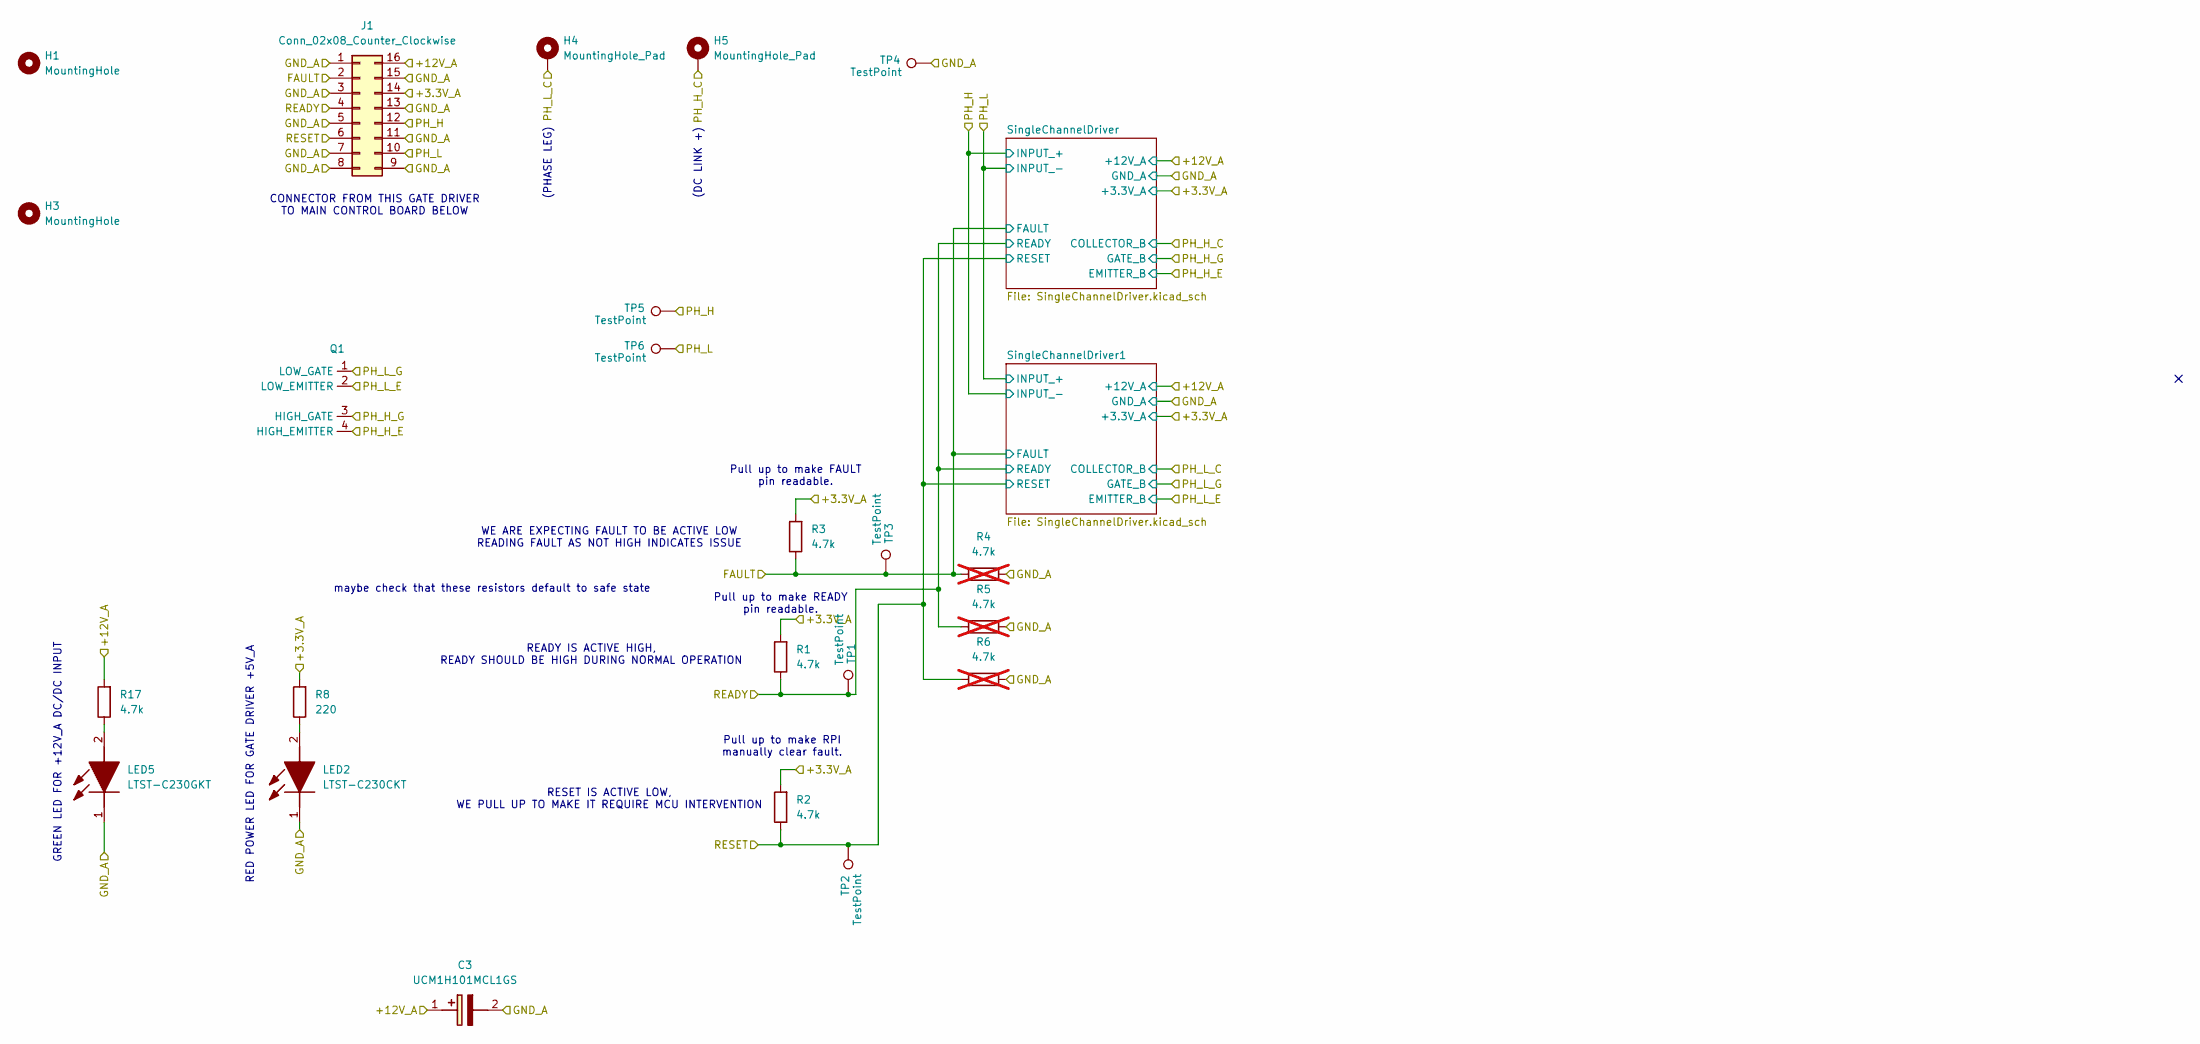
[picture p94: schematic GateDriver.kicad_sch]

Parts:
C3: UCM1H101MCL1GS; CAPAE660X800N; Mouser Part Number 647-UCM1H101MCL1GS
H1, H3: MountingHole; MountingHole_5.3mm_M5
H4, H5: MountingHole_Pad; MountingHole_2.2mm_M2_Pad
J1: Conn_02x08_Counter_Clockwise; PinHeader_2x08_P2.54mm_Vertical
LED2: LTST-C230CKT; LEDC3216X120N; Mouser Part Number 859-LTST-C230CKT
LED5: LTST-C230GKT; LEDC3216X120N; Mouser Part Number 859-LTST-C230GKT
Q1: 62mm_power_module
R1, R2, R3, R17: 4.7k; R_1210_3225Metric_Pad1.30x2.65mm_HandSolder
R4, R5, R6: 4.7k; R_1210_3225Metric_Pad1.30x2.65mm_HandSolder; not fitted
R8: 220; R_1210_3225Metric_Pad1.30x2.65mm_HandSolder
TP1, TP2, TP3, TP4, TP5, TP6: TestPoint; TestPoint_Loop_D2.54mm_Drill1.5mm_Beaded

Connections:
/+3.3V_A: J1.14, R1.2, R2.2, R3.2, R8.2; also elsewhere on the board
/+12V_A: C3.1 (+), J1.16, R17.2; also elsewhere on the board
/FAULT: J1.2, R3.1, R4.2, TP3.1; also elsewhere on the board
/GND_A: C3.2 (-), J1.1, J1.3, J1.5, J1.7, J1.8, J1.9, J1.11, J1.13, J1.15, LED2.1 (K), LED5.1 (K), R4.1, R5.1, R6.1, TP4.1; also elsewhere on the board
/PH_H: J1.12, TP5.1; also elsewhere on the board
/PH_H_C: H5.1; also elsewhere on the board
/PH_H_G: Q1.3 (HIGH_GATE); also elsewhere on the board
/PH_L: J1.10, TP6.1; also elsewhere on the board
/PH_L_C: H4.1; also elsewhere on the board
/PH_L_G: Q1.1 (LOW_GATE); also elsewhere on the board
/READY: J1.4, R1.1, R5.2, TP1.1; also elsewhere on the board
/RESET: J1.6, R2.1, R6.2, TP2.1; also elsewhere on the board
/SingleChannelDriver1/GND_B: Q1.2 (LOW_EMITTER); also elsewhere on the board
/SingleChannelDriver/GND_B: Q1.4 (HIGH_EMITTER); also elsewhere on the board
unnamed: LED2.2 (A), R8.1
unnamed: LED5.2 (A), R17.1

Notes on the sheet:
Pull up to make READY pin readable.
Pull up to make FAULT pin readable.
Pull up to make RPI manually clear fault.
(DC LINK +)
CONNECTOR FROM THIS GATE DRIVER TO MAIN CONTROL BOARD BELOW
READY IS ACTIVE HIGH, READY SHOULD BE HIGH DURING NORMAL OPERATION
RESET IS ACTIVE LOW, WE PULL UP TO MAKE IT REQUIRE MCU INTERVENTION
GREEN LED FOR +12V_A DC/DC INPUT
WE ARE EXPECTING FAULT TO BE ACTIVE LOW READING FAULT AS NOT HIGH INDICATES ISSUE
RED POWER LED FOR GATE DRIVER +5V_A
(PHASE LEG)
maybe check that these resistors default to safe state

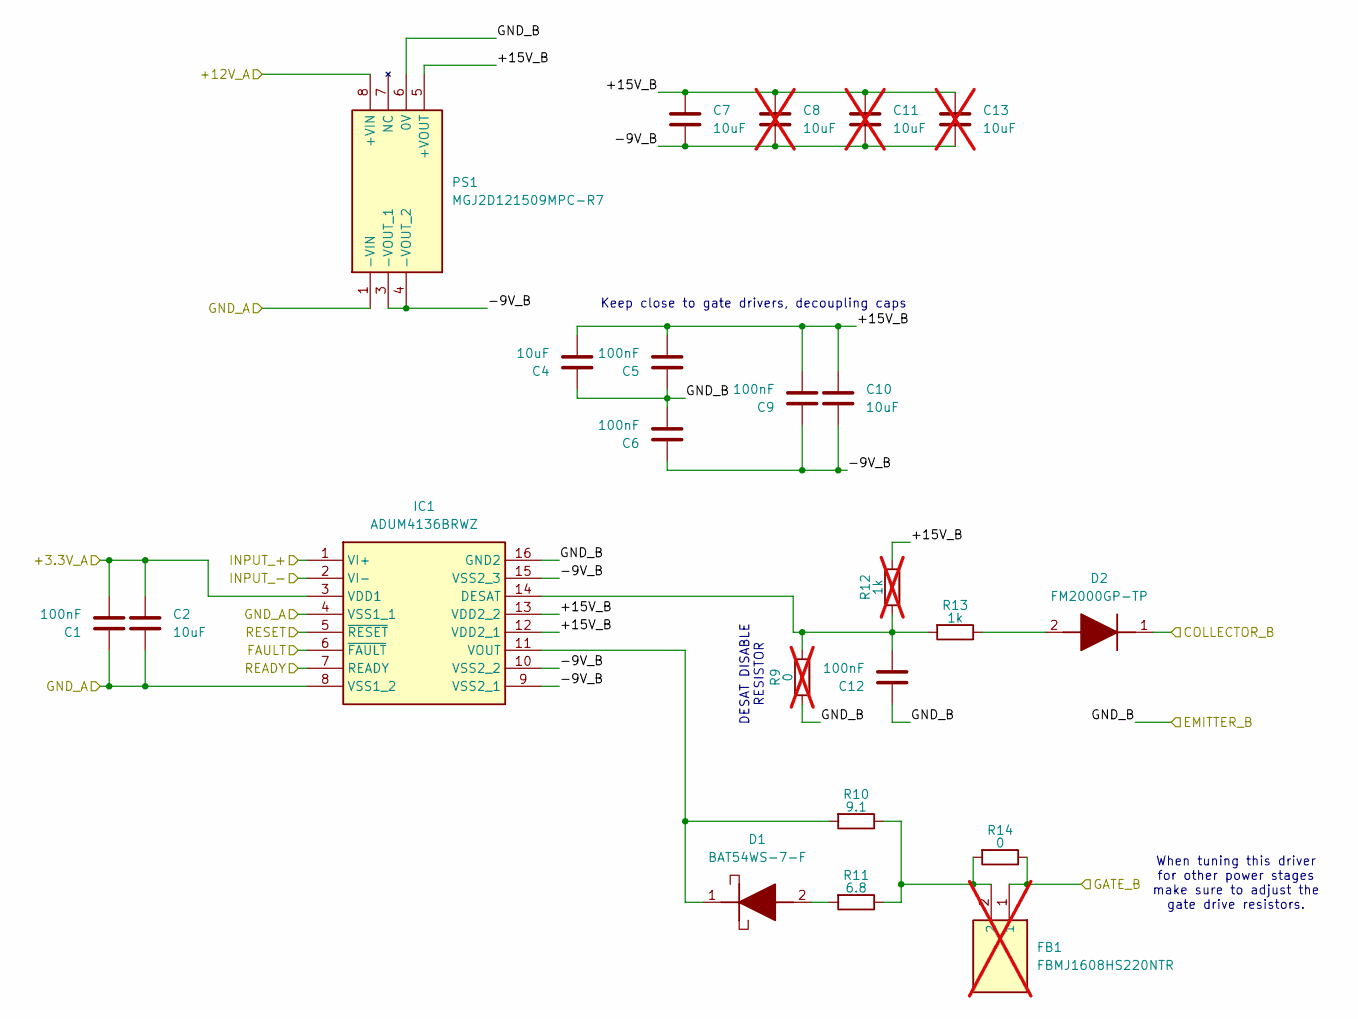
[picture p95: schematic SingleChannelDriver.kicad_sch]

Parts:
C1, C5, C6, C9, C12: 100nF; C_1210_3225Metric_Pad1.33x2.70mm_HandSolder
C2, C4, C7, C10: 10uF; C_1210_3225Metric_Pad1.33x2.70mm_HandSolder
C8, C11, C13: 10uF; C_1210_3225Metric_Pad1.33x2.70mm_HandSolder; not fitted
D1: BAT54WS-7-F; SOD2513X120N; Mouser Part Number 621-BAT54WS-F
D2: FM2000GP-TP; DIOM5226X244N; Mouser Part Number 833-FM2000GP-TP
FB1: FBMJ1608HS220NTR; BEADC1608X100N; Mouser Part Number 963-FBMJ1608HS220NTR; not fitted
IC1: ADUM4136BRWZ; SOIC127P1032X265-16N; Mouser Part Number 584-ADUM4136BRWZ
PS1: MGJ2D121509MPC-R7; MGJ2D121509MPCR7; Mouser Part Number 580-MGJ2D121509MPCR7
R9: 0; R_1210_3225Metric_Pad1.30x2.65mm_HandSolder; not fitted
R10: 9.1; R_1210_3225Metric_Pad1.30x2.65mm_HandSolder
R11: 6.8; R_1210_3225Metric_Pad1.30x2.65mm_HandSolder
R12: 1k; R_1210_3225Metric_Pad1.30x2.65mm_HandSolder; not fitted
R13: 1k; R_1210_3225Metric_Pad1.30x2.65mm_HandSolder
R14: 0; R_1210_3225Metric_Pad1.30x2.65mm_HandSolder

Connections:
/+3.3V_A: C1.2, C2.1, IC1.3 (VDD1); also elsewhere on the board
/+12V_A: PS1.8 (+VIN); also elsewhere on the board
/FAULT: IC1.6 (~FAULT); also elsewhere on the board
/GND_A: C1.1, C2.2, IC1.4 (VSS1_1), IC1.8 (VSS1_2), PS1.1 (-VIN); also elsewhere on the board
/PH_H: IC1.2 (VI-); also elsewhere on the board
/PH_L: IC1.1 (VI+); also elsewhere on the board
/PH_L_C: D2.1 (K); also elsewhere on the board
/PH_L_G: FB1.1, R14.1; also elsewhere on the board
/READY: IC1.7 (READY); also elsewhere on the board
/RESET: IC1.5 (~RESET); also elsewhere on the board
/SingleChannelDriver1/+15V_B: C4.2, C5.2, C7.1, C8.1, C9.2, C10.1, C11.1, C13.1, IC1.12 (VDD2_1), IC1.13 (VDD2_2), PS1.5 (+VOUT), R12.1
/SingleChannelDriver1/-9V_B: C6.1, C7.2, C8.2, C9.1, C10.2, C11.2, C13.2, IC1.9 (VSS2_1), IC1.10 (VSS2_2), IC1.15 (VSS2_3), PS1.3 (-VOUT_1), PS1.4 (-VOUT_2)
/SingleChannelDriver1/GND_B: C4.1, C5.1, C6.2, C12.1, IC1.16 (GND2), PS1.6 (0V), R9.2; also elsewhere on the board
unnamed: D1.2 (A), R11.2
unnamed: D1.1 (K), IC1.11 (VOUT), R10.2
unnamed: D2.2 (A), R13.1
unnamed: FB1.2, R10.1, R11.1, R14.2
unnamed: C12.2, IC1.14 (DESAT), R9.1, R12.2, R13.2

Parts of its further copies:
C14, C18, C19, C22, C25: 100nF; C_1210_3225Metric_Pad1.33x2.70mm_HandSolder
C15, C17, C20, C23: 10uF; C_1210_3225Metric_Pad1.33x2.70mm_HandSolder
C21, C24, C26: 10uF; C_1210_3225Metric_Pad1.33x2.70mm_HandSolder; not fitted
D3: BAT54WS-7-F; SOD2513X120N; Mouser Part Number 621-BAT54WS-F
D4: FM2000GP-TP; DIOM5226X244N; Mouser Part Number 833-FM2000GP-TP
FB2: FBMJ1608HS220NTR; BEADC1608X100N; Mouser Part Number 963-FBMJ1608HS220NTR; not fitted
IC2: ADUM4136BRWZ; SOIC127P1032X265-16N; Mouser Part Number 584-ADUM4136BRWZ
PS2: MGJ2D121509MPC-R7; MGJ2D121509MPCR7; Mouser Part Number 580-MGJ2D121509MPCR7
R19: 0; R_1210_3225Metric_Pad1.30x2.65mm_HandSolder; not fitted
R20: 9.1; R_1210_3225Metric_Pad1.30x2.65mm_HandSolder
R21: 6.8; R_1210_3225Metric_Pad1.30x2.65mm_HandSolder
R22: 1k; R_1210_3225Metric_Pad1.30x2.65mm_HandSolder; not fitted
R23: 1k; R_1210_3225Metric_Pad1.30x2.65mm_HandSolder
R24: 0; R_1210_3225Metric_Pad1.30x2.65mm_HandSolder

Connections of its further copies:
/+3.3V_A: C14.2, C15.1, IC2.3 (VDD1); also elsewhere on the board
/+12V_A: PS2.8 (+VIN); also elsewhere on the board
/FAULT: IC2.6 (~FAULT); also elsewhere on the board
/GND_A: C14.1, C15.2, IC2.4 (VSS1_1), IC2.8 (VSS1_2), PS2.1 (-VIN); also elsewhere on the board
/PH_H: IC2.1 (VI+); also elsewhere on the board
/PH_H_C: D4.1 (K); also elsewhere on the board
/PH_H_G: FB2.1, R24.1; also elsewhere on the board
/PH_L: IC2.2 (VI-); also elsewhere on the board
/READY: IC2.7 (READY); also elsewhere on the board
/RESET: IC2.5 (~RESET); also elsewhere on the board
/SingleChannelDriver/+15V_B: C17.2, C18.2, C20.1, C21.1, C22.2, C23.1, C24.1, C26.1, IC2.12 (VDD2_1), IC2.13 (VDD2_2), PS2.5 (+VOUT), R22.1
/SingleChannelDriver/-9V_B: C19.1, C20.2, C21.2, C22.1, C23.2, C24.2, C26.2, IC2.9 (VSS2_1), IC2.10 (VSS2_2), IC2.15 (VSS2_3), PS2.3 (-VOUT_1), PS2.4 (-VOUT_2)
/SingleChannelDriver/GND_B: C17.1, C18.1, C19.2, C25.1, IC2.16 (GND2), PS2.6 (0V), R19.2; also elsewhere on the board
unnamed: D3.2 (A), R21.2
unnamed: D3.1 (K), IC2.11 (VOUT), R20.2
unnamed: D4.2 (A), R23.1
unnamed: FB2.2, R20.1, R21.1, R24.2
unnamed: C25.2, IC2.14 (DESAT), R19.1, R22.2, R23.2

Notes on the sheet:
DESAT DISABLE RESISTOR
When tuning this driver for other power stages make sure to adjust the gate drive resistors.
Keep close to gate drivers, decoupling caps

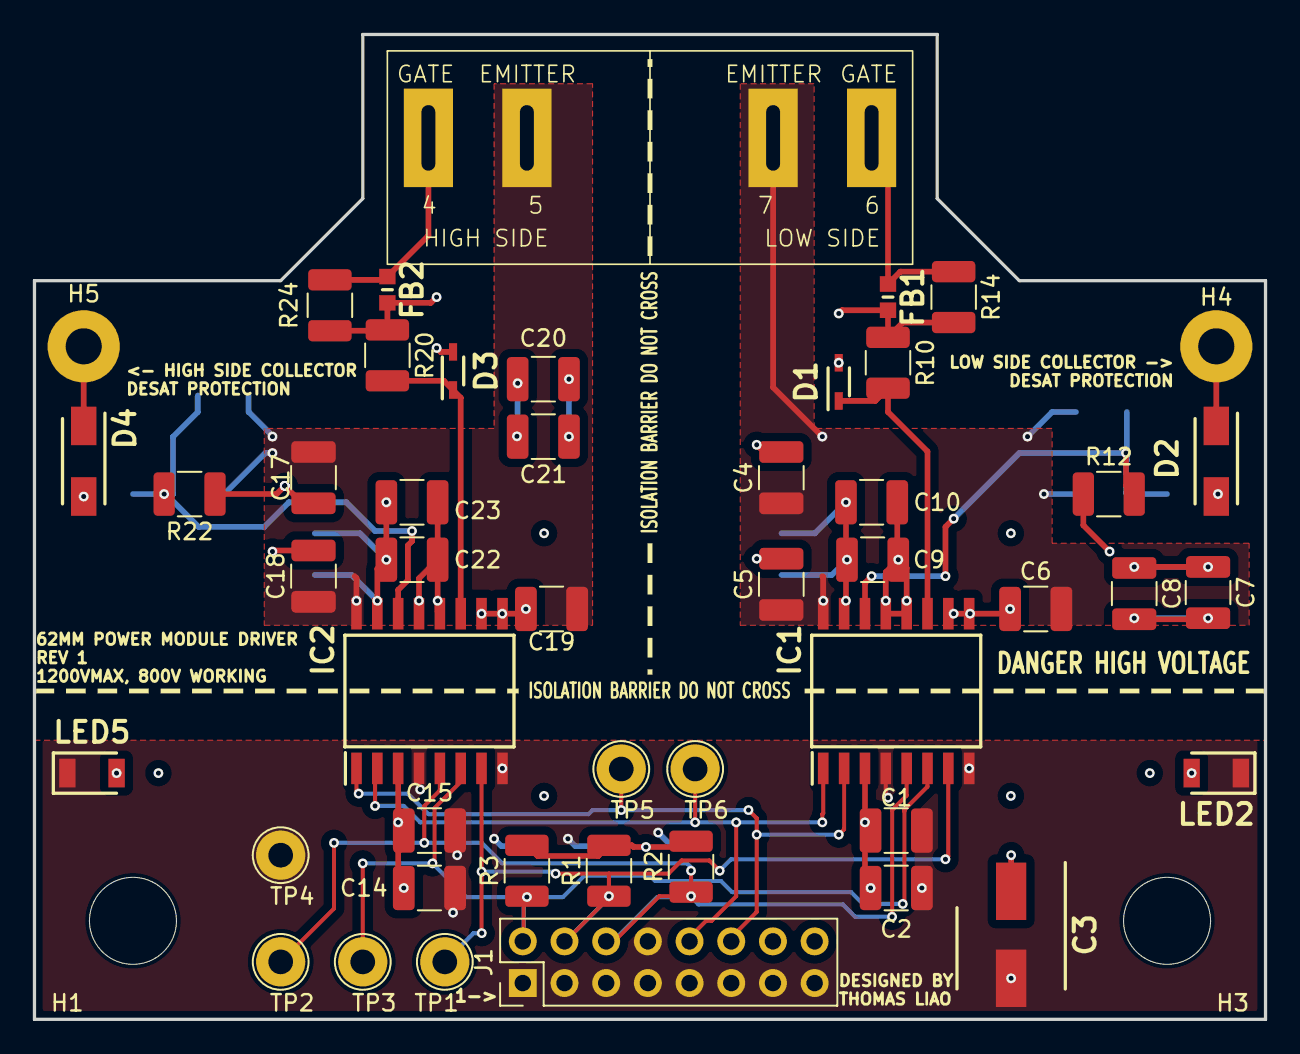
[picture p96: board GateDriver.kicad_pcb from above]

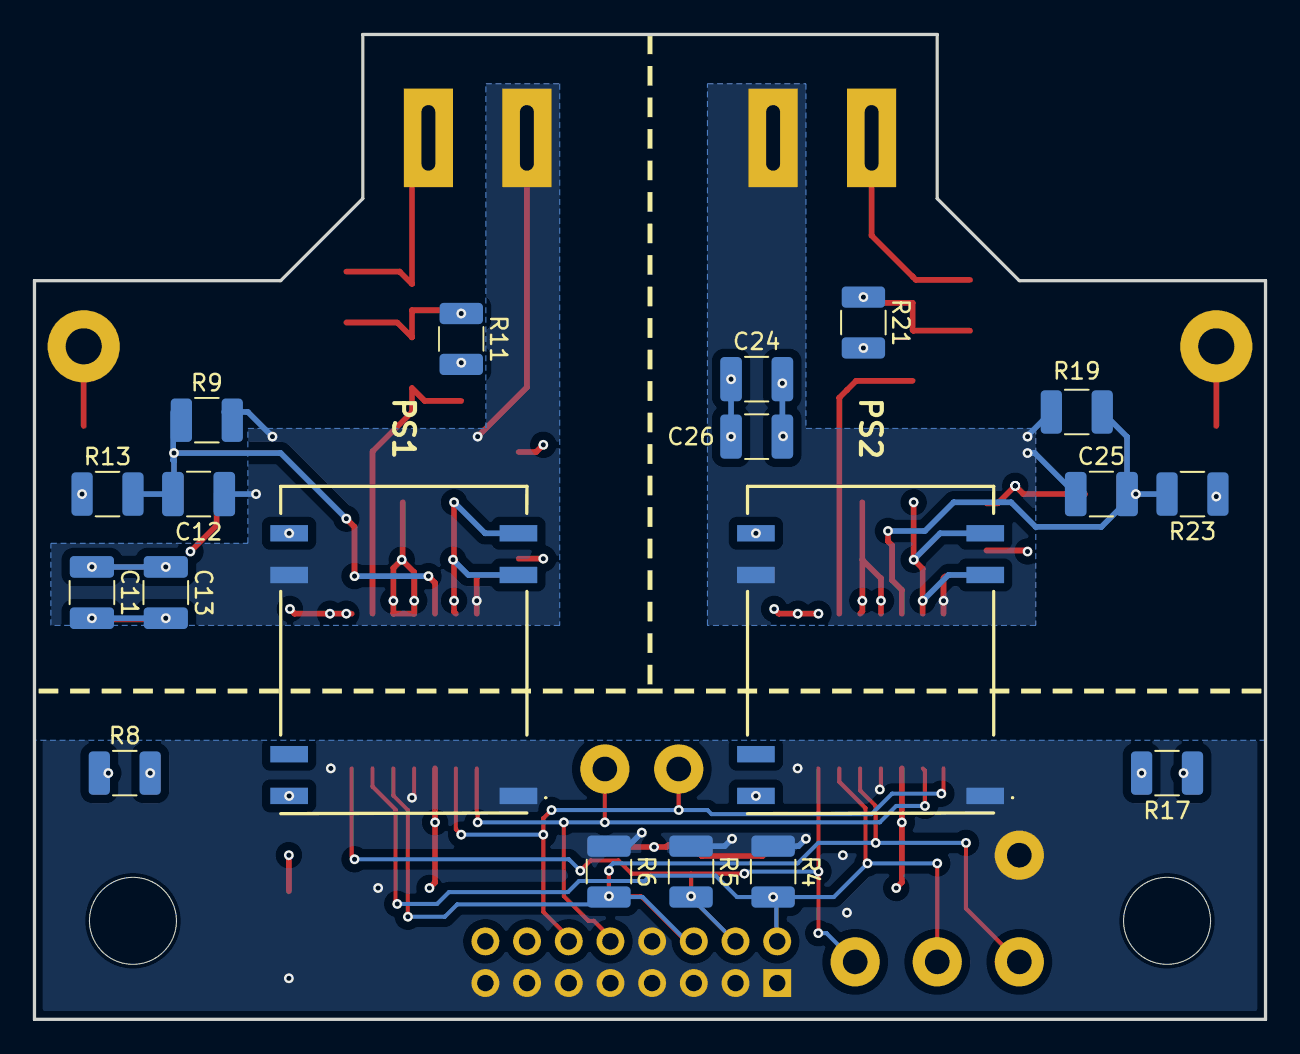
[picture p97: board GateDriver.kicad_pcb from below]

Board: 6 copper layers, 75.0 x 60.0 mm, 69 parts (19 on the bottom side), 30 nets.
