datacrystals/InverterGen5/(commit log)

2026-01-24 layout control boards, add baseplate, refine mechanical layout
    [ADC2.kicad_sch, B57703M0103A019.stp, CAN.kicad_sch, ControlBoard.kicad_pcb, ControlBoard.kicad_sch, DCBusFilter.kicad_pcb, DCBusFilter.kicad_sch, DCBusFilter.step]
2026-01-25 Layout mainboard, add EMI filter caps
    [ControlBoard.kicad_sch, DCBusFilter.kicad_pcb, DCBusFilter.kicad_sch, DCBusFilter.step, MainBoard.kicad_pcb, MainBoard.kicad_sch, OutputRelays.kicad_sch, VY1222M47Y5UQ6TV0.stp]
2026-01-25 Layout controlboard, update cad
    [Control.kicad_sch, ControlBoard.kicad_pcb, ControlBoard.kicad_sch, Power.kicad_sch, RaspberryPi_Pico_W_AddedHeaders.step]
2026-01-27 fix connector pinout
    [ControlBoard.kicad_pcb, ControlBoard.kicad_sch, GateDriver.kicad_pcb, GateDriver.kicad_sch, MainBoard.kicad_pcb, MainBoard.kicad_sch]
2026-02-01 switch to 5mbit spi
2026-02-04 update for zero 75-10 pmsm motor
2026-02-04 fix encoder calibration
2026-02-04 added standoffs and screws
    [91292A134_18-8 Stainless Steel Socket Head Screw.STEP, 971200474.stp, 971200481.stp, 971260321.stp, 971400471.stp]
2026-02-05 added m4 holes
    [91292A112_18-8 Stainless Steel Socket Head Screw.STEP]
2026-02-05 added m3 holes
2026-02-05 extend busbar
    [91290A165_Black-Oxide Alloy Steel Socket Head Screw.STEP]
2026-02-05 good encoder tracking
2026-02-05 working current
2026-02-06 add new caps board
    [971200321.stp, 971200611.stp, 971350321.stp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]
2026-02-06 Add Clearance To Main/CtrlBd, Increase main DCDC to 20w
    [971120321.stp, CAN.kicad_sch, ControlBoard.kicad_pcb, ControlBoard.kicad_sch, MainBoard.kicad_pcb, MainBoard.kicad_sch, Power.kicad_sch, SCW20A-15.stp]
