datacrystals/InverterGen5/(notices)

Notices in the files:
PartsLib/arduino-kicad-library-master/README.md:
CC BY-SA 4.0
CC BY-SA-NC 4.0
